gHashTag/tt-trinity-corona/docs/REPORT_2026-06-03_loop130.md

# Loop 130 Report -- 2026-06-03

## Summary

**Measured the end-to-end accuracy impact of the gf16_mul rounding-overflow defect on
the actual MAC primitive (executes the prior loop's Option B) -- turning "0.072% of
products halved" into the number a respin decision needs. Built two study variants of
the dot-product unit -- `gf16_dot4_v2` (gf16_v2_mul + gf16_v2_add, fully corrected)
and `gf16_dot4_b` (gf16_v2_mul + the original gf16_add, to isolate the mul fix) --
and ran the shipped `gf16_dot4` against both over 20000 representative near-1.0
4-term dot products vs an exact-rational reference (`test/impact_gf16_mul.py`).
Result: the shipped MAC path runs at NMSE 1.49e-4 (~1.22% RMS); fixing the mul alone
drops it to 1.29e-6 (~0.11% RMS) -- a ~115x NMSE / ~11x RMS improvement; the gf16
floor (both fixed) is 5.33e-7 (~0.07%). The mul defect DOMINATES the MAC error
despite hitting only 0.27% of dot products, because halving a term is a huge
per-term error. A surprising by-product: this also corrects the earlier claim that
the gf16_add imprecision is "avoided by near-1.0 workloads" -- it actually perturbs
56% of dots, just with tiny per-dot amplitude. Bottom line: a single one-bit-too-
narrow register degrades the shipped gf16 MAC by ~11x in RMS, which materially
strengthens the respin case; `gf16_v2_mul` is the verified drop-in fix.**

## Why

The prior loop found and staged-fixed the gf16_mul defect but only had a per-product
rate (0.072%). A respin go/no-go needs the workload-level number, not a per-op rate.
Measuring on `gf16_dot4` (the real MAC the tiles/mesh instantiate) with an exact
reference produces that number and, by running mul-fixed-only vs fully-fixed,
attributes the error between the two gf16 defects cleanly.

## Implementation (in tt-trinity-gamma)

- `src/gf16_dot4_v2.v` (gf16_v2_mul + gf16_v2_add) and `src/gf16_dot4_b.v`
  (gf16_v2_mul + original gf16_add) -- study modules; the frozen `gf16_dot4` /
  `gf16_mul` / `gf16_add` are untouched.
- `test/impact_gf16_mul.py` -- 20000 deterministic near-1.0 (exp in bias-3..+1)
  4-vectors through A/B/C via iverilog, each compared to an exact `Fraction` dot
  product; reports NMSE + RMS per variant and the affected-dot footprint, attributing
  mul (A!=B) vs add (B!=C).

## Verification

```
A shipped     (gf16_mul + gf16_add)    NMSE 1.49e-4  RMS ~1.22%
B mul-fixed   (gf16_v2_mul + gf16_add) NMSE 1.29e-6  RMS ~0.11%
C fully-fixed (gf16_v2_mul+v2_add)     NMSE 5.33e-7  RMS ~0.07%  (gf16 floor)
mul-overflow footprint (A!=B): 0.27% of dots ; add footprint (B!=C): 56% of dots
=> mul defect dominates the error (115x NMSE cut by fixing it alone)
frozen gf16 units untouched; gamma commits 7351381, 74a1538
```

## Research (this loop, web available)

The instructive twist is footprint vs. magnitude: the add bug is high-frequency
(56% of dots) but sub-ULP per dot, while the mul bug is rare (0.27%) but halves a
term -- so an NMSE (squared-error) metric is dominated by the rare-but-large mul
defect, the opposite of what the affected-count suggests. Reporting only "% of dots
affected" would have mis-ranked them; the energy-weighted metric is what a numerical
workload actually feels. This is the standard lesson that error *rate* and error
*norm* are different questions (Higham, *Accuracy and Stability of Numerical
Algorithms*): a sparse catastrophic error usually beats a dense tiny one in any
2-norm-based downstream (NMSE, loss, activation). It also reinforces that the
representative input distribution matters -- the same defect measured on adversarial
inputs would read very differently; near-1.0 MAC operands are the honest regime.

## Metrics

- gf16 shipped MAC dot-product accuracy: ~1.22% RMS (NMSE 1.49e-4)
- with gf16_mul fix alone: ~0.11% RMS (~11x better; ~115x NMSE)
- gf16 precision floor (both fixed): ~0.07% RMS
- mul-bug dot footprint 0.27%; add-bug dot footprint 56% (low amplitude)
- frozen sources untouched; verified fix = gf16_v2_mul
- Days to deadline: 19

---

## Three Collaboration Options for the Next Loop

### Option A: Respin decision brief (now fully quantified)
Both active silicon defects have proof, scope, a verified drop-in fix, AND now a
workload-level impact: gf16_mul = ~11x MAC RMS degradation (strong respin driver),
bitnet = 16/32 neurons aliased (demo, latent). Assemble the one-page per-die go/no-go
(Gamma/Euler carry both; Phi carries gf16_mul via gf16_dot4 but not bitnet) with the
numbers and the staged fixes. This is the natural close -- every input a decision
needs is now in hand.

### Option B: Task-level impact (classification flips)
Push past NMSE to a task metric: run the bitnet demo path (or a small MNIST-style
classifier) end to end with shipped vs gf16_v2 gf16 and count output/label changes,
so the impact is stated as "X% of inferences change" rather than a dot-product RMS.
Heavier (needs a workload harness) but the most decision-legible framing.

### Option C: Wind down -- impact is quantified, fixes are staged
All four dies audited; two active silicon defects found, characterized, fixed (v2),
and now impact-quantified (gf16_mul ~11x MAC RMS); Corona lint-clean. Nothing further
is measurable without scheduling a respin. Pause the cron and resume near silicon
(~Nov 2026); the brief (A) and task study (B) can wait until a respin is on the
calendar.
