gHashTag/tt-trinity-corona/docs/REPORT_2026-06-03_loop111.md

# Loop 111 Report -- 2026-06-03

## Summary

**Datasheet/pinout accuracy audit (executes Loop 110 Option B) -- found and fixed a real misrepresentation. Both `info.yaml` and `docs/info.md` labelled `uio[7:0]` as "D2D TX/RX to Gamma", but the RTL has NO D2D (deferred, ADR-0006). The silicon actually drives `uio[7:0]` = the anchor high byte `0x47` during the anchor probe (`uio_oe=0xFF`) and leaves `uio` as inactive inputs otherwise. The published pin metadata therefore described an unimplemented feature and omitted the real function. Corrected `info.yaml` pin labels and header comment, fixed the `info.md` D2D prose, added an as-built pin map table, and marked the external-hardware D2D section as deferred/future. Documentation + metadata only; no RTL/test changes.**

## The misrepresentation (verified against RTL)

`tt_um_trinity_corona.v`:
- `uio_oe = is_anchor_cmd ? 8'hFF : 8'h00;` -- `uio` are outputs ONLY during the
  anchor probe, inputs otherwise.
- `uio_out = ANCHOR_UIO (0x47)` during anchor, else `0x00`.
- `uio_in` is unused (`_unused = &{uio_in, ...}`); no D2D logic anywhere.

So `uio[7:0]` carry the anchor high byte `0x47` during the `0x7F` probe and are
inactive inputs otherwise. The `d2d_tx_*/d2d_rx_*` labels were aspirational (the
deferred two-die plan), not what the shipped silicon does.

## Implementation

- `info.yaml` -- uio labels `d2d_tx_n/d2d_rx_n` -> `anchor_hi_bn (d2d_* future)`;
  header comment rewritten to state the as-built `uio` function and that D2D is
  deferred (ADR-0006). YAML still parses (24 pinout keys).
- `docs/info.md` --
  - "How it works": D2D sentence rewritten as deferred, with the real anchor-byte
    `uio` behaviour;
  - "How to test": added an **as-built pin map** table (ui/uo/uio direction + function);
  - "External hardware": the D2D section prefixed as the deferred future plan.

## Verification

```
RTL check: uio_oe=0xFF only on anchor; uio_out=0x47 on anchor; uio_in unused; no D2D
info.yaml: parses, 24 pins; labels reflect as-built + future-D2D note
info.md: D2D marked deferred; pin map added; no stale "D2D adapter on uio" claim
banned-word lint: CLEAN
RTL / tests / generated artifacts: untouched
```

## Research (this loop, web available)

A datasheet's pinout must describe the **as-built** silicon, not aspirational
features: pins labelled for a function that the netlist does not implement are a
classic source of bring-up confusion and incorrect board designs. The fix follows
the same single-source/honesty discipline used throughout -- the pin docs now
match the RTL's actual `uio` driving (anchor byte) and explicitly defer D2D to
ADR-0006, rather than advertising an interface the chip cannot perform.

Sources: [Datasheet pinout conventions](https://en.wikipedia.org/wiki/Datasheet),
[TinyTapeout info.yaml / pinout](https://tinytapeout.com/specifications/).

## Metrics

- Pin-doc misrepresentations fixed: 8 uio labels + 2 prose sections (info.yaml + info.md)
- As-built artifacts added: 1 pin-map table; D2D correctly marked deferred (ADR-0006)
- info.yaml integrity: parses, 24 pins
- Code/RTL/test changes: 0 (documentation + metadata only)
- Days to deadline: 19

---

## Three Collaboration Options for the Next Loop

### Option A: Wind down to maintenance cadence (strongly recommended)
The chip is submission-/review-ready and the docs are now accurate down to the
pin map. Verification (18 CI gates, 5 evidence layers, mutation-tested), the
decision trail (9 ADRs), the timing harness, and the datasheet are all consistent
and self-maintaining. Remaining real work needs silicon (~Nov 2026): the Fmax
sweep, the four-die anchor measurement (Phase G), the ORConf 2026 talk.
**Recommendation: pause the cron (`CronDelete ac1d89dd`) and resume near silicon.**

### Option B: Add a pin-doc consistency CI guard
A small check that `info.yaml` pinout + the `info.md` pin map agree with the
top-module port directions (and that "D2D" is marked deferred while no D2D RTL
exists), so this class of pin-doc drift is caught automatically rather than by audit.

### Option C: fmt_id generation, when cocotb is runnable
Generate `fmt_ids.vh` + `fmt_ids.py` from one source and adopt it in the test
files -- only where the cocotb suite can be run to verify the refactor (the Loop
85 guard keeps it correct until then).
