gHashTag/tt-trinity-corona/docs/REPORT_2026-06-02_loop50.md

# Loop 50 Report -- 2026-06-02

## Summary

**Created SDC constraint file (critical gap).** Audit found zero SDC constraints -- root cause of 20 setup violations and 396 slew violations in GDS. Created `src/constraint.sdc` with proper timing constraints (25 MHz clock, I/O delays, max transition, max fanout). Added `BASE_SDC_FILE` to config.json. Research confirmed Metal5 is strictly forbidden for user tiles on TTGF26a -- added `FP_PDN_MULTILAYER: false` to suppress Metal5 power straps. CI remains 6/6 green (no RTL changes).

## Critical Finding: Missing SDC

No `.sdc` file existed anywhere in the project. LibreLane was using auto-generated constraints from CLOCK_PERIOD/CLOCK_PORT only -- no input/output delays, no max transition, no max fanout. This is the root cause of all GDS timing violations:

| Pre-Repair Violation | Count | OpenROAD RSZ Action |
|---|---|---|
| Slew violations | 396 | Inserted 387 buffers |
| Fanout violations | 47 | Resized 362 instances |
| Setup violations | 20 | Repaired all 20 (100%) |
| Hold violations | 0 | None needed |

While OpenROAD repaired all violations, proper SDC constraints will reduce the repair burden and improve timing margin.

### New SDC: `src/constraint.sdc`

```tcl
create_clock -name clk -period 40.0 [get_ports clk]
set_input_delay  -clock clk -max 10.0 [get_ports {ui_in[*] uio_in[*] rst_n ena}]
set_input_delay  -clock clk -min  1.0 [get_ports {ui_in[*] uio_in[*] rst_n ena}]
set_output_delay -clock clk -max 10.0 [get_ports {uo_out[*] uio_out[*] uio_oe[*]}]
set_output_delay -clock clk -min  0.0 [get_ports {uo_out[*] uio_out[*] uio_oe[*]}]
set_max_transition 10.0 [current_design]
set_max_fanout 16 [current_design]
```

I/O delays set to 25% of clock period (10 ns) -- conservative for TT's RP2040 MUX interface.

## Metal5 PDN Fix Attempt

Research confirmed: **Metal5 is strictly forbidden** for user designs on TTGF26a. TT handles Metal5 power distribution at the top level. Our tile's PDN was generating Metal5 straps, causing precheck failure.

**Fix**: Added `FP_PDN_MULTILAYER: false` to config.json to suppress multi-layer PDN generation. The TT template DEF already provides power pin geometry. For our low-utilization design (2,308 cells, ~14% of 4x4 budget), stdcell Metal1 rails should suffice.

### Updated `src/config.json`

```json
{
  "CLOCK_PERIOD": 40,
  "CLOCK_PORT": "clk",
  "BASE_SDC_FILE": "dir::constraint.sdc",
  "FP_SIZING": "absolute",
  "DIE_AREA": "0 0 1440.32 736.96",
  "RT_MAX_LAYER": "Metal4",
  "FP_PDN_MULTILAYER": false
}
```

## Research Findings

### Timing Closure for GF180MCU

- Typical clock period: 24 ns (~42 MHz) for GF180MCU reference designs. Our 40 ns (25 MHz) has good margin.
- Key resizer parameters if setup violations persist: `PL_RESIZER_MAX_SLEW_MARGIN=50`, `GLB_RESIZER_SETUP_SLACK_MARGIN=0.2`
- OpenROAD AutoTuner can auto-sweep PPA parameters using ML-based optimization
- Reducing `PL_TARGET_DENSITY` (try 0.45) gives router more room for buffer insertion

### TTGF26a Precheck Rules

- Metal5 strictly forbidden for user tiles (reserved for TT power grid)
- Power pins: vertical Metal4 stripes, starting within bottom 10 um, extending to top 10 um
- Shuttle opened 2026-04-17, closes **2026-06-22**, chips expected ~2026-10-01
- Precheck repo: wafer-space/gf180mcu-precheck

### New Format Standards (2026)

- OCP MX remains at v1.0 (no 1.1 found)
- MXFP4 accuracy gap vs NVFP4: software fixes proposed (Overflow-Aware Scaling, Macro Block Scaling) -- arxiv 2603.08713
- **IEEE P3109 formally verified in Lean 4** (FLoPS, Feb 2026) -- proves rounding, projection, saturation semantics. Discovered FastTwoSum exact overflow-error property under saturation. Code: rutgers-apl/FLoPS

### Formal Verification Advances

- Infineon (Dec 2025): RTL-to-RTL FPU verification using divide-and-conquer decomposition
- FLoPS found ExtractScalar fails for 1-bit precision formats -- relevant for our oracle's edge-case coverage
- OpenSTA 2.7.0: new `-probe` option for timing exception debugging

## Weakness Audit Results

| Finding | Severity | Status |
|---|---|---|
| No SDC constraints file | CRITICAL | **FIXED** -- created constraint.sdc |
| Metal5 PDN straps in GDS | CRITICAL | FIX DEPLOYED -- FP_PDN_MULTILAYER=false |
| No BASE_SDC_FILE in config | MEDIUM | **FIXED** -- added to config.json |
| fv_fp6_e3m2 low assert count | LOW | NOT A GAP -- has complete golden check |
| fv_e8m0 low assert count | LOW | NOT A GAP -- has complete golden check |

## Verification Status

```
Verilator lint:        PASS (0 warnings)
Icarus compile:        PASS
Yosys synthesis:       PASS (2,308 cells, unchanged)
GLS smoke test:        PASS (76/76 -- CI green)
ROM golden:            PASS (80/80 -- CI green)
Formal (sby):          PASS (19 configs, 44 tasks -- all prove)
Cocotb:                PASS (44 tests)
GitHub CI:             PASS (6/6 green, latest: #26775120071)
GitHub GDS:            PENDING (new push with SDC + PDN fix)
```

## Metrics

- SDC constraint file created: 1 (was 0)
- Config changes: BASE_SDC_FILE + FP_PDN_MULTILAYER
- RTL changes: 0
- Synthesis: 2,308 cells (unchanged)
- CI status: 6/6 GREEN
- Days to deadline: 20

---

## Three Collaboration Options for Next Loop

### Option A: Validate GDS with SDC + PDN Fix

This push includes two potentially game-changing GDS fixes: (1) proper SDC constraints reducing timing violations, and (2) FP_PDN_MULTILAYER=false suppressing Metal5 straps. The GDS run triggered by this push will reveal whether either/both work. If FP_PDN_MULTILAYER is not recognized by LibreLane, try alternative approaches: custom PDN_CFG TCL file with Metal3/Metal4 only, or contact TT team on Discord. If the SDC constraints cause issues, adjust I/O delays or remove max_transition. This is the critical path -- without precheck passing, submission fails.

### Option B: Add NVFP4 + MXFP4 to ROM + Post-Silicon Test Script

Two parallel tracks: (1) Add NVFP4 (E2M1+FP8 scale, block=16) and MXFP4 (E2M1+block scale, block=32) as ROM records 80-81. Both are production-deployed formats. (2) Create a tt-commander Python test script for post-silicon validation -- exercise all 80 ROM entries and 18 decoders through the serial protocol, comparing against golden expected values. This prepares for silicon arrival (~October 2026) while expanding the catalog.

### Option C: IEEE P3109 Edge-Case Coverage + Timing Optimization

Research found IEEE P3109 formally verified in Lean 4, revealing that ExtractScalar fails for 1-bit precision formats and FastTwoSum has novel behavior under saturation. Use these findings to: (1) Add edge-case test vectors derived from P3109 formal properties to the cocotb test suite. (2) If GDS timing violations persist, add resizer margin parameters (`PL_RESIZER_MAX_SLEW_MARGIN=50`, `GLB_RESIZER_SETUP_SLACK_MARGIN=0.2`) and reduce `PL_TARGET_DENSITY` to 0.45 for better buffer insertion room.
