gHashTag/tt-trinity-corona/docs/REPORT_2026-06-01_loop32.md

# Loop 32 Report — 2026-06-01

## Summary

Comprehensive audit of all LUT-based decoders: **5/5 correct** (nf4, fp4, bitnet, bcd, posit8). Found and fixed a protocol-level weakness: **byte_count > 4 not rejected**, causing silent data loss with malformed host commands. Tightened all formal liveness bounds from 21 to 12 cycles. Added P13 (data_cnt clamp property). Research confirmed NF4/MXFP8/Posit8 golden values and identified Posit(8,0) vs Standard(8,2) documentation gap.

## Fixes Applied

### 1. byte_count Clamp (Protocol Hardening)

**Problem**: The CMD2 state accepted `ui_in[3:0]` (0-15) as `data_cnt`, but the shift register is 32 bits (4 bytes). If host sends byte_count=5..15, the FSM accepts all bytes but only the last 4 are retained — silent data loss.

**Fix**: Clamp data_cnt to 4 in CMD2:
```verilog
data_cnt <= (ui_in[3:0] > 4'd4) ? 4'd4 : ui_in[3:0];
```

**Impact**: No current format uses > 3 bytes, so no functional change for valid inputs. But a malformed command no longer silently loses data — the FSM clamps and processes the last 4 bytes deterministically.

### 2. Tightened Formal Bounds

With byte_count clamped to 4, the worst-case transaction path changes:

| Path | Old | New |
|---|-----|-----|
| Decode (max) | 1+15+4+1 = 21 cycles | 1+4+4+1 = 10 cycles |
| ROM readback | 1+0+10+1 = 12 cycles | 1+0+10+1 = 12 cycles (unchanged) |

Updated properties:
- **P10**: Liveness bound 21 → 12
- **P13** (new): `data_cnt <= 4` in DATA state
- **AI2**: Timer + data_cnt ≤ 16 → ≤ 5
- **AI3** (decode): Timer ≤ status_cnt + 16 → ≤ status_cnt + 5
- **AI4**: Timer in DONE ≤ 20 → ≤ 11
- **Cover C3**: data_cnt == 15 → data_cnt == 4 (15 no longer reachable)

### 3. FSM Edge Case Audit Results

Full audit of reset, metastability, byte ordering, bounds, timing, underflow, and output states:

| Check | Verdict |
|---|---|
| Reset behavior | Safe — all 6 registers cleared |
| Metastability | Safe by TT convention (mux provides synchronization) |
| Shift register byte ordering | Safe — little-endian, internally consistent |
| Invalid format index | Safe — default case returns NOT_IMPL |
| ROM address bounds | Safe — default returns 0x00 |
| Output timing | Safe — no glitch hazards from registered inputs |
| data_cnt underflow | Safe — transition before decrement |
| Pin states | Safe — all pins driven in all states |

Two informational findings documented:
- Anchor probe responds combinationally even when ena=0 (likely intentional)
- P6 bound is looser than AI7 (cosmetic, not wrong)

## Decoder LUT Audit

| Decoder | Entries | Verdict |
|---|---|---|
| nf4_decode.v | 16 FP32 quantiles | All match QLoRA/bitsandbytes |
| fp4_decode.v | 16 E2M1 values | All match OCP MX spec |
| bitnet_decode.v | 4 ternary values | Correct |
| bcd_decode.v | Combinational (tens×10+ones) | Correct for all 100 valid inputs |
| posit8_decode.v | 256 combinational paths | Correct for all inputs |

**No bugs found.** The LNS8 LUT (fixed in Loop 31) was the only decoder with errors.

## Research Findings

### Posit(8,0) vs Posit(8,2)
The 2022 Posit Standard fixes es=2 for all precisions, including 8-bit. Our decoder implements Posit(8,0) (pre-standard, widely used in ML). Both are valid choices but the difference should be documented. The ROM record for Posit8 should specify "es=0" explicitly.

### NF4 Values Confirmed
The QLoRA quantile table has no known errata. A 2023 paper critiques theoretical optimality but confirms empirical values. Our golden reference matches exactly.

### LNS8 Not Standardized
No industry standard exists for 8-bit LNS. Our Q3.4 format with round-to-nearest LUT is mathematically sound. Recent papers (DATE 2025, NeurIPS 2024) explore different bit allocations (4+3 vs 3+4) — our choice should be labeled experimental.

### MXFP8 / E8M0 Confirmed
OCP MX v1.0 spec confirms our E4M3 decode rules (bias=7, NaN only at 0x7F/0xFF). Our MXINT8 -128→NaN convention is project-specific, not spec-mandated.

### Corona is First TT Project with Formal CI
No published Tiny Tapeout project uses formal verification in its CI pipeline. This is a distinguishing strength.

## Verification Status

```
Yosys synthesis:     PASS (0 errors)
Verilator lint:      PASS (0 warnings)
Iverilog compile:    PASS (0 errors)
Formal (sby):        Pending CI (not available locally)
Cocotb tests:        Pending CI (not available locally)
```

## Metrics

- Properties: 13 (P1-P13) + 7 auxiliary invariants + 8 cover points + 4 ROM properties
- Decoders audited: 6/18 (LNS8 + 5 this loop)
- RTL bugs found: 0 new (1 cumulative — LNS8 from Loop 31)
- Protocol hardening: 1 (byte_count clamp)
- Days to deadline: 21

---

## Three Collaboration Options for Next Loop

### Option A: Remaining 12 Decoder Deep Audit
Audit the 12 decoders not yet independently verified from first principles: bf16, tf32, fp8_e5m2, fp8_e4m3_fnuz, fp6_e3m2, fp6_e2m3, int4, int8, e8m0, mxint8, mxfp8_e4m3, fp4_ml. Focus on edge cases (subnormals, NaN/Inf, max/min values) using OCP MX spec and IEEE 754 tables.

### Option B: Push + GDS Hardening (Critical Path)
Resolve GitHub auth (`gh auth login`), push all 40+ commits, trigger TT GDS hardening action. Validate synthesis cell count against 4×4 tile budget (~16,000 cells). This unblocks the submission deadline (June 22).

### Option C: Gate-Level Simulation + Equivalence Checking
Set up Yosys `synth -top tt_um_trinity_corona -flatten` → generic cells, then run equivalence check (`equiv_make` + `equiv_induct`) between RTL and gate-level netlist. This catches synthesis mismatches that formal and cocotb cannot detect.
