gHashTag/tt-trinity-corona/docs/REPORT_2026-06-01_loop20.md

# Loop 20 Report — 2026-06-01

## Summary

Added INT4 signed decoder (fmt_id=46). Achieved **zero Verilator lint warnings**
across all 20 RTL modules — production-ready lint cleanliness. Fixed BCD width
overflow, posit8 unused bits, and top-level _unused wire. Fixed stale metadata
(gen_rom.py comment 77→80, info.yaml decoder count). 38/38 tests pass.

## Implemented

### INT4 Signed Decoder (`src/rtl/int4_decode.v`)

Two's complement 4-bit sign extension to INT32. Range [-8, +7]. Used by GPTQ,
AWQ, SqueezeLLM for LLM weight quantization. ~2 cells (pure wire replication).

| Input | Decimal | INT32 Output |
|---|---|---|
| 0x0 | 0 | 0x00000000 |
| 0x7 | +7 | 0x00000007 |
| 0x8 | -8 | 0xFFFFFFF8 |
| 0xF | -1 | 0xFFFFFFFF |

### Verilator Lint Audit (0 Warnings)

| Module | Issue | Fix |
|---|---|-----|
| tt_um_trinity_corona | `data_in_buf[7:0]` unused | Added to `_unused` wire |
| bcd_decode | `tens_x10[7]` carry unused | Narrowed wire from 8→7 bits |
| posit8_decode | `shifted[0]` unused | Added `_unused` wire |
| posit8_decode | `fp32_exp_signed[8]` unused | Changed to unsigned, added to `_unused` |

All 20 modules now pass `verilator --lint-only -Wall` with zero warnings.

### Metadata Fixes

- gen_rom.py line 4: "77 records" → "80 records"
- info.yaml description: "15 Tier-1 RTL decoders" → "18 Tier-1 RTL decoders"
- ROM record fmt_id=46: added FLAG_ON_DIE

## Research Summary (Loop 20)

### INT4 for LLMs — No Standard, One Encoding
GPTQ, AWQ, SqueezeLLM all use signed two's complement INT4 [-8,+7] with
group-wise scaling (groups of 128). MXINT4 does not exist in OCP MX v1.0.
Our INT4 decoder covers the dominant wire format.

### GF180MCU Gotchas
- PDK is alpha/experimental — known DRC pitfalls with diffusion/tap abutting
- Metal 5 reserved by TT power grid (we don't control routing)
- Max frequency ~40-80 MHz at 180nm; 50 MHz target is reasonable
- LibreLane 3.0 (Mar 2026) is the recommended flow for GF180MCU

### Format-Aware Compression
ZipNN extended to FP8/FP4 (Intel, Aug 2025): lossless compression by
independently entropy-coding exponent vs mantissa fields. Our format oracle
could tag which compression scheme applies to each format — future ROM
metadata extension.

### Open-Source EDA Updates
LibreLane 3.0 (FOSSi Foundation) replaced OpenLane for GF180MCU. OpenROAD
enabled 600+ tapeouts. wafer.space GF180MCU Run 2 announced May 2026.

## On-Die Decoder Coverage

| Category | Formats | Decoders | fmt_ids |
|---|---|---|---|
| ML low-precision | BF16, TF32, E5M2, E4M3, FNUZ, FP6×2, FP4 | 7 unique + 2 aliases | 8-14, 69, 77 |
| OCP MX | MXFP8, MXFP6, MXFP4, E8M0, MXINT8 | 5 unique | 39-41, 78-79 |
| Posit | Posit8(es=0) | 1 unique | 31 |
| LNS | LNS8 | 1 unique | 42 |
| Integer/Fixed | **INT4**, INT8, BCD | 3 unique | **46**, 47, 53 |
| Compression | NF4×2, FNUZ-alt, BitNet | 1 unique + 2 aliases + 1 | 70-71, 75 |
| **Total** | **23 fmt_ids** | **18 unique + 5 aliases** | |

## Metrics

- **On-die decoders**: 23 fmt_ids (18 unique modules + 5 aliases)
- **Tests**: 38 (4 anchor + 27 decoder + 7 stress)
- **Verified values**: 69,024 exhaustive + 68 stress
- **Verilator**: 0 warnings (-Wall, 20 modules)
- **Generic cells**: ~2,900 (estimated; +~75 from INT4+mux)
- **Commits**: 25 on main (23 ahead of origin)
- **RTL files**: 20 Verilog modules
- **Deadline**: 2026-06-22 (21 days remaining)

## Three Collaboration Options for Next Loop

### Option A: Push to GitHub (CRITICAL — 23 Unpushed Commits)
Run `! gh auth login` in the prompt. **23 unpushed commits** = the entire
design. This is no longer just a risk — it's a liability. One `rm -rf` or
disk corruption loses everything. After push, CI runs lint+tests+GDS
automatically. **This should happen before any more implementation work.**

### Option B: Add CI Verilator Lint Step
Add `verilator --lint-only -Wall` to `.github/workflows/ci.yml`. This
ensures no future commits introduce lint warnings. Also pin cocotb version
in CI to 2.0.1 (currently unpinned, may conflict with TT's 1.9.2).

### Option C: D2D Protocol Skeleton (Phase D)
Begin Phase D: create `src/rtl/d2d_corona_adapter.v` stub for die-to-die
communication with Gamma. Route fmt_ids with FLAG_GAMMA|FLAG_D2D through
`uio[3:0]` TX / `uio[7:4]` RX. This is the next major architecture
milestone from PLAN.md.
