gHashTag/tt-trinity-corona/docs/REPORT_2026-06-06_loop156.md

# Loop 156 Report -- 2026-06-06

## Summary

**Depth-robustness check on Defect 1: extended the trained-model study from a
single linear layer to a 2-layer MLP, running BOTH gf16 MAC layers through the actual
RTL. Depth modestly increases prediction churn (0.13% -> 0.22% argmax flips as error
accumulates through two layers) but keeps ZERO net accuracy loss (94.44% identical
across shipped / corrected / exact). The brief's "task-quiet" conclusion now holds
with depth, not just for a single layer.** Trained an MLPClassifier
(15 PCA -> 15 ReLU hidden -> 10) on sklearn digits; quantized weights and inter-layer
activations to gf16; ran every hidden and output logit through `dot16` (shipped) vs
`dot16_v2` (corrected), with gf16 ReLU between layers and the two forward passes kept
fully separate. Over 3 splits / 1350 test samples: the defect is active in both
layers (14802 hidden activations + 11313/13500 output logits differ shipped-vs-v2),
the argmax-flip rate is 3/1350 = 0.22%, and shipped/corrected/exact accuracy are
identical.

## Why

The single-layer result (loop 155, 0.13% flips) left one honest question: error from
a per-MAC defect can ACCUMULATE through layers, so a deeper network might amplify it.
Since the respin recommendation rests on "task-quiet," testing depth-robustness is
the natural stress on that conclusion -- and the only genuinely new, decision-relevant
measurement left after the single-layer number.

## Implementation

- `gamma/test/impact_trained_gf16_mlp.py`: MLPClassifier (15,) on 15 PCA features;
  W1 (15x16 incl. bias), W2 (10x16 incl. bias) quantized to gf16; layer 1 = 15 dot16
  per sample through the RTL, gf16 ReLU (negative code -> 0), re-fed as the 16-dim
  hidden (15 + bias); layer 2 = 10 dot16 per sample. Shipped path uses shipped
  hidden + reads the shipped output; corrected path uses corrected hidden + reads the
  v2 output -- no cross-contamination. Exact = rational dots over the quantized
  operands with exact ReLU + re-quantized hidden.
- Updated `RESPIN_BRIEF_gf_arithmetic.md` Defect-1 section with the depth result.

## Verification

```
DEEPER-MODEL Defect-1 task impact (digits, 2-layer MLP 15->15 ReLU->10), 3 splits:
  per split flip shipped-vs-v2 = 0, 3, 0
AGGREGATE over 1350 test samples:
  accuracy:  shipped 94.44%   v2 94.44%   exact 94.44%   (identical)
  defect active both layers: 14802 hidden + 11313/13500 output logits differ
  argmax-flip shipped vs v2 (2-layer): 3/1350 = 0.222%   (1-layer 0.13%, synthetic 0.24%)
gamma 821f5e6
```

## Research (this loop)

The depth result refines the signal-vs-decision picture from loop 155. Accumulation
is real and visible: a second gf16 layer roughly doubles the argmax-flip rate
(0.13% -> 0.22%), because the hidden activations already carry the first layer's
rounding/halving perturbation when the second layer's near-ties are decided. But two
mechanisms keep it bounded rather than compounding geometrically: (1) ReLU zeroes
roughly half the hidden units, discarding the perturbation on every inactive unit
before it can propagate; (2) the perturbation is a sparse, mean-near-zero ULP-scale
error, so across a 15-term hidden sum it tends to average down rather than reinforce.
The net is a small additive bump in churn with no accuracy cost -- which is the
behaviour you want a numerical defect to have, and the reason a halved-product bug
that looks alarming at 11x MAC RMS is benign at the task level even with depth. For
the respin file this means the "fold the free fix in if a slot opens, but not an
emergency" recommendation is now backed by both a shallow and a deep trained model.

## Metrics

- 2-layer trained Defect-1 argmax-flip: 0.22% (1350 samples) vs 0.13% (1-layer) vs 0.24% (synthetic)
- Accuracy delta shipped vs corrected (2-layer): 0.00 pp (94.44% == 94.44%)
- Defect activity confirmed in both layers (not a dormant test)
- Respin brief Defect-1 section now depth-robustness-checked
- gamma 821f5e6
- Days to deadline: 12

---

## Three Collaboration Options for the Next Loop

### Option A: Wind down -- Defect 1 is now characterized shallow AND deep
The numerical defect's task impact is measured on a synthetic classifier (0.24%), a
trained linear model (0.13%, 0 accuracy delta), and a trained 2-layer MLP (0.22%, 0
accuracy delta). The full audit is complete, consolidated, coverage- and
respin-readiness-verified, with a one-command runner. Every autonomous lever is
exhausted and the respin brief has no open question. Clean stopping point -- pause the
cron (`CronDelete d3317e31`) and hand the brief to the program.

### Option B: Larger/headline workload (MNIST-scale) for a flagship number
If the program wants a published figure on a bigger model, an external MNIST-scale
trained net through the dot16 (or a wider dot) harness would give it. The digits
result already settles the engineering question; this is presentation, not new risk.

### Option C: Resume near silicon (~Nov 2026) for the post-tapeout work
The audit deliverable is done; the next genuinely new work is the physical bring-up
(Fmax sweep, four-die anchor, demoboard) when the dies return -- out of scope for the
current source-only loop, and the reason wind-down is the standing recommendation.
