gHashTag/tt-trinity-corona/docs/REPORT_2026-06-06_loop155.md

# Loop 155 Report -- 2026-06-06

## Summary

**Executed Option C (the user's pick): produced a trained gf16 model + eval set and
measured Defect-1's real task impact, closing the respin brief's last open caveat.
The synthetic ~0.24% argmax-flip proxy is confirmed and sharpened on a TRAINED
classifier: the gf16_mul defect flips only 0.13% of predictions with a negligible
accuracy delta -- even though it is genuinely active.** Trained a LogisticRegression
on the sklearn `digits` dataset (1797 8x8 images, 10 classes; reduced to 15 PCA
features + a bias term = exactly one `dot16`), quantized the trained weights and the
held-out test inputs to gf16, and ran each per-class logit through the ACTUAL silicon
RTL -- `dot16` (shipped gf16_mul + gf16_add) vs `dot16_v2` (corrected gf16_v2_*) --
plus an exact-rational reference over the same quantized operands. Over 5 train/test
splits (2250 test samples): the defect is ACTIVE (73.3% of logits differ shipped-vs-v2
at the ULP level), yet only 3/2250 = 0.13% of argmax predictions flip, and shipped
accuracy (92.76%) vs corrected (92.80%) differ by ~1 sample. (Earlier this loop, before
the user's pick arrived, also shipped `tools/audit_all.py` -- a one-command re-run of
the whole 4-die audit, 12/12 PASS.)

## Why

Every prior task number for Defect 1 came from a synthetic random linear classifier,
whose artificially tight decision margins could over- or under-state the real impact.
The user supplied Option C to settle it with a trained model. Using a real dataset +
learned weights gives realistic margins; running the logits through the actual RTL
(not a Python model) keeps the silicon as the source of truth.

## Implementation

- `gamma/test/impact_trained_gf16.py`: digits -> StandardScaler -> PCA(15) -> +bias
  (16-dim); LogisticRegression; quantize weights + test inputs to gf16 (nearest);
  drive `dot16`/`dot16_v2` RTL per (input, class-weight) pair; argmax; 5 seeds.
- Reused the existing RTL `dot16` harness so no Python gf16-op model is trusted; only
  the exact-rational dot of the quantized operands is computed in Python.
- Updated `RESPIN_BRIEF_gf_arithmetic.md` (recommendation + Defect-1 section) with the
  trained number; the prior "synthetic proxy" caveat is now resolved.

## Verification

```
TRAINED-MODEL Defect-1 task impact (sklearn digits, 15 PCA + bias, LogisticRegression)
  per split (test=450 each):  acc shipped/v2/exact ~92-94%;  flip shipped-vs-v2 = 0,0,1,2,0
AGGREGATE over 2250 test samples (5 splits):
  accuracy vs true labels:  shipped 92.76%   v2 92.80%   exact 92.80%
  DEFECT IS ACTIVE: 16493/22500 logits (73.3%) differ shipped vs v2 (mul defect fires)
  argmax-flip shipped vs v2 (Defect-1 trained number): 3/2250 = 0.133%
  argmax-flip shipped vs exact-quantized             : 3/2250 = 0.133%
                                              (synthetic proxy was ~0.24%)
gamma 64f0763
```

## Research (this loop)

The result is a clean instance of the difference between a SIGNAL-level error metric
and a DECISION-level one. At the logit/ULP level the defect is everywhere -- 73% of
accumulations differ between shipped and corrected -- because the two gf16 rounding
paths disagree by a ULP on most 16-term sums. At the argmax/decision level it is
nearly invisible (0.13%), because a trained softmax classifier separates classes by
margins far larger than a ULP; the sparse halving error only matters in the thin band
where the top two logits are within the perturbation of each other, and training
actively widens that band away from the data. This is why the synthetic random
classifier (no training -> many near-ties) over-stated the impact at 0.24%, and a
trained model lands lower. The general lesson for quantization-defect triage: measure
at the decision boundary the product actually makes, not only at the arithmetic
output -- an 11x RMS MAC error and a 0.13% decision-flip rate are both true of the
same defect.

## Metrics

- Trained-model Defect-1 argmax-flip: 0.13% (2250 samples, 5 splits) vs synthetic 0.24%
- Accuracy delta shipped vs corrected: 92.76% vs 92.80% (~1 sample / 2250)
- Defect activity confirmed: 73.3% of logits differ at ULP level (not a dormant test)
- Respin brief caveat: CLOSED
- gamma 64f0763; also shipped tools/audit_all.py (12/12 audits PASS)
- Days to deadline: 12

---

## Three Collaboration Options for the Next Loop

### Option A: Wind down -- audit complete + Defect-1 task number now measured on a trained model
With Option C done, the last open question in the respin brief is resolved: the
gf16_mul defect is task-quiet (0.13% flips, ~0 accuracy delta) on a trained
classifier. The audit is complete, consolidated, coverage- and respin-readiness-
verified across four dies, with a one-command runner. There is no remaining
autonomous lever. Clean stopping point -- pause the cron (`CronDelete d3317e31`) and
hand the brief to the program.

### Option B: Extend the trained-model study to the OTHER defects/paths
The same trained-RTL harness could quantify bitnet_encoder_v2 (the neuron-aliasing
defect) on a real task, or measure the gf16 path on a deeper model (a 2-layer MLP via
chained dot16) if a higher-fidelity number is wanted. Diminishing returns -- Defect 1
is the only numerical one and it is now settled.

### Option C: Provide a larger trained workload (MNIST-scale) if a headline number is needed
The digits result is solid; if the program wants a flagship figure on a bigger model,
an external MNIST-scale trained net + the dot16 (or a wider dot) harness would give it.
