gHashTag/tt-trinity-corona/docs/REPORT_2026-06-06_loop154.md

# Loop 154 Report -- 2026-06-06

## Summary

**Verified the last unchecked property of the deliverable: the staged `*_v2` fixes
are RESPIN-READY, not merely functionally correct. Every v2 module is R-SI-1 clean
(no datapath `*`), free of the harmful width-defect class (WIDTHTRUNC/SELRANGE), and
has no inferred latches. The only nit -- a missing trailing newline in gamma's
`bitnet_encoder_v2.v` (verilator EOFNEWLINE) -- is fixed.** Functional correctness of
the fixes was already established (each has a verifying test + CI gate); what had not
been explicitly checked is whether the fixes themselves satisfy the design rules a
respin must meet. They do: the project's no-star checker passes (the only `*` are
constant loop-index / bit-select patterns, exempt and identical to the frozen
originals), `width_gate.py` passes on all three compute dies, and a direct verilator
-Wall pass shows no latch warnings -- the remaining notes are benign WIDTHEXPAND
(safe sign/zero extension inherited from the shipped originals). Recorded the
respin-readiness result in `AUDIT_COMPLETE.md`.

## Why

A staged fix that is functionally correct but violates a synthesis/design constraint
(a `*` under R-SI-1, an inferred latch, a width truncation) would fail or corrupt a
respin. After fix-coverage was confirmed complete (loop 153), this is the remaining
property that determines whether the fixes can actually be dropped into a shuttle.

## Implementation

- Scanned every `*_v2.v` across the three dies for standalone `*`; all hits are
  `i*32` / `k*64` / `2*i+1` index/bit-select constants (R-SI-1 exempt, same as the
  frozen originals).
- Ran the project's own gates that glob `src/*.v` (so they cover the v2 files):
  gamma no-star PASS; width_gate.py PASS on gamma/euler/phi.
- Direct verilator -Wall per v2 module: no LATCH warnings; only benign WIDTHEXPAND +
  one EOFNEWLINE.
- Fixed the EOFNEWLINE (appended a trailing newline to `bitnet_encoder_v2.v`);
  re-linted -> cleared.
- Added a "Respin-readiness of the staged fixes" note to `AUDIT_COMPLETE.md`.

## Verification

```
no-star (R-SI-1)   : PASS (gamma checker); v2 '*' are exempt index/bit-select constants
width_gate.py      : PASS on gamma, euler, phi  (harmful WIDTHTRUNC/SELRANGE class)
verilator -Wall v2 : no inferred latches; remaining notes = benign WIDTHEXPAND
bitnet_encoder_v2  : EOFNEWLINE fixed -> cleared
                                                          (gamma a9831a0)
```

## Research (this loop)

The WIDTHEXPAND vs WIDTHTRUNC distinction is the crux of why this check matters and
why it came back clean. Width EXPANSION (assigning a narrow value into a wider lvalue)
is a safe, lossless sign/zero extension -- the synthesizer pads the high bits. Width
TRUNCATION (a value wider than its destination) silently drops high bits and is the
exact archetype of this whole audit's defects (gf16_mul mantissa, bitnet neuron base,
gf_formats IDs -- "a field one bit too narrow"). A linter that reports both as
"WIDTH..." can mask the difference; the project's `width_gate.py` deliberately gates
only the truncation/out-of-range-select class, which is why it stays green on the v2
fixes (they only widen) while still catching the harmful pattern. The fixes adding
WIDTHEXPAND notes is expected -- e.g. bitnet_encoder_v2 widens the neuron address
path, which is the fix.

## Metrics

- v2 modules checked for respin-readiness: all (gf16_v2_mul/add, bitnet/blake3/
  multi_tile/alu9_v2, phi_d2d_lite_v2) -- R-SI-1 clean, no latch, no harmful width
- Issues found/fixed: 1 cosmetic (EOFNEWLINE) -> fixed
- Audit status: COMPLETE + consolidated + fix-coverage verified + respin-readiness verified
- gamma a9831a0
- Days to deadline: 12

---

## Three Collaboration Options for the Next Loop

### Option A: Wind down -- nothing left to verify autonomously
The audit is complete across four dies, consolidated in `AUDIT_COMPLETE.md`, fix
coverage is proven complete, and the staged fixes are confirmed respin-ready
(R-SI-1 / width / latch clean). Every autonomous lever has been exhausted. The
correct stopping point -- pause the cron (`CronDelete d3317e31`) and hand the brief +
audit index + CI gates to the program.

### Option B: One-command audit runner (`test/audit_all.py`)
Still the only remaining non-trivial convenience artifact: a single entry point that
runs every audit in every die repo and prints one pass/fail summary. No new findings,
just easier re-validation for a reviewer.

### Option C: Provide a trained gf16 model + eval set (numerical respin number)
Still the one external lever for sharpening Defect 1's task-level impact beyond the
synthetic proxy (~0.24% argmax flips).
