gHashTag/tt-trinity-corona/docs/REPORT_2026-06-06_loop153.md

# Loop 153 Report -- 2026-06-06

## Summary

**With the per-block audit complete across all four dies, this loop checked the
DELIVERABLE itself and consolidated it. The fix-coverage invariant holds: every die
that instantiates a buggy module also carries that module's staged v2 fix -- so a
respin cannot silently re-ship a known-broken block.** Built
`tools/fix_coverage_matrix.py` (cross-die) and confirmed COMPLETE coverage for all 6
defects: gf16_mul/gf16_add v2 on all three compute dies; bitnet/blake3/multi_tile/alu9
v2 on Gamma+Euler; phi_d2d_lite v2 on Phi. Created `docs/AUDIT_COMPLETE.md` -- a
single capstone index of the whole audit: the defect/fix matrix (3 active + 3
latent), the checked-and-clear list, every audit script with its CI job, the method
lessons, and one-command re-run instructions -- and cross-linked it from the respin
brief.

## Why

A post-silicon audit's value is only realized if the staged fixes are actually
complete and the whole thing is discoverable/re-runnable by the program and other
agents. Two real risks remained after the block-by-block work: (1) an affected die
missing a staged fix (the respin would re-ship it broken), and (2) the audit being a
scatter of ~11 scripts across three repos with no map. This loop closes both: a
programmatic coverage invariant and a single index.

## Implementation

- `tools/fix_coverage_matrix.py`: for each (buggy, v2) pair, asserts every die with
  `<buggy>.v` also has `<v2>.v`. Runs from corona over the sibling die repos.
- `docs/AUDIT_COMPLETE.md`: dies table; active/latent defect matrices with
  mechanism/impact/fix; checked-and-clear inventory; audit-script -> CI-job table;
  re-run block; method lessons.
- Cross-linked `AUDIT_COMPLETE.md` + the coverage tool from `RESPIN_BRIEF_gf_arithmetic.md`.

## Verification

```
== respin fix-coverage matrix ==
gf16_mul/gf16_add        : BUG+FIX on gamma, euler, phi
bitnet/blake3/multi_tile/alu9 : BUG+FIX on gamma, euler   (absent on phi)
phi_d2d_lite             : BUG+FIX on phi
FIX COVERAGE COMPLETE: every affected die carries its staged v2 fix.   (rc=0)

corona 85da82f
```

## Research (this loop)

No new RTL research -- the engineering audit has converged. The consolidation
reflects a verification-management point: a fix that exists in one repo is not the
same as a fix staged on every affected instance, and on a multi-die shuttle built
from a shared module library that distinction is exactly where a respin regresses.
The coverage matrix is the cheapest guard against "fixed it on Gamma, forgot Phi" --
the same class of omission the audit itself kept finding inside the RTL (a field, a
neuron, a die left out). Making it a one-command invariant means the next person
doesn't have to remember the seven affected-module/die combinations.

## Metrics

- Defects with complete cross-die fix coverage: 6/6 (3 active + 3 latent)
- New artifacts: 1 invariant tool + 1 capstone index; respin brief cross-linked
- Audit status: COMPLETE across all four dies, CI-gated, fix-coverage verified
- corona 85da82f
- Days to deadline: 12

---

## Three Collaboration Options for the Next Loop

### Option A: Wind down -- audit complete, consolidated, and coverage-verified
All four dies audited and CI-gated; 6 defects staged with verified fixes; fix
coverage proven complete; one capstone index ties it together. There is no remaining
autonomous engineering lever without external input. This is the clean, well-earned
stopping point -- pause the cron (`CronDelete d3317e31`) and hand the brief +
`AUDIT_COMPLETE.md` + CI gates to the program.

### Option B: One-command audit runner across all dies
A small `test/audit_all.py` (or a corona-side orchestrator) that invokes every audit
script in every die repo and prints a single pass/fail summary, so a reviewer can
re-validate the entire claim in one command. Purely convenience; no new findings.

### Option C: Provide a trained gf16 model + eval set (numerical respin number)
Still the one external lever for sharpening Defect 1's task-level impact beyond the
synthetic proxy (~0.24% argmax flips).
