gHashTag/tt-trinity-corona/docs/REPORT_2026-06-06_loop151.md

# Loop 151 Report -- 2026-06-06

## Summary

**Extended the instantiated-subsystem audit to the THIRD taped-out die, Phi (the
nano die), which had only ever had its shared gf16 path checked. Three Phi-specific
blocks are CORRECT; one (`phi_d2d_lite`, the die-to-die serial link) has a real
TX/RX framing-mismatch bug -- latent on the single-die shuttle.** Also closed last
loop's Option B: NONE of the die-local modules (bitnet/blake3/multi_tile/alu9) exist
in the t27 codegen master, so there is no upstream regen lever for them. `phi_anchor_post`
(the Lucas-chain power-on self-test) passes clean and goes phi_ok=0 on a corrupted
expected value -- a live checker. `sacred_constants_rom`, a 60-entry Q3.5 fixed-point
ROM of mathematical constants, is clean: all 59 residual constants are within +-1
LSB of value*32, the 14 clamp addresses saturate to 0x7F (all their true values >=
3.969), the zero region is clean, and the 0x47 Crown47 watermark is intact -- no
transcription error in 60 entries. `phi_mesh_bridge` (friend/foe auth gate) forwards
only on friend&handshake and otherwise drops with a saturating 0xFF counter. The one
defect: `phi_d2d_lite` RX requires the START bit LOW for two cycles (RX_IDLE detect
+ RX_DETECT_START confirm), but its own TX emits a ONE-cycle START -- so RX consumes
the first data bit as the start-confirm, misaligns the word by one bit, parity never
matches, and the receive path NEVER delivers a packet. Confirmed two ways: TX->RX
loopback delivers nothing for any of six test packets (including all-zeros), and an
externally-driven 2-cycle START delivers correctly. Two Phi dies wired together
could not communicate. It is latent on the current single-die TTSKY26b shuttle (no
second die). `phi_d2d_lite_v2` fixes the RX framing (RX_IDLE -> RX_DATA) and the
loopback round-trips every packet. Verified by `test/phi_audit.py`, wired into Phi CI.

## Why

The audit had covered Gamma and Euler exhaustively but Phi (nano) only via its
shared gf16 path. Auditing Phi's own blocks is what lets the program say the whole
THREE-die instantiated set is characterized, not just the two big dies. Each Phi
block has a checkable contract (a Lucas recurrence, the Q3.5 value of each named
constant, an auth-gate truth table, and a serial framing protocol).

## Implementation

- Confirmed Option B empty: `git ls-files` in t27 shows no spec/RTL for the four
  die-local modules (only gf16 had a t27 source, already fixed).
- `phi_anchor_post`: ran to post_done clean (1 1) and with a corrupted lucas_expect
  (0 1).
- `sacred_constants_rom`: swept all 128 addresses; compared each named residual to
  round(value*32) (+-1 LSB), checked clamp set -> 0x7F, zero region, watermarks.
- `phi_mesh_bridge`: forward / drop / 303-drop saturation.
- `phi_d2d_lite`: TX->RX loopback (delivers nothing) + RX-only with 1- vs 2-cycle
  START (1 -> none, 2 -> correct) to localize the bug; built `phi_d2d_lite_v2` and
  re-ran the loopback (round-trips).
- `src/phi_d2d_lite_v2.v`, `test/phi_audit.py`, `instantiated-audit` CI job on Phi;
  updated `RESPIN_BRIEF_gf_arithmetic.md`.

## Verification

```
phi_anchor_post      : clean=1 1 fault=0 1 (live checker)  -> OK
sacred_constants_rom : 59 consts +-1LSB (clean); clamp 14->0x7F ok; zero ok  -> OK
phi_mesh_bridge      : fwd=aa11aa11 1; foe drop=0 1; saturate=255/255  -> OK
phi_d2d_lite         : shipped TX->RX loopback delivers nothing (RX 2-cycle-start bug);
                       v2 round-trips all  -> BUG CONFIRMED + FIXED
RESULT: POST/sacred/bridge CORRECT; phi_d2d_lite RX framing bug characterized + v2 fix verified
                                                                            (phi 376f27d)
```

## Research (this loop)

The phi_d2d_lite bug is a classic asynchronous-serial start-bit detection error.
A UART-style receiver must sample the start bit ONCE to mark the bit boundary and
then sample each subsequent bit exactly once; robust receivers oversample (e.g. 16x)
and re-confirm the start at the MIDPOINT of the same bit, never at the next bit
boundary. This RX instead re-confirms one full bit-period later (RX_DETECT_START),
which lands on the first data bit -- so a 1-cycle start (1x sampling, which is what
the matching TX produces) is structurally undecodable. The lesson mirrors the rest
of the audit: a transmitter and a receiver are two halves of one contract, and each
must be tested against the other (or against the wire format), not in isolation --
the shipped TX and RX were each "reasonable" but mutually incompatible, which only a
loopback (or a wire-format reference) exposes.

## Metrics

- Phi blocks audited: 4 (phi_anchor_post, sacred_constants_rom, phi_mesh_bridge,
  phi_d2d_lite); 3 correct, 1 latent bug
- Active on-silicon defects: still 3 (gf16_mul, bitnet, blake3); phi_d2d_lite is
  latent (no second die in this shuttle), like multi_tile_receipt / alu9 BIND
- ALL THREE taped-out compute dies' instantiated logic now audited + CI-gated
- t27 backport candidates that exist upstream: 0 of 4 (Option B closed)
- phi 376f27d
- Days to deadline: 12

---

## Three Collaboration Options for the Next Loop

### Option A: Wind down -- all three dies fully audited and CI-gated
Every instantiated block on Gamma, Euler, and Phi is now checked against its contract
and gated in CI; the respin brief is a complete bounded go/no-go (3 active defects +
several latent, all staged). There is no further autonomous engineering lever without
external input. Clean stopping point -- pause the cron (`CronDelete d3317e31`) and
hand the brief + CI gates to the program.

### Option B: Audit Corona (the oracle die) + the remaining shared blocks
Corona (the conformance-oracle die) is lint-clean and submission-complete but its
ROM/decoder logic was never functionally cross-checked the way the compute dies were.
A few shared blocks (`d2d_holo_mesh`, `holo_lut_pe`, `trinity_cortex_8col`,
`nca_entropy_monitor`) on Gamma/Euler also remain. Lower expected yield, but it would
make the audit literally complete across all four dies.

### Option C: Provide a trained gf16 model + eval set (numerical respin number)
Still the one external lever for sharpening Defect 1's task-level impact beyond the
synthetic proxy (~0.24% argmax flips).
