gHashTag/tt-trinity-corona/docs/REPORT_2026-06-06_loop149.md

# Loop 149 Report -- 2026-06-06

## Summary

**Audited the residual instantiated LEAF blocks (host bus, PLL divider, status
register, ternary ALU) -- the last remaining unverified instantiated logic. Three
are CORRECT; one (`alu9_decoder`) has a latent op-semantics bug that is benign on
the shipped silicon.** `phi_pll_div` emits exactly 5 ticks per 8 clocks (0.625 ~
1/phi, the documented Bresenham fractional rate). `wishbone_full` is a correct
WB-lite hub: scratch registers 4..15 read/write, registers 0..3 are read-only
status mirrors, and writes to the RO registers are ignored. `wb_status_reg` packs
the documented status bits and toggles its `alive` liveness bit on each post_done
rising edge. The one defect: `alu9_decoder` op7 TRI_BIND computes `sr = sa ^ sb` --
a bitwise XOR of the two's-complement SIGNED lifts -- instead of the VSA bind,
which over the {-1,0,+1} alphabet this ALU uses is ELEMENTWISE MULTIPLY. That is
wrong for 6 of 9 input pairs, most clearly breaking the multiplicative absorbing
property (bind(x,0) returns nonzero) and giving bind(1,1)=bind(-1,-1)=0 instead of
+1. It is BENIGN on Gamma/Euler: u_alu is wired to random `hwrng_word` bits and its
result is written into `ring27_memory` (a 27-cell entropy ring whose only consumer
is a liveness flag), so no workload depends on the ALU output. `alu9_decoder_v2`
implements BIND as ternary multiply (81/81 vs the reference); frozen source
untouched. Verified by `test/leaf_audit.py`, green on both dies.

## Why

After the arithmetic, crypto/identity, and fabric layers were audited, the leaf
blocks (host bus / PLL / status / ALU) were the only instantiated logic never
functionally checked. Auditing them lets the program state the silicon is fully
characterized, not just "the big blocks are." Each has a checkable contract (a
fractional-divider rate, the WB read/write protocol, a documented bit layout, and
a {-1,0,+1} ternary algebra).

## Implementation

- `phi_pll_div`: counted phi_tick over 8 clocks (= 5).
- `wishbone_full`: wrote/read a scratch reg, read the RO status mirrors, and
  confirmed a write to a RO reg is dropped.
- `wb_status_reg`: checked the packed byte against the documented layout and the
  alive toggle across two post_done rising edges.
- `alu9_decoder`: tabulated all 9 ops x 9 operand pairs vs a {-1,0,+1} reference
  (81 cases); shipped = 6 mismatches (all op7), `alu9_decoder_v2` = 0. Traced the
  top hookup (opcode/operands = random hwrng_word bits; result -> ring27_memory) to
  grade it benign.
- `src/alu9_decoder_v2.v` (gamma + euler, BIND = ternary multiply);
  `test/leaf_audit.py` (both dies); updated `RESPIN_BRIEF_gf_arithmetic.md`.

## Verification

```
phi_pll_div   : 5 ticks / 8 clocks (expect 5 = 0.625 ~ 1/phi)  -> OK
wishbone_full : reg5(RW)=de reg0(status)=a5 reg2(rcpt,RO-write-ignored)=22  -> OK
wb_status_reg : packed=00110111 (expect 00110111); alive toggles 1->0  -> OK
alu9_decoder  : shipped BIND gap = 6/81 mismatches (all op7); v2 = 0/81  -> CONFIRMED + FIXED
RESULT: phi/wb/status CORRECT; alu9 BIND gap characterized + v2 fix verified
                                                       (identical on Gamma and Euler)
```

## Research (this loop)

In MAP-style Vector Symbolic Architectures over a bipolar/ternary alphabet, the
three core operators are bundle (elementwise add, superposition), bind (elementwise
multiply, association), and permute. Bind must be invertible and must satisfy the
absorbing/identity laws of multiplication -- bind(x, +1) = x and bind(x, 0) = 0 --
which is exactly what makes unbinding (bind again with the same key) recover the
operand. The shipped op7 `sa ^ sb` (XOR of two's-complement signed values)
satisfies none of these for the zero element and self-bind, so it is not a valid
bind; the header's "(XOR)" was the bipolar {-1,+1} shorthand (where bind = multiply
= XOR of the sign/encoding bits) applied to the wrong representation. v2 restores
multiply. As with the rest of this audit, the bug is RTL diverging from the
contract it states, and -- like bitnet and multi_tile_receipt -- a second design
choice (driving the unit with random bits into a liveness ring) makes it benign on
the actual die, which is why grading needs the wiring, not just the truth table.

## Metrics

- Leaf blocks audited: 4 (phi_pll_div, wishbone_full, wb_status_reg, alu9_decoder)
- Active on-silicon defects: still 3 (gf16_mul, bitnet, blake3) -- none added; the
  leaf blocks are correct except alu9_decoder's BIND, which is latent/benign
- alu9_decoder_v2 staged on Gamma + Euler; leaf_audit.py green on both
- Whole instantiated design now audited: arithmetic, crypto/identity, fabric, leaf
- gamma a65bf12, euler 40eb2b3
- Days to deadline: 12

---

## Three Collaboration Options for the Next Loop

### Option A: Wind down -- the instantiated design is fully audited
Every instantiated block across both compute dies has now been checked against its
contract: arithmetic (3 active defects, staged), the receipt/identity/security path
(only blake3 broken), the mesh fabric (correct; 1 latent-benign), and the leaf
blocks (correct; 1 latent-benign). The respin brief is a complete, bounded go/no-go.
This is the clean stopping point -- pause the cron (`CronDelete d3317e31`) and hand
the brief to the program.

### Option B: Backport the staged v2 fixes into the t27 master
The three active defects' fixes (gf16_v2_*, bitnet_encoder_v2, blake3_anchor_v2)
plus the benign-but-real corrections (multi_tile_receipt_v2, alu9_decoder_v2) live
in the die repos. Only gf16 was root-caused into the t27 codegen master so far.
Porting the rest upstream (where it has a clean source + a Closes #N hook) means a
future regen/tapeout starts correct. Mechanical, verifiable, no new analysis.

### Option C: Provide a trained gf16 model + eval set (numerical respin number)
Still the one external lever for sharpening Defect 1's task-level impact beyond the
synthetic proxy (~0.24% argmax flips).
