gHashTag/tt-trinity-corona/docs/REPORT_2026-06-06_loop148.md

# Loop 148 Report -- 2026-06-06

## Summary

**Audited the LAST unverified instantiated layer -- the control/datapath mesh
fabric. The router, mesh, and host FSM are all CORRECT; one LATENT contract bug
found in `multi_tile_receipt` that is BENIGN on the shipped silicon.**
`trinity_router_2x2` does clean one-hot forward addressing (packet dst[27:26] ->
exactly the addressed tile, full broadcast) and fair round-robin on the return
path (tiles served 0->1->2->3->0...). `trinity_mesh_2x2` runs the canonical
sequence end-to-end (LOAD_A/LOAD_B [1,2,3,4], COMPUTE, READ_RES) and returns
0x47C0 (= 30.0 in GF16) -- the host->router->tile->dot4->tile->router->host path
is whole. `trinity_master_fsm` drives exactly that sequence. The one defect:
`multi_tile_receipt` accumulates each tile in its own `agg <= agg ^ tN` -- four
NON-BLOCKING assignments to one register, so when >1 tile is valid in a cycle the
last (t3) wins and the other simultaneous contributions are DROPPED (the XOR-sum
is wrong). It is BENIGN on Gamma/Euler because both tops tie all four tile ports
to ONE replicated source: there are no distinct simultaneous tiles to lose, and
the last-wins bug actually yields the desired single-source XOR accumulate (a
*correct* 4-tile XOR of four identical inputs would give 0). The
`attested_mask`/`all_attested` path is correct regardless (one register per bit).
`multi_tile_receipt_v2` folds all simultaneous contributions for future
distinct-tile reuse (explicitly NOT a drop-in under the current hookup). Also
fixed a stale, non-CI testbench (`tb_integration_mesh.v`) whose wrong local packet
macros made it silently mis-fail. Verified by `test/fabric_audit.py`, green on
both dies.

## Why

After the receipt/identity/nonce primitives were cleared (loop 147), the only
instantiated logic never functionally checked was the fabric that moves packets
and aggregates receipts. A defect audit needs to reach every instantiated block to
be able to say "the silicon is characterized," and the fabric is the last one.

## Implementation

- `trinity_router_2x2`: drove host packets with dst 0..3 (checked t_valid one-hot +
  full broadcast + host_in_ready follows the addressed tile), then asserted all 4
  tile return-valids and confirmed the round-robin pointer rotates fairly.
- `trinity_mesh_2x2`: drove the canonical LOAD/COMPUTE/READ with the REAL
  trinity_packet.vh and read dbg_tile0_result == 0x47C0.
- `multi_tile_receipt`: drove 4 distinct tiles valid in one cycle (-> only t3) vs
  staggered (-> correct XOR-all); then the same on `multi_tile_receipt_v2` (correct
  both ways). Traced the top-level hookup (all 4 ports = mesh_rcpt_*) to grade it
  benign.
- `src/multi_tile_receipt_v2.v` (gamma + euler); `test/fabric_audit.py` (both);
  rewrote `test/tb_integration_mesh.v` to include the canonical header (was using
  local macros with an extra 3'b0 and READ_RES=4'd6 vs the real 4'h5).
- Updated `docs/RESPIN_BRIEF_gf_arithmetic.md` "Checked and cleared".

## Verification

```
trinity_router_2x2 : forward one-hot True; return round-robin fair True (order [0,1,2,3])  -> OK
trinity_mesh_2x2   : dot4([1,2,3,4].[1,2,3,4]) = 0x47c0 (expect 0x47c0 = 30.0)  -> OK
multi_tile_receipt : shipped drops simultaneous tiles (1-cyc=0x88 vs xor-all 0xff;
                     staggered=0xff); v2 correct both ways (0xff/0xff)  -> GAP CONFIRMED + FIXED
RESULT: router+mesh CORRECT; multi_tile_receipt latent-gap characterized + v2 fix verified
                                                              (identical on Gamma and Euler)
tb_integration_mesh.v (rewritten): PASS Canonical dot4(1,2,3,4) = 0x47c0
```

## Research (this loop)

The `multi_tile_receipt` bug is the textbook Verilog non-blocking-assignment
hazard: in one always block, several `x <= ...` to the same `x` do NOT
read-modify-write in sequence -- they all sample the OLD `x` and the
last-scheduled assignment is the one that survives, so the design silently
realizes "x <= old_x ^ t3" instead of "x <= old_x ^ t0 ^ t1 ^ t2 ^ t3." It is the
same archetype as the rest of this audit -- RTL that diverges from the contract it
states ("XOR fan-in of 4 tiles") -- but here a second design decision (tying all
four ports to one source) cancels the divergence on the shipped die, which is why
it needs the both-layers analysis to grade. The lesson reinforces loop 147's: a
contract violation is not automatically a silicon defect; you have to check how
the block is actually wired before grading severity, and an honest audit reports
"latent/benign" as carefully as it reports "active."

## Metrics

- Fabric blocks audited: 4 (router, mesh, FSM, multi_tile_receipt) on Gamma + Euler
- Active on-silicon defects: still 3 (gf16_mul, bitnet, blake3) -- none added; the
  fabric is correct, multi_tile_receipt's bug is latent/benign on the shipped dies
- multi_tile_receipt_v2 staged (future distinct-tile reuse); stale testbench fixed
- gamma a1dd6f2, euler 95d394b
- Days to deadline: 12

---

## Three Collaboration Options for the Next Loop

### Option A: Audit the residual leaf blocks (diminishing returns)
The whole instantiated chain -- arithmetic, crypto/identity primitives, and now the
control/datapath fabric -- has been audited. What remains are smaller leaf blocks
(`wishbone_full` / `wb_status_reg` register map, `phi_pll_div` divider ratio, the
quantizers, `proof_trace_writer`). Each has a checkable contract but the expected
value of finding another ACTIVE defect is now low; this is thoroughness, not
likely yield.

### Option B: Wind down -- audit converged, silicon characterized
Three active defects (found + staged) and the entire instantiated design audited:
arithmetic, the receipt/identity/security path (only blake3 broken), and the
fabric (correct; one latent-benign bug). The respin brief is a complete go/no-go.
This is the natural stopping point -- pause the cron (`CronDelete d3317e31`) and
hand the brief to the program.

### Option C: Provide a trained gf16 model + eval set (numerical respin number)
Still the one external lever for sharpening Defect 1's task-level impact beyond the
synthetic proxy (~0.24% argmax flips).
