gHashTag/tt-trinity-corona/docs/REPORT_2026-06-06_loop146.md

# Loop 146 Report -- 2026-06-06

## Summary

**Pivoted off the (closed) GoldenFloat track to a fresh on-silicon subsystem never
functionally checked -- `blake3_anchor`, the per-die DePIN cryptographic RECEIPT
signer -- and found a THIRD active-silicon defect, the most severe one: its BLAKE3
quarter-round G() omits ALL FOUR XOR diffusion steps. BLAKE3's G does `d = ROTR(d ^ a)`
and `b = ROTR(b ^ c)`; the RTL rotates d/b with NO prior XOR. The XOR is BLAKE3's core
nonlinear diffusion -- without it the 256-bit digest is a near-LINEAR function of the
input, so it is NOT preimage/collision-resistant, contradicting the header's "~2^96"
security claim. The RECEIPT signatures on the fabricated Gamma and Euler dies (where
blake3_anchor is the instantiated `u_hash` signer) are therefore cryptographically
weak / forgeable. Confirmed via `blake3_anchor_verify.py`: the shipped RTL == a no-XOR
model (bug present, no other transcription defect) and != the real BLAKE3-G model; the
corrected `blake3_anchor_v2` (XORs restored) == the real BLAKE3-G model. Staged v2 on
both dies; frozen on-die source untouched. Added as Defect 3 to the respin brief -- a
SECURITY defect, a stronger respin driver than the task-quiet numerical ones.**

## Why

The GoldenFloat library is fully correct/verified/gated; the remaining real weaknesses
are in other instantiated subsystems never functionally checked. blake3_anchor is a
cryptographic primitive with an unambiguous reference (BLAKE3's G), so a deviation is a
clear, verifiable defect -- and a hash on the receipt-signing path is security-relevant.

## Implementation

- Read `blake3_anchor.v`: G() applies ROTR16/12/8/7 to d/b with no `^= a` / `^= c`.
- `test/blake3_anchor_verify.py`: drives the shipped RTL and the corrected v2 over
  several messages; checks shipped == no-XOR model, v2 == real-BLAKE3-G model.
- `src/blake3_anchor_v2.v` (gamma + euler): restored the four XORs. Frozen
  blake3_anchor.v left untouched (source must match the die).
- Updated `docs/RESPIN_BRIEF_gf_arithmetic.md` (Defect 3 + matrix + recommendation).

## Verification

```
shipped blake3_anchor == no-XOR model (bug present, no other defect): True (gamma+euler)
corrected blake3_anchor_v2 == real BLAKE3-G model:                    True (gamma+euler)
shipped != real BLAKE3-G (deviation confirmed):                       True
instantiation: blake3_anchor is the active RECEIPT signer (u_hash) on gamma + euler
staged: blake3_anchor_v2 on gamma (01443ee) + euler (09fd314); frozen source untouched
```

## Research (this loop, web available)

BLAKE3's mixing function G (a refinement of ChaCha/BLAKE2) gets its security from
ARX -- Add, Rotate, Xor -- where the XOR is what makes the round non-linear and gives
avalanche; dropping it leaves Add-Rotate, which over GF(2) is close to affine and
trivially invertible, so preimage resistance collapses regardless of round count. This
is why the defect is qualitative, not a few-ULP/few-percent effect like the numerical
bugs: a hash either diffuses or it does not. It is the same archetype as the rest of
this audit's findings -- RTL that diverged from the algorithm it claims to implement,
caught by checking against the reference -- but in the cryptographic domain the
divergence is total. The lesson stands: every "compatible with X" claim deserves a
test against X.

## Metrics

- Active on-silicon defects now found: 3 (gf16_mul rounding-overflow; bitnet neuron
  aliasing; blake3_anchor missing-XOR -- the security one)
- blake3_anchor: shipped = broken (no XOR), v2 = correct BLAKE3-G; both verified
- Staged fix on Gamma + Euler; frozen source untouched; respin brief updated
- Days to deadline: 16

---

## Three Collaboration Options for the Next Loop

### Option A: Audit the remaining instantiated subsystems (highest value)
The blake3 find shows the non-arithmetic instantiated logic is worth checking. Other
on-die subsystems never functionally verified: `crc32_receipt` (CRC-32 of the receipt
triplet -- verifiable against a CRC reference), `trinity_master_fsm` (control FSM),
`trinity_mesh_2x2`. Audit these against their references the same way -- crc32 in
particular has a clean reference and is on the receipt path next to blake3.

### Option B: Wind down -- three defects found, characterized, fixed (staged)
All three active silicon defects are now found, verified, and have staged v2 fixes;
the respin brief covers them. If no further subsystem audit is wanted, pause the cron
(`CronDelete d3317e31`) and hand the brief (now with a security defect) to the program.

### Option C: Provide a trained gf16 model + eval set (numerical respin number)
Still the one external lever for sharpening Defect 1's task-level impact.
