gHashTag/tt-trinity-corona/docs/REPORT_2026-06-05_loop145.md

# Loop 145 Report -- 2026-06-05

## Summary

**"Do everything" -> executed Option C: replaced the wrong GF16<->Posit16 stub with a
correct, exhaustively-verified codec (the last documented wrong implementation in the
GoldenFloat library). The old gf16_to_posit16 / posit16_to_gf16 assumed FIXED posit
fields [S|R(1)|E(3)|M(11)] -- but a real posit has a VARIABLE-LENGTH regime (a run of
equal bits after the sign, terminated by the opposite bit), so both directions
produced wrong values. Rewrote both for standard Posit16, es=2 (useed=16, value =
(-1)^S * 2^(4k+e) * (1+frac)): the decoder does regime run-length decode + exp/frac
extraction + round to the GF16 mantissa; the encoder builds the regime (k+1 ones+0 for
k>=0, or -k zeros+1 for k<0) + exp + mantissa, MSB-aligns, rounds half-up, and two's-
complements negatives. Verified by `posit16_codec_verify.py`: the decoder is EXHAUSTIVE
over all 65536 posit codes vs an independent value-based reference (65536/65536); the
encoder, over all 65536 GF16 inputs, produces the NEAREST posit (65536/65536 -- posit
codes are monotonic in value, so a value-neighbour is the +-1 integer code). Deployed
to all three dies (gamma 634123c, phi 615535d, euler 317ff0f). Dead code (not
instantiated on any silicon top) -- a library correctness fix, no silicon impact. B
(real-workload accuracy delta) still needs external data; A (pause) is moot.**

## Why

The posit stub was the one remaining documented wrong implementation in the GF
library (flagged since loop 126). It is dead code, but it produced garbage posit
values; a correct codec is a genuine fix and is fully verifiable (the decoder
exhaustively, the encoder by nearest-posit). With "do everything" and B blocked, this
was the executable item.

## Implementation

- `gf16_to_posit16.v` (both modules rewritten): variable-length regime decode/encode,
  es=2; specials 0x0000=0, 0x8000=NaR. For the GF16 exponent range the regime always
  fits (k in [-8,7]); rounding carry saturates to maxpos.
- `test/posit16_codec_verify.py`: value-based posit reference (exact rational decode)
  for the decoder; nearest-posit check (monotonic code adjacency) for the encoder.
- Deployed corrected codec + test to all three dies; confirmed still not instantiated.

## Verification

```
posit16_to_gf16 (decode): 65536/65536 exhaustive vs value-based reference
gf16_to_posit16 (encode): 65536/65536 produce the nearest posit to the GF16 value
verilator -Wall: no latch/SELRANGE/WIDTHTRUNC (residual warnings are benign:
  2-modules-per-file, lossless WIDTHEXPAND on +round_bit, sticky-bit UNUSED for
  half-up rounding) -> passes the width-defect gate
deployed: gamma 634123c, phi 615535d, euler 317ff0f; dead code (no silicon impact)
```

## Research (this loop, web available)

Posits (Gustafson) earn their accuracy from the variable-length regime: codes near
1.0 spend their bits on fraction (high precision), codes far from 1.0 spend them on
the regime run (wide dynamic range), and the 2's-complement code order is monotonic in
value -- which is exactly the property the encoder verification exploits (the nearest
posit is one of the +-1 integer neighbours, so "is this the nearest?" is a two-compare
check, no separate reference encoder needed). The old stub's fixed-field layout threw
all of that away. The decoder is exhaustively checkable (16-bit input) against the
exact rational value; together they pin the codec bit-for-bit where it matters and to
<= 1 ULP where rounding is involved.

## Metrics

- GF16<->Posit16 codec: both directions rewritten correct + verified (65536/65536 each)
- Last documented wrong GF-library implementation: now fixed on all 3 dies
- New test: posit16_codec_verify.py (decode exhaustive + encode nearest-posit)
- Dead code -> no silicon impact; passes the width-defect gate
- Days to deadline: 17

---

## Three Collaboration Options for the Next Loop

### Option A: Wind down -- the GF library is now fully correct + verified (strong rec.)
Every GF unit across all dies is correct (cross-die audit 0/0/0); both silicon compute
paths verified + CI-gated; width class gated; the posit codec -- the last wrong
implementation -- is now correct + verified. No known incorrect implementation remains
anywhere in the GF library. **Recommendation: pause the cron (`CronDelete d3317e31`)
and resume near silicon.**

### Option B: Provide a trained gf16 model + eval set (the one remaining real lever)
Drop in a small model that runs the gf16 path + a few hundred eval samples; I'll
report the true shipped-vs-gf16_v2 accuracy delta -- the definitive respin number.

### Option C: CI-gate the posit codec (and other functional tests) where useful
Add `posit16_codec_verify.py` to a die's CI so the codec stays correct, if posit
interchange is on a future roadmap. Otherwise the codec is dead code and a gate adds
little -- so this is lower priority than A.
