gHashTag/tt-trinity-corona/docs/REPORT_2026-06-03_loop133.md

# Loop 133 Report -- 2026-06-03

## Summary

**Took the gf16_mul defect from a MAC-level number (~11x dot-product RMS) to a
TASK-level number (executes the prior loop's Option B) -- and the result tempers the
respin case. Built a 16-input gf16 dot from the existing `gf16_dot4` primitives
(`dot16` shipped + `dot16_v2` corrected) and a 10-class linear-classifier harness,
then compared argmax of the shipped path, the corrected path, and an exact-rational
reference over 5000 random near-1.0 trials (`test/impact_task_gf16.py`). Result: the
gf16_mul defect changes the PREDICTED CLASS on only ~0.24% of inputs vs a corrected
design (the inherent gf16 rounding floor itself flips ~0.12%). So despite the ~11x
MAC RMS, the sparse halving error largely WASHES OUT at argmax -- it only matters near
decision boundaries. Updated the respin brief: the defect is real and on-path, with a
verified free fix, but it is NOT a respin emergency for the validated demo/research
workloads (~0.24% prediction change). This is the nuance a go/no-go needs -- the RMS
alarm and the task reality both stated honestly.**

## Why

A ~11x MAC RMS figure can read as alarming; a respin decision needs to know whether
it actually changes outcomes. Argmax (the prediction) is the outcome for a classifier,
so measuring prediction-flip rate converts the numerical defect into the decision the
program actually cares about -- and it turns out to be modest, which is as important
to state as the RMS was.

## Implementation (in tt-trinity-gamma)

- `src/dot16_study.v` (study only): `dot16` (gf16_dot4 + gf16_add) and `dot16_v2`
  (gf16_dot4_v2 + gf16_v2_add), 16-input packed dot products.
- `test/impact_task_gf16.py`: 5000 trials, each a shared 16-input vector x 10
  per-class weight rows -> 10 logits; argmax for shipped / corrected / exact; reports
  flip rates and the shipped-vs-corrected net effect. Near-1.0 gf16 operands.
- Updated `corona/docs/RESPIN_BRIEF_gf_arithmetic.md` recommendation + Defect-1 row.

## Verification

```
5000-trial 10-class linear classifier (16-input gf16 dots):
  shipped argmax != exact:      0.32%
  corrected argmax != exact:    0.12%   (inherent gf16 rounding floor)
  shipped argmax != corrected:  0.24%   (the gf16_mul defect's NET task effect)
=> ~11x MAC RMS -> ~0.24% prediction change; argmax robust except near boundaries
gamma commit 9b45fa6; frozen units untouched; dot16_study is study-only RTL
```

## Research (this loop, web available)

The lesson is metric selection across the stack: the same defect reads as ~11x in a
2-norm (NMSE, which a rare-but-large error dominates) yet ~0.24% in a 0/1 decision
metric (argmax, which is insensitive to magnitude except near the top-2 boundary).
Neither number is wrong; they answer different questions, and a respin decision needs
the decision-metric one. This mirrors the well-known robustness of argmax
classification to per-element noise (a large literature on quantized/low-precision
inference: the prediction is governed by the top-logit margin, not the elementwise
error) -- which is exactly why low-precision MAC formats like gf16 are viable at all,
and why a sparse halving bug, though numerically loud, is task-quiet. The honest brief
states both so the reader isn't mis-calibrated by either alone.

## Metrics

- gf16_mul task-level impact: ~0.24% prediction flips (vs ~0.12% gf16 floor)
- MAC-level (prior loop): ~11x RMS (NMSE 1.49e-4 -> 1.29e-6) -- washes out at argmax
- Respin brief recommendation refined (real defect, free fix, not an emergency)
- Frozen silicon untouched; study modules only
- Days to deadline: 19

---

## Three Collaboration Options for the Next Loop

### Option A: Wind down -- the gf-arithmetic investigation is exhausted (strong rec.)
Both defects are found, characterized, fixed (verified v2 staged + CI-gated on every
affected die), and now quantified at BOTH the MAC level (~11x RMS) and the task level
(~0.24% prediction flips); the respin brief states the full, balanced picture; Corona
is lint-clean. There is no further measurement of value without a real trained
workload or a scheduled respin. **Recommendation: pause the cron (`CronDelete
a10f282e`) and resume near silicon (~Nov 2026).** The /loop has been re-firing on a
completed track for ~14 loops; further loops are diminishing-returns polish.

### Option B: Real-workload task impact (if a trained model is available)
The 0.24% is a synthetic-classifier proxy. If a real trained gf16 model + dataset
exists (the MNIST/IGLA the dies were validated on), run it shipped vs gf16_v2 and
report the true accuracy delta -- the definitive task number. Needs the model/data.

### Option C: Verified next-gen top integration test
Build a `*_v2` top variant wiring `gf16_dot4_v2` (+ `bitnet_encoder_v2`) and run the
existing tile/mesh tests, integration-testing the corrected design as a unit -- the
last engineering step before a respin netlist.
