gHashTag/tt-trinity-corona/docs/REPORT_2026-06-03_loop132.md

# Loop 132 Report -- 2026-06-03

## Summary

**Closed the last loose end from the respin brief: the staged gf16_v2 fixes on Phi
and Euler had no CI gate verifying them (only Gamma's `goldenfloat-arith` job did).
Ported `test/gf16_v2_verify.py` to Phi and Euler and added a `gf16-fix-verify` CI job
to each `test.yaml` that runs it on every push. Both verify FAITHFUL locally (gf16_v2
correct; the shipped gf16_mul shows the same defect signature -- mul overflow 0/81 ->
Inf, 753 imprecise pairs -- on those dies too). Now every die that carries the
gf16_mul defect (Gamma, Phi, Euler) has BOTH a staged drop-in fix AND a CI gate that
keeps it verified and keeps the shipped-vs-corrected gap documented until a respin
adopts it. The arithmetic audit arc (loops 119-132) is fully closed: defects found,
characterized, impact-measured, fixed (verified v2 on every affected die), gated, and
consolidated into a respin brief.**

## Why

A staged fix nobody checks rots; the respin brief claims "verified fix staged on
every affected die", so the fixes should actually be re-verified in CI on those
dies, not just in Gamma. This makes the brief's claim self-enforcing and means a
future respin can trust the staged modules without re-deriving the verification.

## Implementation

- Ported `gf16_v2_verify.py` (self-contained: needs only gf16_mul/add + gf16_v2_*,
  all present) to `tt-trinity-phi/test/` and `tt-trinity-euler/test/`; ran each ->
  "gf16_v2 FAITHFUL".
- Added a `gf16-fix-verify` job (install iverilog+python3, run the script) to Phi's
  and Euler's `test.yaml`, mirroring Gamma's gate.
- Verified the YAML parses and the scripts are banned-word clean.

## Verification

```
phi  gf16_v2_verify: gf16_v2 FAITHFUL (old mul overflow 0/81->Inf; new 81/81)
euler gf16_v2_verify: gf16_v2 FAITHFUL
gf16-fix-verify CI job added to phi (887c7ec) + euler (22b8035)
every gf16_mul-affected die: staged fix + CI gate (gamma already had it)
frozen silicon untouched
```

## Research (this loop, web available)

The point is verification durability: an audit's value decays unless its checks are
executed continuously, and a fix that is staged but ungated is indistinguishable from
a fix that has silently regressed. Putting the same gate on every die that shares the
defect (and the fix) mirrors how the defect propagated -- one code-gen fanned the bug
to three dies, so the verification has to be fanned to all three too, or the brief's
"verified everywhere" is aspirational. This is the CI corollary of the
single-source-of-truth discipline that recurs through this project's history.

## Metrics

- gf16_v2 fix now CI-gated on all 3 affected dies (was Gamma-only)
- gf16_v2_verify ported + passing on Phi, Euler ("FAITHFUL")
- Arc 119-132 closed: found -> characterized -> impact-measured -> fixed -> gated -> brief
- Frozen silicon untouched throughout; 0 active defects without a staged+gated fix
- Days to deadline: 19

---

## Three Collaboration Options for the Next Loop

### Option A: Wind down -- the arc is complete and self-sustaining (strong rec.)
Two active silicon defects found, characterized, impact-measured (gf16_mul ~11x MAC
RMS), fixed with verified v2 modules staged AND CI-gated on every affected die, and
consolidated into a respin go/no-go brief; Corona is lint-clean; the gfN ladder is
fixed+gated. Nothing further is measurable or fixable without a scheduled respin or a
full workload run. **Recommendation: pause the cron (`CronDelete a10f282e`) and resume
near silicon (~Nov 2026)** for the Fmax sweep, four-die anchor, and ORConf talk. The
respin brief is ready to hand to the program lead.

### Option B: Task-level impact study (classification flips)
If a sharper pre-decision number is wanted: run a small end-to-end classifier with
shipped vs gf16_v2 gf16 and report "X% of inferences change label" -- one step past
the ~11% MAC RMS figure. Needs a workload harness (heavier).

### Option C: Verified next-gen top (integration test of the fixes)
Build a `*_v2` top variant instantiating `gf16_dot4_v2` (+ `bitnet_encoder_v2`) and
run the existing tile/mesh tests against it, so the corrected design is
integration-tested as a unit -- the last engineering step before a respin netlist.
