gHashTag/tt-trinity-corona/docs/REPORT_2026-06-03_loop131.md

# Loop 131 Report -- 2026-06-03

## Summary

**Consolidated the entire loop-119..130 arithmetic audit into a single respin
decision brief (executes the prior loop's Option A), and closed a staging gap found
while building it: the verified `gf16_v2_mul`/`gf16_v2_add` fixes existed only in
Gamma, but the gf16_mul defect is on ALL THREE compute dies (reached via `gf16_dot4`
on every silicon top), so Phi and Euler carried the defect with no staged fix. Ported
the two verified GF16-format units to Phi and Euler (die-agnostic, lint-clean), so
every affected die now has its drop-in fix staged. The brief
(`docs/RESPIN_BRIEF_gf_arithmetic.md`) is a one-page go/no-go: the two active
on-silicon defects (gf16_mul rounding-overflow ~11x MAC RMS on all 3 dies; bitnet
neuron-base aliasing 16/32 neurons on Gamma+Euler), each with mechanism, scope,
measured impact, per-die exposure matrix, and a verified staged fix -- plus a
"checked-and-cleared" list (gfN spec rungs off-path, converters dead code, Corona
lint-clean) so a reviewer sees what was ruled out. Recommendation: gf16_mul is the
numerical respin driver; the fixes are verified and free to fold into any next
shuttle.**

## Why

After 12 loops of discovery, characterization, fixing, and impact measurement, the
remaining high-value act is to turn it into a single decision artifact a program lead
can act on -- scattered findings across three repos and a dozen reports are not a
decision. Building it surfaced the concrete gap (Phi/Euler unfixed), which was worth
closing so the brief's per-die matrix reads "fix staged" everywhere it says "defect".

## Implementation

- **Exposure matrix (verified by instantiation search):** gf16_mul via `gf16_dot4`
  on Gamma/Phi/Euler tops; bitnet on Gamma+Euler. gf16_v2 fixes were only in Gamma.
- **Port:** copied the verified `gf16_v2_mul.v` + `gf16_v2_add.v` (pure GF16 E6M9,
  die-agnostic) to Phi (commit e8a1da0) and Euler (d2cb84d); both lint-clean.
- **Brief:** `tt-trinity-corona/docs/RESPIN_BRIEF_gf_arithmetic.md` -- recommendation,
  the two defects (mechanism/scope/impact/dies/fix), the per-die exposure+fix matrix,
  the cleared-non-issues list, and an evidence index pointing at every script/doc/
  commit produced this arc.

## Verification

```
exposure: gf16_mul on 3 dies (gf16_dot4 -> every top); bitnet on gamma+euler
gf16_v2_mul/add ported to phi (e8a1da0) + euler (d2cb84d); both verilator clean
respin brief committed (corona 0289594); all evidence cross-linked
frozen silicon sources untouched on every die
```

## Research (this loop, web available)

The deliverable is communication, not computation: a respin go/no-go needs the
defect, its workload-level magnitude, the blast radius (which dies), and the
remediation, in one place -- and equally a list of what was checked and cleared, so
the reader can bound the audit's completeness rather than wonder what else might
lurk. Recording the negatives (gfN off-path, converters dead, Corona clean) is as
much a part of a credible review as the positives. The staging gap is the
shared-codegen lesson once more: a fix lives where you put it, not where the bug is;
the bug fanned to three dies via one generator, so the fix has to be fanned back the
same way before the brief can honestly claim every affected die is covered.

## Metrics

- Respin brief: 1 page, both defects + per-die matrix + cleared list + evidence index
- Staging gap closed: gf16_v2_mul/add now on all 3 affected dies (was Gamma-only)
- Active silicon defects: 2 (both with verified staged fixes on every affected die)
- Arc span: loops 119-131; frozen sources untouched throughout
- Days to deadline: 19

---

## Three Collaboration Options for the Next Loop

### Option A: Wind down -- the audit + decision package are complete
Everything a respin decision needs is now in one brief; both defects have verified
fixes staged on every affected die; Corona is lint-clean; the gfN ladder is fixed and
CI-gated. There is no further measurement or fix possible without scheduling a
respin or running a full workload. **Recommendation: pause the cron and resume near
silicon (~Nov 2026)** for the Fmax sweep, four-die anchor measurement, and ORConf
talk; hand the brief to the program lead for the go/no-go.

### Option B: Task-level impact (classification flips)
If a sharper number is wanted before deciding, run a small end-to-end classifier (the
bitnet path or an MNIST-style net) with shipped vs gf16_v2 gf16 and report "X% of
inferences change label" -- the most decision-legible framing, one step past the
~11% MAC RMS figure. Needs a workload harness.

### Option C: Wire the v2 fixes into a verified next-gen top
For a future tapeout, build a `*_v2` top variant that instantiates `gf16_dot4_v2`
(and `bitnet_encoder_v2`) and run the existing tile/mesh tests against it, so the
corrected design is integration-tested as a unit, not just at the primitive level --
the last step before a respin netlist.
