gHashTag/tt-trinity-corona/docs/REPORT_2026-06-03_loop123.md

# Loop 123 Report -- 2026-06-03

## Summary

**Closed the last gap in the GoldenFloat ladder: GF256 (executes the prior loop's
Option A). Investigation overturned the stated reason for excluding it -- the note
"GF256 bias is an open conjecture, doesn't reconcile with 2^(E-1)-1" was simply
wrong. GF256 is [S(1) | E(97) | M(158)] and its stored BIAS = 79228162514264337593
543950335 = 2^96-1 = 2^(E-1)-1 exactly. The real bug was EXP_MAX, set to 2^97 when
a 97-bit exponent field can only reach 2^97-1 -- so `exp == EXP_MAX` was NEVER true,
Inf/NaN detection was completely dead, and the all-ones exponent decoded as a finite
value. gf256_mul also had the same `mant_product` width truncation as the other
rungs. Regenerating gf256_add/gf256_mul via the existing generators (which derive
EXP_MAX = 2^E-1 and the correct Inf/NaN constants) fixed all of it. GF256 is now in
the probe (9/9), both value sweeps (mul 0.500 / add 0.667 ULP over thousands of
pairs), and the specials check (8/8). The entire ladder gf4..gf256 is verified and
CI-gated.**

## Why

GF256 was the one rung outside the cross-check. The prior loop offered it as
Option A and flagged it as "research, low certainty." The investigation was quick
and decisive: the exclusion rationale was a factual error (bias is correct), and
the actual defects (EXP_MAX off-by-one, mul width) are the same class already
fixed elsewhere -- so the existing generators fix GF256 with no new logic. Safe and
source-only: gf256 is `[Spec]` (a 256-bit float is not a silicon compute path; the
silicon rung is gf16), and it is not referenced by the canonical/top-level test.

## Implementation (in tt-trinity-gamma)

- Diagnosed: `BIAS == 2^96-1` (correct); `EXP_MAX == 2^97` (wrong, must be 2^97-1);
  `mant_product` 2 bits too narrow. Confirmed no silicon/canonical-test dependency.
- Added `gf256 (256, 97, 158)` to `gen_gf_mul_fix.py` and `gen_gf_add_fix.py`;
  regenerated `src/gf256_add.v`, `src/gf256_mul.v` -- the generators derive
  `EXP_MAX = 2^E-1` and `PINF/NINF/NaN` from (W,E,M), fixing the off-by-one, the
  special constants, the mul width, and giving faithful rounding in one pass.
- Added gf256 to `gf_arith_xcheck.py` (and corrected the stale "open conjecture"
  comment), `gf_mul_sweep.py`, `gf_add_sweep.py`, `gf_specials.py`.
- Updated `docs/GF_ARITH_FINDINGS.md` (GF256 fix section; corrected the narrative).

## Verification

```
probe (gf_arith_xcheck): 9/9 probed rungs OK -- gf256 1+1 and 2*1 give bias+1
  (=79228162514264337593543950336)
gf_specials: gf256 8/8 (Inf/NaN/overflow round-trip); all rungs PASS
gf_mul_sweep: gf256 7200 pairs, 0.500 ULP -> PASS (exact-rational ref)
gf_add_sweep: gf256 7360 pairs, 0.667 ULP -> PASS
verilator --lint-only -Wall: gf256_add, gf256_mul clean
full ladder gf4..gf256: probe + exhaustive(gf4,gf8) + sweeps + specials all green
Corona repo: untouched
```

Commit pushed to `git@github.com:gHashTag/tt-trinity-gamma.git` main: `9d24a8e`.

## Research (this loop, web available)

The lesson is to distrust a documented "can't be done" rationale and re-derive it:
the "open conjecture" tag had frozen GF256 out of verification for the whole arc,
yet a one-line bias computation showed the convention held and the actual fault was
a mundane off-by-one in the special-exponent sentinel. This is the classic
all-ones-exponent reservation (IEEE-754): the largest field value must be the
Inf/NaN code, so a sentinel set one past the field maximum is unreachable and
silently disables special handling -- detectable only by a round-trip / specials
test, never by a finite-value probe alone. Sources: IEEE-754 (reserved exponent
encodings); the same exact-rational-reference discipline as prior loops (gf256
exponents ~2^96 mandate exponent-comparison bounds, never materialized powers).

## Metrics

- GoldenFloat ladder coverage: gf4..gf128 -> gf4..gf256 (last rung closed)
- GF256 bugs fixed: EXP_MAX off-by-one (dead Inf/NaN detection) + mul width + add
- Verification suite now spans all 10 rungs (probe 9/9 + gf4 exhaustive)
- Misdocumented exclusion corrected (bias was never a conjecture)
- Source-only; gf256 is [Spec]; Corona untouched
- Days to deadline: 19

---

## Three Collaboration Options for the Next Loop

### Option A: Wind down -- the GoldenFloat arithmetic track is complete
gf4..gf256 add/mul are all fixed and verified (probe + exhaustive + value sweeps +
specials), CI-gated by `goldenfloat-arith`. The only residual is gf16's silicon
caveat (Option B). The five-loop arc took the rung arithmetic from 1/9 correct to
the full ladder. **Recommendation: this is a natural stopping point** -- pause the
cron and resume near silicon (~Nov 2026) for the Fmax sweep, four-die anchor, and
ORConf talk, or pick B/C below if continued work is wanted.

### Option B: Corrected gf16 as a separate next-gen module
Add `gf16_add_grs.v` / `gf16_mul_v2.v` (generated by the same tooling: faithful
rounding + correct overflow), verified by the sweep/specials, as the candidate for
a future tapeout -- without overwriting the fabricated-die source. Closes the last
known accuracy/overflow gap while preserving source<->silicon provenance.

### Option C: Promote the rung units' status and document the verification
The rungs were `[Spec] + RTL`; they now carry exhaustive/statistical evidence
(probe, sweeps, specials, two exhaustive). Update the family manifesto / status
tags from `[Spec]` to a verified tier with a one-paragraph evidence summary per
rung (mirroring how Corona documents its decoders' 5 evidence layers), so the
verification is discoverable from the spec, not just the test directory.
