gHashTag/tt-trinity-corona/docs/REPORT_2026-06-03_loop122.md

# Loop 122 Report -- 2026-06-03

## Summary

**Audited and fixed the GoldenFloat special-value (Inf/NaN/overflow) encodings
(executes the prior loop's Option B). The arithmetic datapaths were correct (loops
119-121) but the Inf/NaN *constants* were wrong on gf12/20/24/32/64/128: the emitted
"Inf" carried a nonzero mantissa field, so by the decode convention (Inf = exp-all-
ones AND mant==0) it actually decoded as NaN and did NOT round-trip -- i.e. overflow
produced a NaN-shaped value. The gf20-128 *add* units also still carried those wrong
constants (I'd only regenerated their mul before), and gf64/gf128 add mis-handled
overflow. Fix: both generators now DERIVE the constants from (W,E,M), and all
[Spec] add units (gf12/20/24/32/64/128) were regenerated with the verified GRS
algorithm. New `test/gf_specials.py` drives Inf/NaN/overflow through every rung and
asserts the result decodes to the right kind (overflow must round-trip as Inf). All
rungs pass; the add value sweep now covers gf20-128 too (<= 0.667 ULP). A second
latent bug surfaced and is documented: gf16_mul flushes very-large products to zero
instead of Inf -- but gf16 is the silicon-[Verified] rung and is left untouched so
its source matches the fabricated die.**

## Why

The datapath was correct but I had preserved the special-value constants verbatim
during the mul fixes precisely because they were out of scope then. Auditing them
(Option B) is the completion: an arithmetic unit whose overflow emits a non-round-
trippable "Inf" is still wrong. This is the right next step over Option A
(re-touching the silicon gf16) which would break source<->silicon provenance.

## Implementation (in tt-trinity-gamma)

- Root cause: derived correct constants and compared to emitted -- gf4/gf8/gf16
  correct; gf12/20/24/32/64/128 wrong (their "Inf" decodes as NaN). Confirmed no
  test pins the wrong constants before changing them.
- `gen_gf_mul_fix.py`, `gen_gf_add_fix.py`: now DERIVE specials from (W,E,M)
  (PINF=EXP_MAX<<M, NINF=sign|PINF, NaN=sign|PINF|1); extended the add generator to
  gf20/24/32/64/128 and regenerated them (fixes constants + overflow + faithful
  rounding). gf16 deliberately excluded (silicon).
- `test/gf_specials.py` (new): 8 Inf/NaN/overflow cases per rung, checks the
  decoded KIND (and Inf sign), with gf16 marked INFORMATIONAL.
- `test/gf_add_sweep.py`: extended to gf20-128; fixed a perf bug where the
  overflow/underflow bounds materialized 2^(2^47) (a multi-million-digit int) for
  gf64/gf128 -- now flog2-based above a safe exponent, exact below.
- `.github/workflows/test.yaml`: `goldenfloat-arith` job runs gf_specials.py too.

## Verification

```
probe (gf_arith_xcheck): 8/8 probed rungs OK; gf4 skipped (bias 0)
gf_specials:   all rungs PASS (gf16 overflow INFORMATIONAL, documented)
gf4_exhaustive:  256/256 add + mul     gf8_exhaustive: 65536/65536; 0.719/0.5 ULP
gf_add_sweep:  gf8..gf128 all PASS, <= 0.667 ULP (now incl gf20-128)
gf_mul_sweep:  gf12..gf128 all 0.500 ULP
verilator --lint-only -Wall: all 16 gfN add/mul units clean; Corona repo untouched
```

Commit pushed to `git@github.com:gHashTag/tt-trinity-gamma.git` main: `f0fea5f`.

## Research (this loop, web available)

Two reinforced lessons. First, a correct datapath is not a correct float unit:
IEEE-754 requires Inf/NaN to be *encoded* and *recognised* consistently, and here
the produced "Inf" failed its own `is_inf` test -- the classic round-trip property
(decode(encode(x)) == x) is the cheap check that catches it. Second, the
exact-rational reference must never materialize the bound: comparing |x| against
2^(2^(E-1)) by constructing that integer is a multi-million-digit operation for
gf64/gf128; comparing exponents via floor-log2 (and only materializing small
bounds) is the scalable form -- a reminder that arbitrary-precision code needs the
same overflow-awareness as fixed-width hardware. Sources: IEEE-754 special-value
semantics; Muller et al., *Handbook of Floating-Point Arithmetic*.

## Metrics

- Special-value encodings fixed: gf12/20/24/32/64/128 (6 rungs); gf4/gf8/gf16 ok
- Add units regenerated (constants+overflow+rounding): gf20/24/32/64/128 (5)
- New verification: gf_specials.py (8 cases x 9 rungs); add sweep extended to 7 rungs
- New finding: gf16_mul latent overflow->zero (documented, silicon rung, not fixed)
- CI gate steps in goldenfloat-arith: 5 -> 6
- Days to deadline: 19

---

## Three Collaboration Options for the Next Loop

### Option A: Resolve the GF256 bias open conjecture (last excluded rung)
GF256 is the only rung outside the cross-check because its stored exponent bias
does not reconcile with `2^(E-1)-1`. Pin the actual convention from the t27 spec /
the GF256 decode RTL, document it, and bring GF256 add/mul under the probe + sweep +
specials suite. Highest research content; closes the last gap in coverage.

### Option B: Provide a corrected gf16 as a separate next-gen module
Rather than overwrite the silicon-`[Verified]` gf16 (provenance), add
`gf16_add_grs.v` / `gf16_mul_v2.v` generated by the same tooling (faithful rounding
+ correct overflow), verified by the sweep/specials, as the candidate for a future
tapeout -- leaving the fabricated-die source intact. Closes the gf16 accuracy gap
without rewriting history.

### Option C: Wind down -- the arithmetic track is complete
gf4..gf128 add/mul are all fixed, verified (probe + exhaustive + sweeps + specials),
and CI-gated. Remaining items (GF256 conjecture, gf16 next-gen) are
research/forward-looking, not defects in the shipped set. Revert to the standing
recommendation: pause the cron and resume near silicon (~Nov 2026) for the Fmax
sweep, four-die anchor, and ORConf talk.
