gHashTag/tt-trinity-corona/docs/REPORT_2026-06-03_loop121.md

# Loop 121 Report -- 2026-06-03

## Summary

**Completed the GoldenFloat arithmetic ladder (executes the prior loop's Option A)
and wired the whole cross-check suite into CI. Fixed the last two broken rungs:
gf12 (both add+mul) and gf4 (both). gf12_mul had the same `mant_product` width bug
as gf20-128; gf12_add's `final_exp` was too narrow so the underflow test flushed
every valid exponent >= 8 to zero (1.0+1.0 -> exp 8 -> 0). gf12_add was rewritten
via a new `gen_gf_add_fix.py` that generalizes the exhaustively-verified gf8_add
(guard/round/sticky, signed exponent) -- the generator is self-validated by
regenerating gf8_add and re-passing its 65536/65536 exhaustive test. gf4 is a
degenerate format (bias 0: finite set {+-0,+-1.25,+-1.5,+-1.75,+-Inf,NaN}); its mul
had been a non-float toy and its is_inf test aliased to zero -- both rewritten as
round-to-nearest into the grid and verified EXHAUSTIVELY (256/256). The exponent
probe now skips bias-0 rungs (its "1.0=exp=bias" collides with the zero code). A new
`goldenfloat-arith` CI job runs the probe + both exhaustive checks + both value
sweeps on every push. Net: the rung arithmetic went from 1/9 correct (start of this
arc) to the full ladder verified. A side finding: gf16_add, the silicon-`[Verified]`
rung, is itself ~512-ULP imprecise on cancellation -- documented, left untouched.**

## Why

The prior loops fixed gf8 then gf20-128 mul; gf4 and gf12 were the last broken
rungs. Closing them turns `gf_arith_xcheck.py` green and lets it become a standing
CI gate -- the goal of the whole arc. Safe to do autonomously: the rungs were
broken (a fix cannot regress them), each fix is exhaustively or statistically
verified, and it is source-only (the submitted Gamma GDS is frozen).

## Implementation (in tt-trinity-gamma)

- `test/gen_gf_add_fix.py` (new): generalizes the verified gf8_add to any (E,M) --
  G=3 guard bits, sticky-capturing alignment, priority renormalize, round
  ties-to-even, SIGNED exponent wide enough to separate underflow from a valid
  large exponent. Self-validated: `--check-gf8` regenerates gf8_add and
  gf8_exhaustive still passes 65536/65536. Used to regenerate `gf12_add`.
- `gen_gf_mul_fix.py`: added gf12; regenerated `gf12_mul`.
- `src/gf4_add.v`, `src/gf4_mul.v` (rewritten): round-to-nearest into the gf4 grid
  (significand 4+mant in quarter units; spacing 0.25; overflow above 1.875).
- `test/gf4_exhaustive.py` (new): all 256 pairs, both ops, vs an exact reference.
- `test/gf_add_sweep.py` (new): gf8/gf12 add vs an exact-rational reference.
- `test/gf_arith_xcheck.py`: skips bias-0 rungs (gf4) with a pointer to the
  exhaustive test; reports 8/8 probed correct.
- `.github/workflows/test.yaml`: new `goldenfloat-arith` job.
- `docs/GF_ARITH_FINDINGS.md`: table now all-fixed; gf16 caveat + follow-ups.

## Verification

```
probe (gf_arith_xcheck): 8/8 probed rungs OK (gf8,gf12,gf16,gf20,gf24,gf32,gf64,gf128)
gf4_exhaustive:   256/256 add + 256/256 mul PASS
gf8_exhaustive:   65536/65536 add + mul; 0.719 / 0.500 ULP
gf_add_sweep:     gf8 0.500 ULP, gf12 0.625 ULP -> PASS
gf_mul_sweep:     gf12/20/24/32/64/128 all 0.500 ULP -> PASS
verilator --lint-only -Wall: gf4_add, gf4_mul, gf12_add, gf12_mul all clean
add-generator self-check: regenerated gf8_add re-passes 65536/65536
banned-word lint: CLEAN; Corona repo: untouched
```

Commit pushed to `git@github.com:gHashTag/tt-trinity-gamma.git` main: `cb98feb`.

## Research (this loop, web available)

Two lessons. First, the degenerate-format trap: GF4's bias of 0 makes the implicit
"1.0 = exp=bias" coincide with the zero code, so 1.0 is unrepresentable and the
generic exponent probe tests nonsense -- the fix was to recognise the degeneracy
and switch to an exhaustive truth-table check (feasible at 4 bits), not to force
the probe. Second, a verified unit is only verified against what it was tested on:
gf16_add passed its FPGA/MNIST validation yet the exact-rational sweep shows it is
not faithfully rounded (truncating alignment, Goldberg / Muller et al. on why GRS
bits are mandatory). The sweep -- an independent oracle -- caught what the original
test campaign did not, which is the whole point of an independent reference. The
generator-self-validation pattern (regenerate a known-good unit, re-run its
exhaustive test) is a cheap, strong guard that the code-gen is faithful before
trusting it on a new rung.

## Metrics

- GoldenFloat rungs correct: 7/9 -> full ladder (gf4..gf128 all verified)
- Rungs fixed this loop: 2 (gf4 add+mul, gf12 add+mul)
- New verification: gen_gf_add_fix.py, gf4_exhaustive.py, gf_add_sweep.py; CI job +1
- Arc total (loops 119-121): 1/9 -> 9/9 rungs, source-only, GDS frozen
- New finding: gf16_add legacy imprecision (documented, not fixed)
- Days to deadline: 19

---

## Three Collaboration Options for the Next Loop

### Option A: Bring gf16_add onto the guard/round/sticky path (close the last imprecision)
gf16_add is the only remaining inaccurate add (the silicon-`[Verified]` rung,
~512 ULP on cancellation). `gen_gf_add_fix.py` already generalizes to (E=6,M=9);
regenerate gf16_add, verify with a gf16 add sweep (add gf16 back to
`gf_add_sweep.py`), and confirm the canonical anchor test still passes. This makes
the entire add family faithfully rounded. Needs a nod that re-touching the
silicon-validated rung is in scope. **Recommended -- it is the one real accuracy
gap left.**

### Option B: Audit + fix the gfN special-value encodings
Several rungs carry NaN/Inf constants that look inconsistent (an "Inf" with a
nonzero mantissa field, which the unit's own `is_inf` test -- `mant==0` -- would
classify as NaN, so a produced Inf would not round-trip). Cross-check every rung's
special encodings against the canonical t27 spec and the decode path, and align
them. Conformance cleanup orthogonal to the (now-correct) datapath.

### Option C: Resolve the GF256 bias open conjecture
GF256 is the one rung excluded from the cross-check because its stored exponent
bias does not reconcile with `2^(E-1)-1`. Pin the actual convention from the t27
spec / decode RTL, document it, and bring GF256 arithmetic under the same probe +
sweep. Highest research content, lowest certainty of a clean result.
