gHashTag/tt-trinity-corona/docs/REPORT_2026-06-03_loop119.md

# Loop 119 Report -- 2026-06-03

## Summary

**Fixed and exhaustively verified the GoldenFloat GF8 arithmetic units in the
sibling Gamma repo (executes the prior loop's Option A pilot). GF8 was the worst
case in the rung-arithmetic audit -- both `gf8_add` and `gf8_mul` broken, results
~4x too small (1.0+1.0 -> 0.5, 2.0*1.0 -> 4.0). `gf8_mul` now uses the full 10-bit
mantissa product (was a `[8:0]` reg that truncated 5b*5b up to 961) with
gf16-style normalize/round; `gf8_add` was rewritten as a proper float add with 3
guard bits + sticky and round-to-nearest-ties-even, because a 4-bit mantissa under
the naive truncating align (gf16's convention) loses up to ~16 ULP on subtractive
cancellation. New `test/gf8_exhaustive.py` drives ALL 65536 (a,b) pairs through
both units (iverilog) and checks each result, in ULPs, against an independent
value-based reference: 65536/65536 pass, max error 0.719 ULP (add) / 0.500 ULP
(mul). `gf_arith_xcheck.py` now reports 2/9 rungs correct (gf16, gf8); 7 remain.
Source-only -- the submitted Gamma GDS is frozen.**

## Why

The prior loops found, characterized, and committed a verification harness for a
systematic bug: 8/9 GoldenFloat `gfN_add`/`gfN_mul` units were broken (only the
`[Verified]` gf16 was correct). The pilot fix (GF8, the only rung where a full
65536-pair exhaustive sweep is feasible) was the proposed next step. It is safe to
do autonomously because: the fix is fully exhaustively verifiable, GF8 was already
broken (a fix cannot regress it), and it is a source change -- the Gamma tapeout
(submitted 2026-05-17) is frozen, so silicon is unaffected.

## Implementation (in tt-trinity-gamma)

- `src/gf8_mul.v`: full-width mantissa product; `prod[9] -> exp+1` else stay;
  mantissa = bits below the leading 1; guard/round/sticky; round-to-nearest
  ties-to-zero (gf16_mul convention). Removed the truncating `[8:0]` reg and the
  wrong exp bump / mantissa slice.
- `src/gf8_add.v`: significands `{1, mant, 3'b000}`; alignment captures a sticky
  bit; leading 1 found by priority and renormalized to a fixed position; 4-bit
  mantissa rounded to nearest, ties-to-even; e0m0 "0.125 hole" and round-to-Inf
  at the top binade handled. Dropped an unused `BIAS` localparam (verilator clean).
- `test/gf8_exhaustive.py`: exhaustive 65536-pair cross-check vs a value-based
  reference (decode -> exact float -> op -> compare in ULPs). Non-circular -- it
  checks the produced value, not the RTL's bit slicing. Exit 0 iff all pass.
- `docs/GF_ARITH_FINDINGS.md`: updated -- GF8 marked FIXED, fix documented, the
  remaining-rung plan now points at GF8 as the template for the small rungs.

## Verification

```
gf8 exhaustive: 65536/65536 pairs PASS (tol 1 ULP)
  add max error 0.719 ULP; mul max error 0.500 ULP   (faithful round-to-nearest)
gf_arith_xcheck.py: gf8 flips BROKEN -> OK; 2/9 correct (gf16, gf8), 7 remain
verilator --lint-only -Wall: gf8_add clean, gf8_mul clean
banned-word lint: CLEAN; py_compile: OK
Corona repo (this repo): untouched -- the work is entirely in the Gamma sibling
```

Commits pushed to `git@github.com:gHashTag/tt-trinity-gamma.git` main:
`18ff173` (harness + findings, prior loop) and `0dc089d` (GF8 fix, this loop).

## Research (this loop, web available)

The episode is a textbook narrow-format rounding lesson: a guard/round/sticky path
is not optional when the stored mantissa is only 4 bits. The wider gf16 unit
"gets away with" a truncating alignment because 9 mantissa bits make the dropped
low bits negligible; at 4 bits the same shortcut produces multi-ULP error on
subtractive cancellation (Goldberg, "What Every Computer Scientist Should Know
About Floating-Point Arithmetic"; Muller et al., *Handbook of Floating-Point
Arithmetic*, on why GRS bits are required for faithful rounding). The verification
mirrors the chip's own philosophy -- an exhaustive sweep against an independent
reference, the same evidence layer Corona uses for its decoders -- and is the
cleanest possible check for an 8-bit format (the entire input space fits).

## Metrics

- GoldenFloat rungs now correct: 1 (gf16) -> 2 (gf16, gf8)
- gf8 exhaustive coverage: 65536/65536 pairs, <= 1 ULP (add 0.719, mul 0.500)
- RTL files fixed: 2 (gf8_add, gf8_mul); new verification: 1 (gf8_exhaustive.py)
- Silicon impact: none (source-only; submitted GDS frozen)
- Days to deadline: 19

---

## Three Collaboration Options for the Next Loop

### Option A: Fix the next rung -- gf12 (both add+mul broken)
Apply the GF8 template (proper GRS rounding) to gf12 ([S1 E4 M7], 12-bit). A full
exhaustive sweep is 2^24 = 16.7M pairs -- still tractable in iverilog within a
loop, or sampled + the exponent probe. gf12 is the other "both broken" rung, so it
is the highest-value next target. Deliverable: fixed gf12_add/gf12_mul + a
`gf12_exhaustive.py` (or sampled) cross-check, pushed to Gamma.

### Option B: Fix the mul-only off-by-one across gf20/24/32/64/128 in one pass
These five share a single consistent mul off-by-one (mul gives half the right
value). One root-cause fix (the same normalize correction as gf8_mul) likely
repairs all five. Verify each with the exponent probe + a sampled value sweep
(exhaustive is infeasible above ~16 bits). Deliverable: five fixed mul units +
`gf_arith_xcheck.py` going 2/9 -> 7/9, pushed to Gamma.

### Option C: Return to Corona maintenance / wind-down (low effort)
The Corona oracle itself remains submission-ready and fully self-guarding; this
loop's work was all in the Gamma sibling. If the arithmetic-fix track is not the
priority, revert to the standing recommendation: pause the cron and resume near
silicon (~Nov 2026) for the Fmax sweep, four-die anchor measurement, and ORConf
talk. (The arithmetic fixes can also simply continue under A/B in parallel.)
