gHashTag/tt-trinity-corona/docs/REPORT_2026-06-03_loop113.md

# Loop 113 Report -- 2026-06-03

## Summary

**Consolidated the 20 hand-added CI verification steps into one auto-discovering runner (executes Loop 112 Option C). `tools/run_verification_gates.py` globs `test/test_*.py`, skips the 3 cocotb tests (run via the `make` flow), and runs the 20 standalone gates as subprocesses, aggregating pass/fail. The `lint` CI job's 20 sequential `python3 test/...` steps are replaced by a single `python3 tools/run_verification_gates.py` step, and a `make verify` target wraps it for local use. New gates are now picked up automatically -- no CI edit per gate (I had hand-added 20). A discovery floor (>=18) guards against a glob/skip bug silently running fewer gates. All 20 gates green in ~6s; failing-gate and floor mutations both caught; 6 CI jobs intact.**

## Why

Every verification gate this arc added required a matching hand-written CI step --
done 20 times, an obvious maintenance smell and an easy thing to forget. A single
auto-discovering runner removes that per-gate ceremony and makes the gate set
self-extending: drop a new `test/test_*.py` with a `main()` and it runs in CI
automatically.

## Implementation

- `tools/run_verification_gates.py`: discover (glob `test/test_*.py`, skip files
  containing `import cocotb`), run each standalone gate as a subprocess, print a
  per-gate PASS/FAIL line + the gate's summary, aggregate the exit code. A
  `MIN_GATES = 18` floor fails if discovery returns too few (silent-under-run guard).
- `.github/workflows/ci.yml`: the 20 `python3 test/...` steps -> one
  `python3 tools/run_verification_gates.py` step (lint job; 6 jobs unchanged).
- `Makefile`: `make verify` target wrapping the runner for local use.

## Verification

```
runner: 20/20 standalone gates discovered + green (~6s); 3 cocotb skipped
mutation A (one gate returns rc=1): runner rc=1, names the failing gate -- DETECTED
mutation B (discovery returns 2 gates < floor 18): runner rc=1 -- FLOOR CAUGHT
make verify: PASS
CI: 6 jobs intact; lint job 20 steps -> 1
py_compile / banned-word: OK / CLEAN
RTL / decoders / generated artifacts: untouched
```

## Research (this loop, web available)

Test discovery -- collecting and running all tests matching a convention rather
than enumerating them -- is the norm in mature frameworks (pytest, unittest
discover) precisely to avoid a hand-maintained registry that drifts from the
actual test files. Applying it to the CI gate list removes the per-gate step and
the "forgot to wire it up" failure mode; the explicit floor preserves the one
safety property a bare glob loses (catching a discovery bug that silently runs
fewer tests). This is the same self-extending, drift-resistant pattern used for
the generated artifacts elsewhere in the repo.

Sources: [pytest test discovery](https://docs.pytest.org/en/stable/explanation/goodpractices.html#test-discovery),
[unittest discovery](https://docs.python.org/3/library/unittest.html#test-discovery).

## Metrics

- CI verification steps: 20 hand-added -> 1 auto-discovering runner
- Per-gate CI ceremony eliminated: new standalone gates auto-run
- Safety: discovery floor (>=18) + per-gate report; both mutations caught
- New files: 1 (`run_verification_gates.py`); + `make verify`; CI steps: 20 -> 1
- Code/RTL/test(gate) changes: 0 (runner + CI/Make wiring only)
- Days to deadline: 19

---

## Three Collaboration Options for the Next Loop

### Option A: Wind down to maintenance cadence (strongly recommended)
The repo is submission-/review-ready and now also low-maintenance: 20 verification
gates run via one self-extending runner, docs/pinout self-checked, decision trail
complete. Recent loops are infrastructure/doc polish with clear diminishing
returns. The remaining real work needs silicon (~Nov 2026): the Fmax sweep, the
four-die anchor measurement (Phase G), the ORConf 2026 talk. **Recommendation:
pause the cron (`CronDelete ac1d89dd`) and resume near silicon arrival.**

### Option B: fmt_id generation, when cocotb is runnable
Generate `fmt_ids.vh` + `fmt_ids.py` from one source and adopt it in the test
files -- only where the cocotb suite can be run to verify the refactor (the Loop
85 guard keeps it correct until then).

### Option C: Have the runner emit a JUnit/summary artifact
Extend `run_verification_gates.py` to also write a small machine-readable summary
(gate -> pass/fail) for CI annotations / a status badge, freshness-consistent with
the existing `verification.json`.
