gHashTag/tt-trinity-corona/docs/REPORT_2026-06-03_loop112.md

# Loop 112 Report -- 2026-06-03

## Summary

**Added a pin-doc consistency CI guard (executes Loop 111 Option B) so the pinout drift fixed last loop cannot recur. `test/test_pinout_consistency.py` asserts that `info.yaml` and `docs/info.md` agree with the RTL: 8/8/8 pin counts, the top module's port directions (ui_in in, uo_out/uio_out/uio_oe out, uio_in in, each [7:0]), that `uio` is driven only during the anchor probe (`uio_oe = is_anchor_cmd ? 0xFF : 0x00`), that the RTL contains NO D2D logic, and -- because D2D is deferred -- that every doc mentioning D2D carries a deferral marker (ADR-0006) and `info.md` documents the as-built uio anchor behaviour. 14 checks pass; two mutations are caught (a doc dropping the deferral marker, and an injected D2D signal in the RTL). Pure stdlib, no PyYAML; wired into CI (now 19 verification gates).**

## Why

Loop 111 found the pinout docs advertising an unimplemented D2D interface on
`uio[7:0]` while the silicon drives the anchor byte there. That was caught by
manual audit. This guard turns the invariants it relied on into an automated
check, so any future edit that re-introduces a phantom-D2D claim, mislabels pin
directions, or changes the uio anchor-only drive without updating the docs fails
CI.

## Implementation

`test/test_pinout_consistency.py` (regex over the RTL + docs; no PyYAML):
- pin counts from `info.yaml` (8 ui + 8 uo + 8 uio);
- five RTL port-direction declarations;
- `uio_oe = is_anchor_cmd ? 0xFF : 0x00` and `uio_out_r = ANCHOR_UIO`;
- no `d2d` identifier in non-comment RTL lines (deferred);
- document-level deferral marker (`deferred` / `adr-0006`) wherever D2D is
  mentioned (info.yaml, info.md) -- robust to the marker being on an adjacent line;
- `info.md` mentions the uio anchor high byte.

## Verification

```
14 checks PASS (pin counts, port directions, uio anchor-only, no-D2D-RTL,
  D2D-deferral markers, info.md anchor note)
mutation A (info.md loses "deferred"/ADR-0006): rc=1 DETECTED
mutation B (RTL gains a d2d_* signal): rc=1 DETECTED
py_compile / banned-word: OK / CLEAN
CI: +1 step (19 verification gates)
RTL / decoders / generated artifacts: untouched
```

## Research (this loop, web available)

The guard encodes a documentation-vs-implementation conformance check: pin
metadata must describe the as-built netlist, and a planned-but-unbuilt interface
must be explicitly marked as such. This is the same "single source of truth +
regenerate/verify" discipline applied to a place where the source (RTL ports +
the absence of D2D) and the doc (info.yaml/info.md) had silently diverged.
Automating it follows the broader practice of treating documentation as testable:
assertions over the docs, run in CI, the same way the design itself is asserted.

Sources: [Docs-as-tests / documentation testing](https://www.writethedocs.org/guide/),
[TinyTapeout info.yaml / pinout spec](https://tinytapeout.com/specifications/).

## Metrics

- Pin-doc invariants now CI-enforced: 14 (counts, directions, uio anchor-only, no-D2D, deferral, anchor note)
- Mutations verified caught: 2 (phantom-D2D doc claim; injected D2D RTL signal)
- New files: 1 (`test_pinout_consistency.py`); CI steps: +1 (19 gates)
- Code/RTL/test(decoder) changes: 0 (new guard only)
- Days to deadline: 19

---

## Three Collaboration Options for the Next Loop

### Option A: Wind down to maintenance cadence (strongly recommended)
The chip and its docs are submission-/review-ready and now self-checking down to
the pinout. Verification (19 CI gates, 5 evidence layers, mutation-tested),
decision trail (9 ADRs), timing harness, and datasheet are all consistent and
self-maintaining. Remaining real work needs silicon (~Nov 2026): the Fmax sweep,
the four-die anchor measurement (Phase G), the ORConf 2026 talk. **Recommendation:
pause the cron (`CronDelete ac1d89dd`) and resume near silicon arrival.**

### Option B: fmt_id generation, when cocotb is runnable
Generate `fmt_ids.vh` + `fmt_ids.py` from one source and adopt it in the test
files -- only where the cocotb suite can be run to verify the refactor (the Loop
85 guard keeps it correct until then).

### Option C: Consolidate the CI test-step list into a single runner
The `lint` job now has 19 sequential `python3 test/...` steps; a single
`make verify` (or a runner that globs `test/test_*.py` non-cocotb gates) would
shorten the workflow and ensure new gates are auto-included.
