gHashTag/tt-trinity-corona/docs/REPORT_2026-06-03_loop108.md

# Loop 108 Report -- 2026-06-03

## Summary

**Added the first genuinely new capability since the verification arc: a post-silicon Fmax timing-characterization scaffold (executes Loop 107 Option C, carrying Loop 77 Option B). `post_silicon/characterize_timing.py` measures the decode critical path on the RP2350 demoboard by sweeping the project clock upward and finding the frequency at which each decoder first produces a wrong result -- the lowest such frequency is the chip Fmax, and the decoder failing there is the critical-path decoder. The pure search logic is fully unit-tested now (`test/test_characterize_timing.py`, in CI); the demoboard clock control is a documented `set_freq_hz()` bring-up hook. This will yield the first GF180MCU timing data for these combinational converters when silicon arrives (~Nov 2026).**

## Why (a forward capability, not more polish)

Recent loops were documentation polish -- diminishing returns. The one direction
with real future value is post-silicon timing (Phase G / Loop 77 Option B):
Corona's RTL is verified functionally, but its silicon Fmax is unknown. Building
the measurement harness now (with its logic verified) means bring-up is
plug-and-play: supply the board's clock-set callback and run.

## Implementation

`post_silicon/characterize_timing.py` (pure stdlib, MicroPython-compatible):
- `characterize(run_vectors_at, freqs_hz)` -- the pure search: sweeps ascending
  frequencies, records per-decoder max passing freq, the chip Fmax (highest freq
  all pass), and the first-failure (freq, decoders) = critical path. No hardware.
- `make_runner(drv, set_freq_hz, vectors_by_fmt)` -- hardware wiring: a
  `set_freq_hz(hz)` callback (demoboard-firmware specific, supplied at bring-up) +
  the quick vectors -> `run_vectors_at(freq)`.
- `report(summary)` -- USB-serial-friendly text naming the critical path.

`test/test_characterize_timing.py` -- unit-tests the search with a mock chip
(per-decoder frequency thresholds): verifies recovered chip Fmax, critical-path
decoder, per-decoder Fmax, and the degenerate all-fail case. Wired into CI.

`post_silicon/POST_SILICON_PLAN.md` -- new "Phase G" section documenting bring-up.

## Verification

```
search logic (mock chip): chip Fmax 40 MHz, critical path = posit8, per-decoder
  Fmax correct, all-fail -> None  (ALL PASS)
mutation (corrupt characterize output): rc=1 DETECTED
py_compile / banned-word: OK / CLEAN
RTL / decoders / generated artifacts: untouched
```

## Research (this loop, web available)

Post-silicon Fmax characterization via shmoo / frequency sweep is the standard
way to find a chip's maximum operating frequency and its speed-limiting path: run
known-good vectors while ramping the clock and locate the first failure. For a
single-clock-domain combinational oracle, the first decoder to fail as frequency
rises *is* the critical path, so the sweep doubles as critical-path
identification -- no on-chip timing instrumentation needed. The design here keeps
the measurement logic separate from (and testable without) the board, then wires
to hardware via a single clock-set callback at bring-up.

Sources: [Shmoo plot (frequency/voltage characterization)](https://en.wikipedia.org/wiki/Shmoo_plot),
[post-silicon validation -- speed binning / Fmax](https://en.wikipedia.org/wiki/Post-silicon_validation).

## Metrics

- New capability: post-silicon Fmax / critical-path characterization (Phase G)
- Pure search logic: unit-tested (chip Fmax, critical path, per-decoder, degenerate)
- Hardware dependency isolated to: one `set_freq_hz()` bring-up hook
- New files: 2 (`characterize_timing.py`, `test_characterize_timing.py`); CI steps: +1
- Mutation guards verified this loop: 1 (rc=1)
- Days to deadline: 19

---

## Three Collaboration Options for the Next Loop

### Option A: Wind down to maintenance cadence (strongly recommended)
The chip is submission-/review-ready and now has its post-silicon timing harness
scaffolded. The remaining real work needs physical silicon (~Nov 2026): run the
Fmax sweep, the four-die anchor measurement (Phase G), and write the ORConf 2026
talk. Continuing 15-minute loops yields only polish. **Recommendation: pause the
cron (`CronDelete ac1d89dd`) and resume near silicon arrival.**

### Option B: Per-decoder latency table (deterministic, runnable now)
Beyond Fmax, record each decoder's end-to-end protocol latency in clock cycles
(CMD -> valid result) -- deterministic and measurable with the existing driver, so
it can be tabulated now as a datasheet artifact (no clock sweep needed).

### Option C: fmt_id generation, when cocotb is runnable
Generate `fmt_ids.vh` + `fmt_ids.py` from one source and adopt it in the test
files -- only where the cocotb suite can be run to verify the refactor (the Loop
85 guard keeps it correct until then).
