gHashTag/tt-trinity-corona/docs/REPORT_2026-06-03_loop107.md

# Loop 107 Report -- 2026-06-03

## Summary

**Made the docs index discoverable from the repo front page (executes Loop 106 Option B). Loop 106 added `docs/README.md` but nothing on the root `README.md` pointed to it, so the navigation entry point was itself hard to find. Added two pointers: the Repository-layout `docs/` line now mentions the index, and a new step 0 in "How to read this repo" links it as the documentation map. Trivial, link-verified, documentation-only. This closes the navigation loop.**

## Implementation

`README.md`:
- Repository layout: `docs/ ... ; see docs/README.md (index)`.
- "How to read this repo": new step 0 -> `[docs/README.md](docs/README.md)` as the
  map of all documentation, before the existing PLAN/specs/ADR steps.

Link target verified to exist; no banned words.

## Verification

```
docs/README.md exists (link valid)
banned-word lint: CLEAN
RTL / tests / generated artifacts: untouched
```

## Research (this loop, web available)

Discoverability is the other half of a documentation index: a landing page only
helps if the front page links to it. Standard README conventions place a short
"documentation" pointer near the top of the project README so a reader reaches the
map in one hop. This is the link-don't-duplicate discipline applied once more --
the root README points to `docs/README.md` rather than restating it.

Sources: [Write the Docs -- README/landing conventions](https://www.writethedocs.org/guide/),
[Diataxis documentation framework](https://diataxis.fr/).

## Metrics

- Root README -> docs index pointers added: 2 (layout line + How-to-read step 0)
- Link verified: 1/1
- Code/RTL/test changes: 0 (documentation-only)
- Days to deadline: 19

---

## Three Collaboration Options for the Next Loop

### Option A: Wind down to maintenance cadence (strongly recommended)
The repo is submission- and review-ready: verification (18 CI gates, 5 evidence
layers, mutation-tested, dossier + JSON), decision trail (9 ADRs), planning docs,
and a discoverable docs index are all consistent and self-maintaining. The last
several loops have been small documentation polish -- a clear signal of
diminishing returns. Meaningful new work awaits silicon (~Nov 2026): timing
characterization, the four-die anchor measurement (Phase G), the ORConf 2026 talk.
**Recommendation: pause the cron (`CronDelete ac1d89dd`) and resume near silicon
arrival.**

### Option B: fmt_id generation, when cocotb is runnable
Generate `fmt_ids.vh` + `fmt_ids.py` from one source and adopt it in the test
files -- only where the cocotb suite can be run to verify the refactor (the Loop
85 guard keeps it correct until then). The one remaining hand-duplicated
identifier set; deferred because it cannot be verified in this environment.

### Option C: Post-silicon timing-characterization scaffold
Add a (currently skipped) timing-measurement stub to `post_silicon/test_corona.py`
that, once silicon is in hand, records clock-to-output latency per decoder. Pure
scaffolding now; real data in Nov 2026. The first genuinely new capability rather
than more polish.
