gHashTag/tt-trinity-corona/docs/REPORT_2026-06-03_loop106.md

# Loop 106 Report -- 2026-06-03

## Summary

**Added a curated documentation index `docs/README.md` (executes Loop 105 Option B). The `docs/` directory holds 105+ chronological loop reports alongside the authoritative artifacts (ADRs, the verification dossier, specs pointers, claim-status), with no single entry point -- a reviewer had to know which files matter. The new index links the authoritative docs in a sensible reading order (overview -> specs -> ADRs -> verification -> status), maps the 8 ADRs in a table, and explicitly demotes the 100+ `REPORT_*.md` to "historical context," directing readers to the specs/ADRs/dossier as the current state. Every link was verified to resolve. Documentation-only; no code/RTL/test changes.**

## The gap

`docs/` had grown to 105 loop reports + 6 authoritative items (ADRs, VERIFICATION
.md/.json, OPEN_QUESTIONS.md, CLAIM_STATUS.md, info.md) with no navigation. A
reviewer opening `docs/` sees mostly reports and cannot tell which file is the
current source of truth. The index fixes that with one screen of links.

## Implementation

`docs/README.md`:
- **Start here** -> root README + PLAN.
- **Specification** -> the five `.t27` SSOT files in read order, noting the ROM is
  generated from them.
- **Decisions** -> a table of ADR-0001..0008 + the OPEN_QUESTIONS Q->ADR map.
- **Verification** -> `VERIFICATION.md` + `verification.json`, noting both are
  generated and freshness-gated.
- **Status & claims** -> `CLAIM_STATUS.md`, `info.md`.
- **Loop reports** -> framed as the historical dev log, not the current state.

All 18 referenced paths were checked to exist; no banned words.

## Verification

```
linked files: ALL EXIST (root docs, 5 specs, 2 generators, 8 ADRs, dossier+json,
  OPEN_QUESTIONS, CLAIM_STATUS, info.md)
banned-word lint: CLEAN
RTL / tests / generated artifacts: untouched
```

## Research (this loop, web available)

A documentation landing page / "diataxis"-style index is a recognised remedy for
a docs tree that has accreted artifacts faster than navigation: readers need a
map that distinguishes reference material (specs, ADRs, evidence) from a
chronological log. The index applies the same link-don't-duplicate discipline used
across this arc -- it points to the authoritative files rather than restating
them, so it stays correct as long as those files exist (every link was verified).

Sources: [Diataxis documentation framework](https://diataxis.fr/),
[README / docs landing-page conventions](https://www.writethedocs.org/guide/).

## Metrics

- docs entry points: 0 -> 1 (`docs/README.md`)
- authoritative artifacts indexed: ADRs (8) + dossier + JSON + specs (5) + status (2)
- loop reports reframed as historical: 105
- links verified to resolve: 18/18
- Code/RTL/test changes: 0 (documentation-only)
- Days to deadline: 19

---

## Three Collaboration Options for the Next Loop

### Option A: Wind down to maintenance cadence (recommended)
Verification (18 CI gates, 5 evidence layers, mutation-tested, dossier + JSON),
the decision trail (9 ADRs), the planning docs, and now a docs index are all
consistent and self-maintaining; the repo is submission- and review-ready.
Remaining meaningful work awaits silicon (~Nov 2026): timing characterization,
the four-die anchor measurement (Phase G), the ORConf 2026 talk. Consider pausing
the cron (`CronDelete ac1d89dd`) or a much slower cadence.

### Option B: Link the docs index from the root README
Add a one-line pointer from the root `README.md` to `docs/README.md` so the index
is discoverable from the repo front page. Trivial, closes the navigation loop.

### Option C: fmt_id generation, when cocotb is runnable
Generate `fmt_ids.vh` + `fmt_ids.py` from one source and adopt it in the test
files -- only where the cocotb suite can be run to verify the refactor (the Loop
85 guard keeps it correct until then).
