gHashTag/tt-trinity-corona/docs/REPORT_2026-06-02_loop100.md

# Loop 100 Report -- 2026-06-02

## Summary

**Milestone consolidation (executes Loop 99 Option A). After ~21 loops building a multi-layer verification suite, this loop assembles a single reviewable evidence dossier -- `docs/VERIFICATION.md` -- mapping each of the 17 decoders to its five evidence layers (exhaustive sweep, independent reference, formal harness, post-silicon vector, mutation kill). Crucially it is GENERATED by `tools/gen_verification_matrix.py` (introspecting the actual test modules) and guarded by a freshness gate (`test/test_verification_matrix_fresh.py`), so the dossier cannot rot -- if a decoder or layer changes, CI fails until it is regenerated. The matrix shows 17/17 decoders with all five layers and 592,308 total input codes exhaustively decoded.**

## The artifact

`docs/VERIFICATION.md` (generated, 3.4 KB) contains:
- the five evidence layers, each with the loops that built it;
- a per-decoder matrix: bits, codes, reference source (the external authority each
  independent ref encodes -- QLoRA, OCP, Posit Standard, IEEE, two's complement,
  BitNet b1.58, ...), and yes/type columns for indep-ref / formal / post-Si / mutation;
- summary counts (all derived, so they can't drift);
- the list of 17 CI gates that enforce the dossier.

It is the reviewable answer to "how do we know the silicon decodes correctly?" --
useful for the shuttle submission and any write-up, and it stays true because it
is regenerated, not hand-edited.

## Implementation

- `tools/gen_verification_matrix.py` -- imports the oracle/mutation/formal/
  post-silicon test modules, unions their `COVERED` sets, classifies each formal
  golden (LUT / computed / definitional), maps post-silicon table labels and
  aliases to decoder names, and emits deterministic markdown (sorted, no
  timestamps). `main()` returns the string; only `__main__` writes the file.
- `test/test_verification_matrix_fresh.py` -- regenerate-and-diff gate: committed
  `docs/VERIFICATION.md` must equal `gen.main()` byte-for-byte; prints the first
  differing line on failure.

## Verification

```
generated docs/VERIFICATION.md: 17/17 decoders, all 5 layers, 592,308 codes
freshness gate: committed == generated (PASS)
mutation (append a line to the generated output): rc=1 DETECTED
py_compile / banned-word: OK / CLEAN (caught+fixed a "proves" in the generator)
RTL / decoders: untouched
```

## Research (this loop, web available)

A verification/traceability matrix is the standard artifact for demonstrating
that every requirement (here, every decoder's correctness) maps to concrete
verification evidence, with no "orphans" (evidence without a requirement) or
"childless parents" (a decoder with no evidence). Safety standards (ISO 26262,
DO-178C) mandate exactly this requirement->evidence traceability. The novelty
here is that the matrix is generated from the test suite and freshness-gated, so
it is always an accurate reflection of the actual checks rather than a document
that drifts -- addressing the well-known failure mode where traceability matrices
become stale paperwork.

Sources: [Requirements/verification traceability matrix](https://www.trace.space/blog/what-is-requirements-traceability),
[Traceability in functional safety (ISO 26262 overview)](https://en.wikipedia.org/wiki/ISO_26262).

## Metrics

- Verification arc consolidated into: 1 generated dossier (`docs/VERIFICATION.md`)
- Decoders x evidence layers documented: 17 x 5 (all present)
- Total input codes exhaustively decoded (reported): 592,308
- New files: 2 (`gen_verification_matrix.py`, `test_verification_matrix_fresh.py`); CI steps: +1
- Mutation guards verified this loop: 1 (stale dossier -> rc=1)
- CI verification gates now: 17
- Days to deadline: 20

---

## Three Collaboration Options for the Next Loop

### Option A: Generate the bring-up vectors from the references (carried)
Emit `*_VECTORS` + `ALIAS_VECTORS` from the independent reference functions so the
oracle is generated, not transcribed -- structurally retiring the oracle-rot
class Loop 92 caught. The Loop 92-94 guards then become freshness checks, matching
the dossier/ROM generation pattern.

### Option B: Emit fmt_ids from one schema (carried from Loop 85 A)
Generate `fmt_ids.vh` + `fmt_ids.py` from the t27 catalog so RTL, tests, and ROM
share one machine-generated fmt_id source (defer the RTL include until post-GDS).

### Option C: Wind down to maintenance cadence
The verification suite (17 CI gates, 5 evidence layers, mutation-tested,
dossier-documented) is comprehensive and self-maintaining. Meaningful new work
now largely awaits silicon (~Nov 2026): timing characterization, the four-die
anchor measurement (Phase G), and the ORConf 2026 talk. Consider a slower loop
cadence until then.
