gHashTag/tt-trinity-corona/docs/REPORT_2026-06-02_loop81.md

# Loop 81 Report -- 2026-06-02

## Summary

**Closes the layout-duplication arc (executes Loop 80's Option A). `gen_rom.py`'s `pack_record()` no longer hardcodes the bit-shifts `<< 72`, `<< 68`, ...; it now DERIVES every field's position/width from the `.t27` SSOT via `tools/ssot_layout.py`. The 80-bit ROM layout now has exactly ONE functional source. Because the packer and the extractor now both read the same parser, the old consistency probe became partly by-construction -- so this loop adds an INDEPENDENT golden-offset oracle (`GOLDEN_LAYOUT`, hand-transcribed from rom_layout.t27 Section 2) whose sole job is to pin the parser. Critically verified: regenerating `format_rom.v` after the refactor is BYTE-IDENTICAL (sha 606877a0...), and a parser-drift mutation is now caught by the golden oracle (rc=1). Layout copies: 3 (Loop 78) -> 2 (Loop 80) -> 1 functional + 1 independent oracle (Loop 81).**

## The change

### `tools/gen_rom.py` -- packer derives from SSOT
- Added `import ssot_layout` (same directory; `sys.path` seeded from `__file__`).
- `pack_record()` now iterates `_FIELD_MAP` (logical arg -> SSOT FIELD_ name) and
  places each value at `ssot_layout.LAYOUT[name]`'s `(lo, width)`. The 256->0
  8-bit overflow warning and `phi_distance()` computation are unchanged.
- **Proof of behaviour preservation:** `python3 tools/gen_rom.py` regenerates
  `src/rtl/format_rom.v` byte-identically (`git status` clean, sha unchanged).
  The RTL ROM is therefore provably unaffected -- this is a pure source refactor.

### `test/test_ssot_layout_crosscheck.py` -- independent oracle
- Added `GOLDEN_LAYOUT`: an 11-entry `(hi, lo, width)` table transcribed by hand
  from `rom_layout.t27`. New check `parse_fields == GOLDEN_LAYOUT` runs first and
  prints per-field drift on mismatch.
- Rationale: with the packer now reading the parser, a parser bug (or an
  unintended edit to the FROZEN spec) would move packer + extractor together and
  could pass the consistency probe. The golden oracle is the independent witness
  that a verification check requires; updating it is the deliberate friction the
  "[Spec] FROZEN at Phase B" clause intends.
- The consistency probe is retained as defence-in-depth (catches a packer that
  ignores the layout / drops a field / lets fields bleed).

## Verification

```
format_rom.v regen:      BYTE-IDENTICAL (sha 606877a0..., git clean)
ssot layout cross-check: ALL PASS (golden-oracle + 11 fields + enums + cardinality)
rom spec cross-check:    23/23 PASS
mutation (parser drift): corrupt CLUSTER_ID lo -> golden oracle FAIL, rc=1 (DETECTED)
py_compile:              gen_rom, ssot_layout, both cross-checks OK
banned-word lint:        CLEAN
RTL / decoders:          untouched (ROM bytes identical)
```

## Research (this loop, web available)

| Source | Finding | Bearing on Corona |
| --- | --- | --- |
| SystemRDL / Accellera | single authored source generates RTL *and* checker so they "can never drift out of sync"; the generated views are derived, not duplicated | This loop applies the principle: the packer is now a derived view of the `.t27`, not a parallel hand-copy |
| Verification methodology (golden-model independence) | a check is only meaningful if its reference is independent of the implementation under test | Motivated `GOLDEN_LAYOUT`: once packer+extractor share a parser, the oracle must sit outside that parser |
| PeakRDL (open-source) | realistic path to emit RTL/packers from a register spec | The asymptote: emit the `format_rom.v` ROM array straight from `ssot_layout`, retiring the CATALOG-in-Python step |

## Metrics

- Functional layout sources: 2 -> 1 (+1 independent test oracle)
- gen_rom literal bit-shifts removed: 11
- ROM output delta: 0 bytes (byte-identical regen)
- Mutation guards verified this loop: 1 (parser drift -> rc=1)
- New files: 0 (refactor + oracle only)
- Days to deadline: 20

---

## Three Collaboration Options for the Next Loop

### Option A: Formal ROM miter (carried; needs sby/yosys in CI)
Finite 80x80-bit ROM. SymbiYosys/EQY proof that `format_rom.v` == packed CATALOG
for all 80 addresses -- closed-form equivalence over the whole address space.
`yosys` is already installed in the GDS/formal CI jobs.

### Option B: Generate the ROM array itself from the SSOT
Today `gen_rom.py` still holds the 80 CATALOG records as a Python literal. Move
the per-format field values into a machine-readable table in `specs/corona/`
(or emit them from the t27 catalog), so `format_rom.v` is generated end-to-end
from spec data -- the final piece of "mechanical SSOT->RTL".

### Option C: Property-based round-trip (needs `hypothesis` in CI)
`hypothesis`-generated random field tuples: pack via `gen_rom`, extract via
`ssot_layout`, assert round-trip identity and no neighbour-field bleed. Hardens
the single parser beyond the fixed probe + golden oracle.
