gHashTag/tt-trinity-corona/docs/REPORT_2026-06-02_loop79.md

# Loop 79 Report -- 2026-06-02

## Summary

**Headline-claim hardening loop. Corona's governing claim is "SSOT -> codegen -> RTL -> silicon is mechanical end-to-end," yet NOTHING verified that the codegen (`tools/gen_rom.py`) actually matches the FROZEN `[Spec]` in the `.t27` SSOT. The 80-bit ROM layout, encoding/flag/status enums, and record cardinality were hand-duplicated in THREE places (`rom_layout.t27`, `gen_rom.py` `pack_record`, `test_rom_spec_crosscheck.py` `extract_fields`) with no cross-check — exactly the drift the `rom_layout.t27` "FROZEN at Phase B" warning anticipates. Added `test/test_ssot_layout_crosscheck.py`: parses the SSOT and asserts gen_rom agrees on all 11 field offsets/widths, the ENCODING enum (10), FLAG bits (4), STATUS enum (8), and cardinality (TOTAL_FORMATS = RECORD_COUNT = len(CATALOG) = 80, CLUSTER_COUNTS sum = 80). 33 checks, ALL PASS locally. Mutation-tested: deliberately misplacing a field makes it FAIL (rc=1) — the guard genuinely catches drift, not a tautology. Wired into CI as a dedicated step.**

## The gap (why this matters)

`specs/corona/rom_layout.t27` is the SSOT and declares itself FROZEN: any layout change "requires a PR update to t27, re-generation of the ROM, and a fresh CI run." But the freeze was only documented, never enforced. The field bit-positions lived independently in:

1. `rom_layout.t27` — `FIELD_*.{hi,lo,width}` (the SSOT)
2. `gen_rom.py` `pack_record()` — literal shifts (`<< 72`, `<< 68`, ...) and masks
3. `test_rom_spec_crosscheck.py` `extract_fields()` — a *third* set of literal shifts

An edit to any one would silently desync the others. The existing `test_rom_spec_crosscheck.py` checks ROM *data* against published numeric specs but never checks the *structure* against the SSOT.

## Implementation

`test/test_ssot_layout_crosscheck.py` (pure Python, no cocotb/sby; runs in <1s):

- **Field layout (functional):** parse `FIELD_*` from `rom_layout.t27`; feed `pack_record()` a probe with distinct per-field values; extract each field at the SSOT-declared `[lo, lo+width)` and assert it equals the probe input. Catches any shift/width drift. `phi_distance_q16` (computed internally) is checked via `gen_rom.phi_distance()`.
- **Width sum == RECORD_BITS == 80.**
- **ENCODING_\* (10)** vs `ENC_*`, **FLAG_\* (4)** vs `FLAG_*` (matched by bit-value, two flags renamed), **STATUS_\* (8)** vs `ST_*` (set == 0..7, anchors VERIFIED=0 / SPEC=7).
- **Cardinality:** TOTAL_FORMATS (oracle) == RECORD_COUNT (layout) == len(CATALOG) == 80; CLUSTER_COUNTS sum == 80.

CI: new step `SSOT<->codegen layout cross-check` after the existing ROM-spec step.

## Research (this loop, web available)

| Source | Finding | Bearing on Corona |
| --- | --- | --- |
| SystemRDL / PeakRDL (`PeakRDL-regblock`, `-uvm`) | one `.rdl` source emits RTL + UVM RAL + IP-XACT; offsets verified by construction | Long-term: make the `.t27` SSOT emit BOTH the ROM and the reference, removing the hand-coded packer (the 2nd/3rd copies) |
| FormalRTL (arXiv:2603.08738), SpecLoop (arXiv:2603.02895) | formal equivalence: generated RTL vs golden spec, counterexample-driven | A finite 80x80-bit ROM is directly tractable for an EQY/SMT miter -> closed-form proof, not sampled checks |
| AssertionForge (arXiv:2503.19174) | spec+RTL knowledge graph -> SVA assertions | Alternative if the packer resists full formalization |

The research confirms the chosen technique (parse-spec, check-generator) is the standard first step, and points at two upgrades (RDL single-source; formal ROM miter) now captured as next-loop options.

## Verification Status

```
SSOT<->codegen cross-check:  33/33 checks PASS (local)
Mutation test:               misplaced field -> rc=1 (guard detects drift) PASS
gen_rom import-safety:        generation gated under __main__, import is side-effect-free
CI:                           new step added; runs python3 test/test_ssot_layout_crosscheck.py
RTL / decoders:               untouched
```

## Metrics

- Standalone structural cross-checks: 0 -> 33
- Layout copies now guarded against drift: 3 (SSOT / packer / extractor)
- CI steps: +1 (SSOT layout cross-check)
- New files: 1 (`test/test_ssot_layout_crosscheck.py`)
- Days to deadline: 20

---

## Three Collaboration Options for the Next Loop

### Option A: Formal ROM miter (spec <-> generated RTL)
The ROM is finite (80 records x 80 bits = 6400 bits). Build a SymbiYosys/EQY miter that proves `format_rom.v` output == `gen_rom.py` packing for all 80 addresses, and that each unpacked field matches the SSOT layout — a closed-form proof replacing today's sampled checks. (Per FormalRTL / SpecLoop research.)

### Option B: Collapse the third layout copy
`test_rom_spec_crosscheck.py` `extract_fields()` still hardcodes shifts. Refactor it to import field offsets from a single helper that reads `rom_layout.t27`, so there is exactly ONE machine-readable layout source. Reduces drift surface from 3 copies to 1 + generated consumers.

### Option C: RDL/SSOT single-source spike
Prototype emitting the ROM packer itself from the `.t27` SSOT (or a SystemRDL transcription), so `pack_record` is generated rather than hand-written — eliminating the hand-coded packer entirely and making the "mechanical end-to-end" claim literally true at the layout level. (Per PeakRDL research.)
