gHashTag/tt-trinity-corona/docs/REPORT_2026-06-02_loop78.md

# Loop 78 Report -- 2026-06-02

## Summary

**Conformance-hardening loop. Web research (OCP OFP8 Rev 1.0, OCP MX v1.0, FP8 arXiv:2209.05433, E4M3FNUZ) confirmed the special-value rules every float decoder must reproduce, then audited the RTL against them. The decoders are CONFORMANT (E8M0 `0xFF`→NaN not 2^128; E4M3FNUZ `0x80`→NaN with no −0; MXFP8 E4M3 has no Inf, two NaN patterns; E5M2 IEEE-style Inf+NaN). The genuine gap was that these rules were tested only IMPLICITLY inside the 256-value exhaustive sweeps. Added an EXPLICIT, citation-backed conformance test: 22 special-value vectors across 6 formats, each cross-checked against the golden reference math (standalone, runs without cocotb) AND driven through the DUT in a new cocotb test. Fixed 3 stale decoder-count claims (README said "18 decoders"; real count is 17). cocotb tests 50 → 51.**

## Research (this loop, web available)

| Source | Rule confirmed | Decoder verdict |
| --- | --- | --- |
| OCP MX v1.0 / arXiv:2310.10537 | E8M0 `0xFF` is the sole NaN sentinel; naive `2^(e-127)` wrongly yields `2^128` | `e8m0_decode.v:17` correct (NaN); `0xFE`→`2^127` finite, `0x00`→`2^-127` subnormal |
| FP8 arXiv:2209.05433 / OCP OFP8 | E4M3 has NO Inf, NaN = `S.1111.111` (two patterns); E5M2 IEEE-style | `mxfp8_e4m3` `0x7F`/`0xFF`→±NaN, `0x7E`→448 max-finite, `0x78`→256 (not Inf) — all correct |
| AMD/Graphcore E4M3FNUZ | bias 8; `0x80` sole NaN; NO negative zero | `fp8_e4m3_fnuz_decode.v:20` correct |
| `jax-ml/ml_dtypes` (golden oracle) | runnable cross-check candidate for a future loop | noted as Option C |

No falsifications. Research validated the existing RTL — the contribution is making conformance *auditable*, not fixing a bug.

## Implementation

### Explicit special-value conformance test (new)

- `test/special_values.py` — 22 cited vectors `(fmt, fmt_id, bytes, expected_fp32, class, note)` covering NaN(7), Inf(4), Zero(5), Subnormal(2), MaxFinite(1), Boundary(1), Normal(2). Standalone-runnable: `python3 test/special_values.py` re-derives every expected FP32 from the golden reference math and fails on any disagreement. **Local run: PASS (22/22 agree with reference).**
- `test/test_decoders.py` — new `test_special_values_conformance` imports the table, re-runs the reference guard, then drives every vector through the DUT and asserts the exact FP32. Tied into existing `MODULE=test_decoders` (no Makefile change needed).

### Documentation count fixes

- `README.md:14` "18 decoders, 50 tests" → "17 decoders, 51 tests"
- `README.md:124` Phase C "18 modules" → "17 modules"
- `README.md:126` "50 cocotb" → "51 cocotb"
- `PLAN.md:7` and `:641` "50 cocotb tests" → "51 cocotb tests"

(Real count: 17 unique decoder `.v` modules; the "19 Verilog modules = top + ROM + 17 decoders" line was already correct.)

## Verification Status

```
Special-value vectors:  22/22 agree with golden reference math (local PASS)
cocotb tests:           50 -> 51 (+test_special_values_conformance)
py_compile:             special_values.py, test_decoders.py OK
Banned-word lint:       CLEAN (no hype words in new/edited files)
RTL:                    untouched (decoders already conformant)
Decoder count claims:   3 stale "18-decoder" references fixed -> 17
```

Note: full cocotb run is CI-only (no `cocotb`/`cocotb-config` in the local env, only `iverilog`). The new DUT test will execute on the next CI run; the reference-math guard ran locally and passed.

## Metrics

- cocotb tests: 50 → 51
- New explicit special-value assertions: 22 (across 6 formats)
- Spec citations added to the suite: 4 (OFP8, MX, FP8, FNUZ)
- Stale count claims fixed: 3
- New files: 1 (`test/special_values.py`)
- Days to deadline: 20

---

## Three Collaboration Options for the Next Loop

### Option A: `ml_dtypes` golden-oracle cross-check
Add a CI step that exhaustively compares each FP8 variant decoder (E4M3FN, E4M3FNUZ, E5M2) against `jax-ml/ml_dtypes` NumPy dtypes — an independent, widely-used reference implementation. Turns "our reference model agrees with our RTL" into "our RTL agrees with the industry-standard library." ~256 values × 3 formats, cheap and decisive.

### Option B: Post-silicon timing characterization (carried from Loop 77)
Extend `post_silicon/test_corona.py` to measure clock-to-output latency per decoder path on the RP2350 demoboard once silicon arrives (~Nov 2026). Would be the first published GF180MCU timing data for combinational format converters. Spec/stub now, run on silicon later.

### Option C: Formal special-value properties
Promote the 22 special-value vectors into SymbiYosys `assert` properties (e.g. "`e8m0_in==0xFF` ⇒ `fp32_out==0x7FC00000`") in the relevant `formal/fv_*.sv` harnesses. Exhaustive sweeps already cover these in sim; formal would prove them unconditionally and document conformance as machine-checked theorems.
