gHashTag/tt-trinity-corona/docs/REPORT_2026-06-02_loop76.md

# Loop 76 Report -- 2026-06-02

## Summary

**Post-submission bugfix + completion loop. Fixed `_float_to_u32` NameError bug in MXINT8 reference model (dead code path, but a defect). Added BF16 full exhaustive sweep (65,536 values) and TF32 boundary+random sweep (~1,280 values) to `run_exhaustive()`. Now 16 decoder sweeps covering 68,708 total values. All reference models validated. Loop 75 CI: ALL 6 PASS. Loop 74 GDS: gds PASS, gl_test + precheck pending. Research: FSiC 2026 deadline passed (April 1), ORConf 2026 (Sep 11-13, Ghent) is the next viable venue.**

## Implementation

### Bug Fix: `_float_to_u32` NameError

The `_ref_mxint8` function had an `except ImportError` fallback referencing `_float_to_u32()` which was never defined. Although dead code (MicroPython has `struct`), this was a latent defect. Fixed by removing the try/except wrapper entirely.

### BF16 Full Exhaustive Sweep

Added `_sweep_bf16()`: iterates all 65,536 two-byte inputs, verifies each against `_ref_bf16(val) = val << 16`. On RP2350, estimated ~65 seconds.

### TF32 Boundary + Random Sweep

Added `_sweep_tf32()`: tests boundary values (zero crossings, sign flip, Inf/NaN edges) plus 1,024 random samples from the 19-bit space. Total ~1,280 unique values. Full 524,288-value sweep would take ~9 minutes — the boundary+random approach catches any systematic decode error.

### Reference Model Summary

| Model | New? | Validated |
|---|---|---|
| `_ref_bf16` | New | 65,536/65,536 match |
| `_ref_tf32` | New | 10,000/10,000 random match |
| `_ref_mxint8` | Fixed | 256/256 match (bug removed) |
| All others | Unchanged | 1,892/1,892 match |

## Scientific Research

- **FSiC 2026** (Jul 6-8, Ljubljana): Abstract deadline passed April 1. Lightning talk may still be possible via email to fsic2026@f-si.org.
- **ORConf 2026** (Sep 11-13, Ghent): Next open-source silicon conference. CFP not yet open but early submissions to orconf@fossi-foundation.org are welcomed. Corona would be a strong fit.
- **ARITH 2026** (Jun 28, Fulda): Paper submissions closed January 30. Program finalized.
- **No new format papers** in the last 3 days.

## Verification Status

```
CI (Loop 75):           ALL 6 PASS (checkout@v6, zero warnings)
GDS (Loop 74):          gds PASS, gl_test + precheck pending (24th expected)
Post-silicon quick:     23 tests, 22/22 mux entries, 98 vectors
Post-silicon exhaustive: 16 sweeps, 68,708 values, 16 reference models
Bug fixed:              _float_to_u32 NameError in _ref_mxint8 (dead code)
Submission:             COMPLETE (TTGF26a, tag v1.0.0-ttgf26a)
```

## Metrics

- Exhaustive sweep values: 1,892 → 68,708 (+66,816)
- Exhaustive sweeps: 14 → 16 (+BF16 full, TF32 sample)
- Bugs fixed: 1 (_float_to_u32 NameError)
- Consecutive precheck passes: 23 (24th pending)
- Days to deadline: 20

---

## Three Collaboration Options

### Option A: ORConf 2026 Talk Proposal

Draft a talk proposal for ORConf 2026 (Sep 11-13, Ghent): "Corona: 80 Numeric Formats on a Single Die — Open-Source Silicon Format Conformance." Email orconf@fossi-foundation.org. By September, actual silicon results from the RP2350 demoboard will be available.

### Option B: Demoboard Auto-Boot Script

Create `boot.py` for the RP2350 demoboard that auto-runs `run_all()` on power-up. Displays results on USB serial with LED pass/fail indicator. Makes silicon validation truly plug-and-play when chips arrive in November.

### Option C: Post-Silicon Timing Characterization

Add timing measurement to the test suite — measure actual clock-to-output latency for each decoder on silicon. Compare against RTL simulation (1 cycle expected). This would characterize the real GF180MCU timing margins.
