gHashTag/tt-trinity-corona/docs/REPORT_2026-06-02_loop67.md

# Loop 67 Report -- 2026-06-02

## Summary

**Pure verification + research loop: 5 new audit areas — 0 HIGH, 0 MEDIUM, 0 LOW, 5 PASS. Clean sweep. No code changes. Loop 65 GDS = 16th consecutive precheck PASS. Loop 66 GDS = 17th consecutive precheck PASS. Byte ordering verified uniform across all output paths. Cocotb golden values independently derived. No CI warning suppression. Single clock domain confirmed. Anchor collision mathematically impossible. 65+ audit areas across 14 loops, all clear.**

## Weakness Audit: 5 New Areas

### PASS (5, all clean)

| Area | Finding |
|---|---|
| Decoder output byte ordering | STATUS mux uses consistent LSB-first ordering across ROM mode (10 bytes), decode mode (4 bytes), and not-implemented mode (4 bytes). All 18 decoders produce 32-bit results consumed by the same `status_cnt[1:0]` byte selector. |
| Cocotb golden value independence | Decoder tests compute expected values via Python IEEE 754 math (`ref_fp4`, `ref_posit8`, etc.) — independent of RTL. ROM readback uses `gen_rom.CATALOG` (spec data, not RTL output). Circularity broken by `test_rom_spec_crosscheck.py` (23 formats vs published specs). |
| CI warning suppression | No `grep -v`, `|| true`, or `2>/dev/null` on any synthesis, lint, or test step. Only benign `yosys-config --datdir` fallback uses `2>/dev/null`. Verilator runs with `-Wall`. All warnings visible in logs. |
| Single clock domain | Only `posedge clk` in entire RTL. All decoders are purely combinational (`always @(*)`). Format ROM is synchronous on `clk`. No generated clocks, clock gating, or divided clocks. No CDC analysis needed. |
| Anchor value collision | Anchor `16'h47C0` outputs on `{uio_out, uo_out}` only when `fmt_id=0x7F`. During decode, `uio_out=0x00` always (uio_oe=0). No decoder can produce `uo_out=0xC0` combined with `uio_out=0x47` — the 16-bit combination is architecturally exclusive to anchor mode. |

## Scientific Research

### New Numeric Formats Discovered

- **HiFloat8 (HiF8)** (Huawei, Feb 2026, arXiv:2602.12635): Tapered-precision 8-bit format that dynamically trades mantissa/exponent bits by magnitude. 0.3-0.5% accuracy advantage over static FP8. Hardware-deployed on Ascend NPUs. Novel decoder challenge — distinct from fixed-field formats in Corona's catalog.
- **HiFloat4 (HiF4)** (Huawei, Apr 2026, arXiv:2604.08826): Three-level hierarchical scaling (E6M2 block / E1 sub-block / E1 micro-block) with S1P2 element values. Pre-training results on Ascend. Architecturally distinct from MXFP4.
- **NVFP4** (NVIDIA): 16-element blocks (not 32) with E4M3 scaling factor (not E8M0 power-of-two). Distinct from MXFP4.
- **Action**: These are post-submission catalog additions (formats #81+). Current 80-format ROM is fixed for TTGF26a.

### TT/GF180MCU Ecosystem Updates

- **TTGF26a deadline confirmed**: June 22, no changes. tt-gds-action updated May 31.
- **wafer.space GF180MCU Run 2** (announced May 7, 2026): New half-width/half-height slots. New precheck includes zero-area polygon check.
- **LibreLane 3.0.3**: Current recommended tag. Extensible design formats, improved step substitution.
- **FSiC 2026** (July 6-8, Ljubljana): Leo Moser presenting "Challenges of the first wafer.space shuttle run" — post-mortem from TTGF0p2/Run 1.

### Open-Source Formal Verification

- **StarVLSI** (May 2026): Cookbook article for SymbiYosys + Z3/Boolector RTL equivalence checking flow. Directly applicable to Corona's decoder verification.
- **MCP4EDA** (2025-2026): LLM-integrated EDA flow via Model Context Protocol. 15-30% timing closure improvement. OpenROAD MCP server proposed (FSiC 2026 lightning talk).

### Standards & ISA

- **IEEE P3109**: Still pre-sponsor-ballot. No urgency to update Corona P3109 cross-references.
- **RISC-V**: Zfh/Zvfh ratified, Zvfbfmin (BF16 conversions) ratified. No new sub-8-bit extensions beyond MXDOTP.
- **ARM**: FP8 E5M2/E4M3 in SVE2/SME2/Neon since 2023. No 2026 format extensions.

### Chiplet Integration

- **IHP open-source chiplet assembly design kit**: First open-source chiplet assembly kit, presenting at FSiC 2026. Future-looking — not applicable to TTGF26a.

## GDS Status

```
Precheck passes: 17 CONSECUTIVE
GDS #26789957231:  PASS (Loop 66 commit cd1bc5f)
  gds: PASS, gl_test: PASS, precheck: PASS
GDS #26789579845:  PASS (Loop 65 commit 433681c)
  gds: PASS, gl_test: PASS, precheck: PASS
Previous: 15 consecutive passes
```

## Verification Status

```
Verilator lint:        PASS (0 warnings)
Yosys synthesis:       PASS (2,308 cells, ~1% of 4x4 site budget)
Formal (sby):          19 configs, 58 tasks (bmc+prove+cover), P1-P14
Cocotb:                50 tests (5 anchor + 29 decoders + 16 stress)
  - 22/22 decoder mux cases covered (21 exhaustive, 1 statistical+formal)
GL tests:              PASS (50/50)
GLS smoke:             PASS (76 golden vectors)
ROM spec cross-check:  PASS (23/23 formats, CI gate)
GitHub CI:             PASS (all 6 jobs green)
GDS + Precheck:        PASS (17 consecutive)
Submission status:     READY
```

## Audit Coverage Summary (Loops 54-67)

**65+ audit areas across 14 loops. 0 CRITICAL, 0 HIGH, 0 MEDIUM remaining. All issues resolved.**

Key milestones:
- Loop 54: MARGIN_MULT critical fix
- Loop 57: TF32+BCD exhaustive tests
- Loop 59: Circular golden dependency broken
- Loop 60: ena=0 multi-state, ROM cross-check CI
- Loop 61: Utilization corrected (14%->1%)
- Loop 62: P14 formal assertion, 50th test
- Loop 63: SPDX headers (38 files)
- Loop 64: Full decoder coverage confirmed
- Loop 65: Config/pinout/GDS verification
- Loop 66: ROM integrity, P3109/MX research
- Loop 67: Byte ordering, golden independence, anchor collision — all PASS

## Metrics

- New audit areas investigated: 5
- Issues found: 0 (complete clean sweep)
- Code changes: 0 (pure verification + research loop)
- Days to deadline: 20
- Consecutive precheck passes: 17

---

## Three Collaboration Options for Next Loop

### Option A: Final Submission -- Tag + Freeze + Submit (Strongly Recommended)

65+ audit areas across 14 loops. 0 remaining issues. 17 consecutive precheck passes. 50 cocotb tests, 58 formal tasks, 76 GLS vectors, 23 spec cross-checks. All CI green. Novelty confirmed — first open-source silicon format oracle. No audit area has produced a HIGH or CRITICAL finding in 10 consecutive loops. Create `v1.0.0-ttgf26a` git tag, fill discord in info.yaml if desired, submit.

### Option B: P3109 Cross-Reference + Formal Equivalence + Freeze

Add P3109 binary8 format annotations to .t27 specs. Add `yosys equiv_check` to CI. Both close minor methodology gaps. Then tag and freeze. ~2 hours total.

### Option C: Post-Silicon Test Framework

Write MicroPython test scripts for RP2350 demoboard bring-up: anchor probe, ROM readback sweep, key decoder checks. Prepare for chip arrival (~Oct 2026). Forward-looking, does not affect submission.
