gHashTag/tt-trinity-corona/docs/REPORT_2026-06-02_loop65.md

# Loop 65 Report -- 2026-06-02

## Summary

**Pure verification loop: 5 new audit areas investigated — 0 HIGH, 0 MEDIUM, 2 LOW, 3 PASS. Loop 64 GDS confirmed as 15th consecutive precheck PASS. Node.js 20→24 forced migration (June 16) affects CI actions but is warning-only, non-breaking. No code changes needed. 55+ audit areas across 12 loops, all clear. Project remains submission-ready.**

## Weakness Audit: 5 New Areas

### LOW (2)

| # | Finding | Status |
|---|---|---|
| L1 | Root Makefile `gls` and `rom-golden` targets hardcode `/tmp/corona_synth.v` paths. Parallel `make -j` would corrupt intermediate files. CI does not use these targets (uses dedicated workflow). | **ACCEPTED** — dev convenience only, not submission-blocking |
| L2 | GitHub Actions Node.js 20 deprecation: `actions/checkout@v4`, `actions/upload-artifact@v4` will be forced to Node.js 24 on June 16 (6 days before deadline). Warning only — actions continue to function, just run on newer runtime. | **ACCEPTED** — non-breaking, TT actions maintained upstream |

### PASS (3)

| Area | Finding |
|---|---|
| Config JSON structure | `config.json` (user settings) + `user_config.json` (auto-generated by `tt_tool.py`) is the standard TT workflow. Overlapping keys (DIE_AREA, RT_MAX_LAYER) are consistent. No desynchronization risk — user_config.json is regenerated on each build. |
| Pinout format (bracket notation) | info.yaml uses `ui[0]`, `uo[0]`, `uio[0]` bracket notation. 15 consecutive precheck passes confirm format is valid. All 24 pins present. |
| GDS Loop 64 precheck | **15th consecutive precheck PASS.** gds: PASS, gl_test: PASS (50/50), precheck: PASS. Viewer: cosmetic fail (GitHub Pages not enabled — known, non-blocking). |

## GDS Status

```
Precheck passes: 15 CONSECUTIVE
GDS #26788914640:  PASS (Loop 64 commit 26944a9)
  gds: PASS, gl_test: PASS, precheck: PASS
GDS #26788595871:  PASS (Loop 63 commit 314d8e2)
  gds: PASS, gl_test: PASS, precheck: PASS
Previous: 13 consecutive passes (Loops 54-62)
```

## Scientific Research

### Conference Programs (Now Published)

- **ISCA 2026** (June 27 - July 1, Raleigh NC): Full program published. Key papers:
  - **"MXFFP: Microscaling Flexible Floating Point Format for Large-Scale AI Model Acceleration"** (Session 10B) — new flexible FP format for AI. May define encodings that differ from existing MXFP/OCP specs in the Corona catalog.
  - **"P3-LLM: NPU-PIM Accelerator for Edge LLM Inference Using Hybrid Numerical Formats"** (Session 4A) — addresses format heterogeneity in hardware.
  - **"UniCore: Bit-Width Scalable GEMM Unit"**, **"XtraMAC: Mixed-Precision LLM on FPGA"** (Session 10B).
- **ARITH 2026** (June 28 - July 1, Fulda): Program published. Key papers:
  - **"Novel Aspects of IEEE SA P3109 Arithmetic Formats for ML"** (Fitzgibbon, Wintersteiger, Sarnoff) — P3109 working group members describe the parametric framework for sub-16-bit ML formats. Many Corona formats fall under P3109. FLoPS formalization in Lean published (arXiv:2602.15965).
  - **"TensorGauge: Pre-silicon End-to-end Framework"** (Session 7) — pre-silicon validation methodology for tensor compute, applicable to Corona's approach.

### Shuttle & PDK Updates

- **TTGF26a deadline confirmed**: June 22, 2026. No extensions found. Active maintenance (commits May 31).
- **Metal 5 reserved** by TT power grid — Corona uses Metal4 max (RT_MAX_LAYER), correct.
- **No SRAM macros** on TT GF180MCU shuttles — ROM synthesized from standard cells (DFFs/combinational). Corona's approach is correct by design.
- **GF180MCU tapeout experience** (Essenceia, 2025): Flip-flop-only storage, I/O bandwidth constraint (8+8+8 pins), OpenROAD/LibreLane flow works well with <24h turnaround.

### Novelty Confirmation

No prior art found for ROM-based numeric format conformance oracles on silicon. Corona appears to be a genuinely novel contribution — the concept of encoding a format catalog as a silicon ROM with decode modules has no direct precedent in the literature.

## Verification Status

```
Verilator lint:        PASS (0 warnings)
Yosys synthesis:       PASS (2,308 cells, ~1% of 4x4 site budget)
Formal (sby):          19 configs, 58 tasks (bmc+prove+cover), P1-P14
Cocotb:                50 tests (5 anchor + 29 decoders + 16 stress)
  - 22/22 decoder mux cases covered (21 exhaustive, 1 statistical+formal)
GL tests:              PASS (50/50)
GLS smoke:             PASS (76 golden vectors)
ROM spec cross-check:  PASS (23/23 formats, CI gate)
GitHub CI:             PASS (all 6 jobs green)
GDS + Precheck:        PASS (15 consecutive)
Submission status:     READY
```

## Audit Coverage Summary (Loops 54-65)

**55+ audit areas across 12 loops. 0 CRITICAL, 0 HIGH, 0 MEDIUM remaining. All issues resolved.**

Key milestones across loops:
- Loop 54: MARGIN_MULT critical fix
- Loop 57: TF32+BCD exhaustive tests
- Loop 59: Circular golden dependency broken (spec cross-check)
- Loop 60: ena=0 multi-state test, ROM cross-check in CI
- Loop 61: Utilization corrected (14%->1%)
- Loop 62: P14 formal assertion, 50th test milestone
- Loop 63: SPDX headers (38 files), info.md accuracy
- Loop 64: Full decoder test coverage confirmed, stale docs fixed
- Loop 65: Config/pinout/GDS verification pass, 15th precheck confirmed

## Metrics

- New audit areas investigated: 5
- Issues found: 0 HIGH, 0 MEDIUM, 2 LOW (both accepted), 3 PASS
- Code changes: 0 (pure verification loop)
- Days to deadline: 20
- Consecutive precheck passes: 15

---

## Three Collaboration Options for Next Loop

### Option A: Final Submission -- Tag Release + Submit (Recommended)

55+ audit areas across 12 loops. 0 remaining issues. 15 consecutive precheck passes. 50 cocotb tests (22/22 decoder mux cases), 58 formal tasks, 76 GLS vectors, 23 spec cross-checks. All CI green. Create `v1.0.0-ttgf26a` git tag, fill discord in info.yaml if desired, and submit to TTGF26a. The project is submission-ready -- further auditing has diminishing returns.

### Option B: Formal Equivalence + requirements.txt + Freeze

Add `yosys equiv_check` CI step (closes last methodology gap), add `requirements.txt` pinning cocotb==2.0.1 (closes dev reproducibility gap), then tag and freeze. ~30 minutes total. Addresses the two remaining LOW-priority items.

### Option C: Post-Silicon Test Plan + Conference Prep

Write `docs/POST_SILICON_PLAN.md` for RP2350 demoboard HIL testing. Port anchor probe + key decoder tests to MicroPython/microcotb. Prepare ARITH 2026 format coverage table (80-format ROM vs published specs). Forward-looking work that doesn't affect submission but prepares for silicon arrival (Oct-Nov 2026).
