gHashTag/tt-trinity-corona/docs/REPORT_2026-06-02_loop63.md

# Loop 63 Report -- 2026-06-02

## Summary

**SPDX license headers added to all 38 formal files. docs/info.md accuracy fixes: byte_count clamping documented, MXFP8 E4M3 added to decoder enumeration (18 names now match "18 decoders" claim). Audit: 7 new areas — 0 HIGH, 1 MEDIUM (SPDX headers, resolved), 6 LOW/PASS. GDS: 13th consecutive precheck PASS. All 17 decoders confirmed to have independent formal verification with golden references. 50 cocotb tests, 58 formal tasks, CI all green.**

## Weakness Audit: 7 New Areas

### MEDIUM (1, RESOLVED)

| # | Finding | Status |
|---|---|---|
| M1 | 38 files in `formal/` (19 `.sv` + 19 `.sby`) missing SPDX license headers. All RTL and test files had proper headers. | **RESOLVED** — `// SPDX-License-Identifier: Apache-2.0` added to all `.sv`, `# SPDX-License-Identifier: Apache-2.0` added to all `.sby` |

### LOW (1)

| # | Finding | Status |
|---|---|---|
| L1 | docs/info.md listed 17 decoder names but claimed "18 Tier-1 RTL decode modules". MXFP8 E4M3 was missing from enumeration (same physical module as FP8 E4M3 but serves a separate format alias). | **RESOLVED** — added MXFP8 E4M3 to list, 18 names now match claim |

### PASS (5, all clean)

| Area | Finding |
|---|---|
| Individual decoder formal verification | All 17 decoders have dedicated `.sby` + `.sv` formal wrappers with independent golden references. Covers subnormals, NaN, Inf, zero, boundary values, sign preservation. 19 formal configs total (17 decoders + FSM + ROM). |
| Cocotb Makefile MODULE list | All 3 test modules correctly listed. `test_rom_spec_crosscheck.py` correctly omitted (standalone script, not cocotb). |
| Pin naming consistency | RTL ports match TT standard interface. info.yaml pin descriptions accurate. |
| Synthesis timing closure | 20ns logic budget at 180nm GF180MCU. Worst-case combinational depth ~8-12ns (22:1 mux). ~2x margin confirmed by 13 consecutive precheck passes. |
| Cocotb test isolation | All 50 tests call `reset_dut()` at start. Stress tests intentionally omit inter-transaction resets to verify FSM DONE→IDLE transition. Clock handling safe (cocotb handles duplicate starts). |

## Implementation

### 1. SPDX License Headers (38 formal files)

Added Apache-2.0 SPDX headers to all formal verification files:
- 19 `.sv` files: `// SPDX-License-Identifier: Apache-2.0` as first line
- 19 `.sby` files: `# SPDX-License-Identifier: Apache-2.0` as first line (SBY format allows `#` comments)

### 2. docs/info.md Accuracy Fixes

Two fixes:
- **Byte count**: Changed "0-15 data bytes to follow" to "0 = ROM readback, 1-4 = data bytes; values >4 clamped to 4" (matches RTL line 106)
- **Decoder enumeration**: Added "MXFP8 E4M3" to list — 18 names now match the "18 Tier-1 RTL decode modules" heading

## GDS Status

```
Precheck passes: 13 CONSECUTIVE
GDS #26787715532:  PASS (Loop 62 commit 90fb126)
  gds: PASS, gl_test: PASS, precheck: PASS (viewer cosmetic fail)
Previous: 12 consecutive passes
All with: BOTTOM_MARGIN_MULT=1, TOP_MARGIN_MULT=1
```

## Verification Status

```
Verilator lint:        PASS (0 warnings)
Yosys synthesis:       PASS (2,308 cells, ~1% of 4x4 site budget)
Formal (sby):          19 configs, 58 tasks (bmc+prove+cover), P14 added Loop 62
Cocotb:                50 tests (5 anchor + 29 decoders + 16 stress)
GL tests:              PASS (50/50)
GLS smoke:             PASS (76 golden vectors)
ROM spec cross-check:  PASS (23/23 formats, CI gate)
GitHub CI:             PASS (all 6 jobs green)
GDS + Precheck:        PASS (13 consecutive)
Submission status:     READY
```

## Audit Coverage (Loops 54-63)

| Loop | Areas | Key Findings |
|---|---|---|
| 54 | Precheck root cause | MARGIN_MULT fix (CRITICAL, fixed) |
| 55 | Shift register, mux, docs | byte_count test, LibreLane rebrand |
| 56 | Multi-byte alignment, ROM golden, timing, pins, reset, unused outputs | All 8 clean |
| 57 | FSM transitions, ROM completeness, CDC, synthesis, test gaps, CI, tiles | TF32+BCD tests added |
| 58 | Cocotb compat, formal depth, GLS parity, gen_rom, D2D, Makefile, fmt_id=0, SDC | total_bits overflow documented |
| 59 | ena=0, ROM latency, MODULE order, golden independence, PDK variant, source_files, tb_rom | Circular golden dependency broken |
| 60 | Comb loops, Timer(1,ns), formal covers, anchor under STATUS, tt/ submodule, config overlap | tt/ unpinned (mitigated) |
| 61 | Power domains, test determinism, ROM out-of-range, decoder widths, cell budget, CI caching, formal ROM sync | Utilization corrected (14%→1%) |
| 62 | Input metastability, status counter overflow, anchor collision, D2D OE, GLS/cocotb coverage, formal gaps, info.yaml completeness | P14 assertion, 50th test |
| 63 | Decoder formal verification, Makefile MODULE, docs/info.md, SPDX headers, pin naming, timing closure, test isolation | SPDX headers added to 38 files |

**Total: 50+ audit areas across 10 loops. 0 CRITICAL, 0 HIGH, 0 MEDIUM remaining. All resolved.**

## Metrics

- New audit areas investigated: 7
- Issues found: 0 HIGH, 1 MEDIUM (SPDX headers — resolved), 1 LOW (info.md — resolved), 5 PASS
- Files fixed: 38 formal files (SPDX headers) + docs/info.md (2 accuracy fixes)
- Days to deadline: 20
- Consecutive precheck passes: 13

---

## Three Collaboration Options for Next Loop

### Option A: Final Submission — Fill Discord + Freeze + Submit

50+ audit areas across 10 loops. 0 remaining issues. 13 consecutive precheck passes. 50 cocotb tests, 58 formal tasks, 76 GLS vectors, 23 spec cross-checks. Fill discord in info.yaml (if desired), tag release, freeze codebase, and submit to TTGF26a. Begin post-silicon preparation: document microcotb test porting plan for RP2350 demoboard.

### Option B: Release Tagging + Submission Checklist

Create a `v1.0.0-ttgf26a` git tag marking the submission snapshot. Run through a formal submission checklist: verify GDS artifact matches HEAD, check info.yaml against TT template validator, confirm docs/info.md renders correctly on TT datasheet page. This is the "measure twice, cut once" option before final submission.

### Option C: Post-Silicon Test Framework + ARITH 2026 Preparation

Begin building the microcotb-based post-silicon test framework for the RP2350 demoboard. Port the anchor probe, ROM readback, and key decoder tests to MicroPython. Simultaneously prepare a format coverage summary for the ARITH 2026 community (June 28, Fulda) — a table showing Corona's 80-format ROM vs published format specifications.
