gHashTag/tt-trinity-corona/docs/REPORT_2026-06-02_loop61.md

# Loop 61 Report -- 2026-06-02

## Summary

**Utilization claim corrected (14% → ~1%). Audit: 7 new areas — 0 HIGH, 3 MEDIUM (decoder format ambiguity, CI tool pinning, formal ROM sync fragility), 4 LOW. GDS: 10th consecutive precheck PASS confirmed (Loop 59), 11th pending (Loop 60). Research: EULER-ADAS multi-width posit engine, VMXDOTP RISC-V MX ISA extension, runtime-certified format switching, TTGF0p2 silicon received, Yosys 0.65 arith_tree. 49 cocotb tests, CI all green.**

## Weakness Audit: 7 New Areas

### MEDIUM (3)

| # | Finding | Status |
|---|---|---|
| M1 | Decoder output format ambiguity — BCD returns 7-bit `{25'b0, bin}`, LNS8 returns `{sign, 15'b0, mag}`, others return FP32/INT32. No type tag in result stream to distinguish. Consumer must know format. | **BY DESIGN** — documented in PLAN, no action for tapeout |
| M2 | CI tool version drift — `iverilog`, `verilator`, `yosys` installed from apt without version pinning. `cocotb==2.0.1` correctly pinned. Formal job uses container (safe). Practical risk low but could flake near deadline. | **ACCEPTED** — optional improvement post-tapeout |
| M3 | Formal ROM sync fragility — `fv_rom.sv` contains 80 golden assertions checked against actual `format_rom.v`. No automated tool regenerates fv_rom.sv from gen_rom.py CATALOG. CI catches mismatches, but process is manual. ROM is frozen for tapeout. | **ACCEPTED** — safe for current shuttle, maintenance risk for future |

### LOW (4, all clean)

| Area | Finding |
|---|---|
| Power-domain correctness | VPWR/VGND in user_config.json matches GF180MCU 7T5V0 cell library. I/O domains (VDDA1/VSSA1) handled by TT mux above project boundary. DEF template `tt_block_4x4_pgvdd.def` consistent. |
| Cocotb test determinism | All 49 tests fully deterministic. Only `random` usage is `Random(42)` fixed seed in `test_tf32_random_sample`. No wall-clock, no OS randomness. |
| ROM address out-of-range | `format_rom.v` default returns 0 for addr 80-127. Decoder mux returns NOT_IMPL sentinel. Tested by `test_out_of_range_decode` (fmt_id=80,100,126). Formal proof `fv_rom.sv` line 43 covers all addresses. |
| Synthesis cell count / budget | 2,308 cells on 1,061,520 um^2 die = ~1.7% site utilization (~1% gate equivalent). README claimed "~14%" — corrected to "~1%". No routing congestion risk. Massive margin. |

## Implementation

### 1. README Utilization Correction

Fixed inaccurate claim in README.md:
- Before: `Synthesizes to 2,308 cells (~14% of 4x4 budget)`
- After: `Synthesizes to 2,308 cells (~1% of 4x4 site budget)`

Calculation: Die area 1440.32 x 736.96 um, GF180MCU 7T5V0 site 0.56 x 3.92 um, ~483K total sites, 2,308 cells x 3.5 avg sites = ~8K used = 1.7%.

## Scientific Research

### Posit/LNS Hardware

| Paper | Source | Key Finding |
|---|---|---|
| EULER-ADAS | arXiv:2605.06875 (May 2026) | SIMD-unified logarithmic-posit engine for Posit-(8,0)/(16,1)/(32,2) with format switching. 41.4% LUT reduction, 76.1% delay reduction vs exact posit. Directly validates Corona's multi-format oracle concept. |
| Logarithmic-Posit (LP) | arXiv:2403.05465 | Hybrid posit/LNS adaptive data type with genetic-algorithm parameterization. Covers the posit-LNS boundary in Corona's catalog. |

### MX/OCP Format Hardware

| Paper | Source | Key Finding |
|---|---|---|
| VMXDOTP | arXiv:2603.04979 (DATE '26) | RISC-V Vector ISA extension for native MXFP8/MXFP4 dot products, 250 MXFP4-GFLOPS in 12nm. First vectorized ISA-level MX support. |
| MXDOTP | IEEE Xplore 11113623 | Scalar Snitch RISC-V core with MXFP8 E5M2/E4M3 dot-product-accumulate via FP9 intermediate. 356 GFLOPS/W at 12nm. |
| DMA (Diagonal-Tiled MX Attention) | arXiv:2604.03950 | Fused Triton kernel for MXFP attention on B200 GPUs. Shows need for format-conversion correctness between FP16 and MXFP4/8. |
| AMXFP4 | arXiv:2411.09909 (ACL 2025) | Asymmetric FP8 shared scales for MXFP4. Custom MX MAC in 4nm, only 10% area overhead. MX family actively extending. |

### BitNet/Ternary

| Paper | Source | Key Finding |
|---|---|---|
| LUT-Based Ternary HW Generator | arXiv:2604.25183 (Apr 2026) | Open-source generator + cost model for BitNet b1.58 accelerators, TSMC 16nm validated. 2.2x area reduction vs multipliers. |
| Platinum | arXiv:2511.21910 | ASIC accelerator for BitNet b1.58: 73.6x speedup in 0.96mm^2. Adaptive ternary/bit-serial switching. |

### Format-Aware Runtime

| Paper | Source | Key Finding |
|---|---|---|
| Runtime-Certified Quantized Attention | arXiv:2605.20868 (May 2026) | Tiered KV cache with adaptive {INT4, INT8, FP16} precision, online per-head error bounds. Motivation paper for format-conversion oracles. |
| FlexQuant | arXiv:2506.12024 (Jun 2026) | Dynamic precision switching mid-inference. Format-correct conversion between precisions is safety-critical. |

### Ecosystem

| Item | Source | Key Finding |
|---|---|---|
| TTGF0p2 silicon received | Crowd Supply | GF180MCU test shuttle wafers received Apr 19, 2026. Bring-up in progress. Will validate Corona's GF180MCU flow. |
| NVFP4 in llama.cpp | PR #22196 | GGML_TYPE_NVFP4 landed with Blackwell tensor core path. Production FP4 E2M1 consumption. |
| MXFP4 multi-vendor | AMD MI355X + Intel Gaudi + NVIDIA Blackwell | MX format support now live across all major GPU vendors. |
| Yosys 0.65 | GitHub release | `arith_tree` pass for carry-save adder tree optimization. New `synth_analogdevices`. |
| cocotb 2.1-dev | Docs | Verilator SAIF tracing for power estimation, pytest plugin, `@cocotb.xfail`/`@cocotb.skipif` decorators. |
| ISCA 2026 | June 27, Raleigh | Shannon bound LLM compression (ETH/NUS), DIAMoND heterogeneous MoE (edge inference). |
| Essenceia BF16 MAC | IHP 130nm | Open-source bfloat16 systolic MAC with DFT, 75 MHz measured. Post-silicon testing model for GF180MCU. |
| Latch-Up 2026 | May 1-3, Waterloo | GF180MCU porting talks, FuseSoC/SiliconCompiler interop, TT workshop. Recordings on YouTube. |
| 120-student mass tapeout | Electronics Weekly | Largest TT workshop: 120 students, 10 UK universities. Ecosystem maturity signal. |
| EU 40M EUR funding | zerotoasiccourse.com | Three consortia for open-source chip tooling approved, work started 2026. |

### Standards

| Standard | Status |
|---|---|
| IEEE P3109 | Still pre-ballot. No 2026 meeting minutes published. FLoPS formalization is latest contribution. |
| IEEE 754-2029 | Committee restarted. Key topic: mandating correctly-rounded transcendentals (CORE-MATH). Current 754-2019 expires 2029. |

## GDS Status

```
Precheck passes: 10 CONSECUTIVE confirmed (11th pending)
GDS #26786475682:  in progress (Loop 60 commit ca5b926)
  gds: PASS, gl_test: PASS, precheck: running
GDS #26785963978:  PASS (Loop 59 commit 60a8dc0)
  gds: PASS, gl_test: PASS, precheck: PASS (viewer cosmetic fail)
Previous: 9 consecutive passes confirmed
All with: BOTTOM_MARGIN_MULT=1, TOP_MARGIN_MULT=1
```

## Verification Status

```
Verilator lint:        PASS (0 warnings)
Yosys synthesis:       PASS (2,308 cells, ~1% of 4x4 site budget)
Formal (sby):          19 configs, 57 tasks (bmc+prove+cover)
Cocotb:                49 tests (5 anchor + 29 decoders + 15 stress)
GL tests:              PASS (49/49 on Loop 60 GDS)
GLS smoke:             PASS (76 golden vectors)
ROM spec cross-check:  PASS (23/23 formats, CI gate)
GitHub CI:             PASS (all green)
GDS + Precheck:        PASS (10 consecutive, 11th pending)
Submission status:     READY
```

## Audit Coverage (Loops 54-61)

| Loop | Areas | Key Findings |
|---|---|---|
| 54 | Precheck root cause | MARGIN_MULT fix (CRITICAL, fixed) |
| 55 | Shift register, mux, docs | byte_count test, LibreLane rebrand |
| 56 | Multi-byte alignment, ROM golden, timing, pins, reset, unused outputs | All 8 clean |
| 57 | FSM transitions, ROM completeness, CDC, synthesis, test gaps, CI, tiles | TF32+BCD tests added |
| 58 | Cocotb compat, formal depth, GLS parity, gen_rom, D2D, Makefile, fmt_id=0, SDC | total_bits overflow documented |
| 59 | ena=0 all states, ROM latency, MODULE order, golden independence, PDK variant, source_files order, tb_rom independence | Circular golden dependency broken |
| 60 | Comb loops/latches, Timer(1,ns), formal covers, anchor under STATUS, tt/ submodule, config overlap | tt/ unpinned (mitigated), Timer fragility noted |
| 61 | Power domains, test determinism, ROM out-of-range, decoder widths, cell budget, CI caching, formal ROM sync | Utilization claim corrected (14% → 1%), all areas clean |

**Total: 36+ audit areas across 8 loops. 0 CRITICAL, 0 HIGH remaining. 0 blocking issues. 1 open user decision (discord field).**

## Metrics

- New audit areas investigated: 7
- Issues found: 0 HIGH, 3 MEDIUM (all accepted/by-design), 4 LOW
- Documentation fix: utilization claim corrected
- New papers cataloged: 14 papers + 11 ecosystem/standards updates
- Days to deadline: 20
- Consecutive precheck passes: 10 (11th pending)

---

## Three Collaboration Options for Next Loop

### Option A: Final Submission — Fill Discord + Freeze + Submit

All critical and high-severity audit findings resolved across 8 loops. 36+ areas investigated, 0 blocking issues. TTGF26a closes June 22 (20 days). Fill discord in info.yaml (user decision), freeze the codebase, and submit. Begin post-silicon preparation: document microcotb test porting plan for RP2350 demoboard HIL testing when TTGF0p2 bring-up results arrive.

### Option B: 50th Test Milestone + CI Hardening

Two improvements: (1) Add 50th cocotb test — `test_full_rom_readback_sweep` that reads all 80 ROM records and validates fmt_id self-index (currently only in formal, adds simulation regression coverage). (2) Pin iverilog/verilator versions in CI to prevent tool drift near deadline. Both are low-risk changes that strengthen the submission without touching RTL.

### Option C: EULER-ADAS Posit Analysis + VMXDOTP MX Validation

Deep-dive the EULER-ADAS multi-width posit engine (arXiv:2605.06875) to compare its bounded-regime decoding against Corona's posit8_decode.v. Simultaneously analyze the VMXDOTP RISC-V MX ISA extension to verify Corona's MX format metadata aligns with the hardware's expected encoding. Both produce validation evidence for the ARITH 2026 community (June 28, Fulda).
