gHashTag/tt-trinity-corona/docs/REPORT_2026-06-02_loop59.md

# Loop 59 Report -- 2026-06-02

## Summary

**Critical audit finding resolved: ROM golden values were circular. Independent spec cross-check now validates 23 key formats against published specs (IEEE 754, OCP MX, etc.). Mid-transaction reset test added (CMD2, DATA, STATUS states). 48 cocotb tests. GDS #26785592328 pending (Loop 58: 8th precheck PASS confirmed).** Research found microcotb for post-silicon HIL testing, Quartet (native MXFP4 training), SOAR/RaZeR NVFP4 advances, and PT-BitNet (70B ternary quantization).

## Weakness Audit: 7 New Areas

### HIGH (2, both RESOLVED)

| # | Finding | Status |
|---|---|---|
| H1 | ROM golden values in fv_rom.sv/tb_rom_golden.v are NOT independent — all derive from gen_rom.py CATALOG | **RESOLVED** — `test_rom_spec_crosscheck.py` validates 23 key formats against published specs (IEEE 754 Table 3.5, OCP MX v1.0, etc.) |
| H2 | Same circular dependency in cocotb test_decoders.py (imports gen_rom.py) | **RESOLVED** — same cross-check script, plus decoder reference models are independently coded |

### Confirmed Correct (5/7 new areas)

| Area | Finding |
|---|---|
| ena=0 gate behavior | Formal P3 proves all 6 registers frozen in ALL states when ena=0. Cocotb tests only ST_CMD2 (low risk, formal covers all) |
| ROM read latency | No off-by-one: fmt_id_r latched cycle N, ROM registered cycle N+1, STATUS begins cycle N+2. One cycle margin |
| Cocotb MODULE ordering | Each test calls reset_dut() — no state leaks. Order irrelevant |
| gf180mcuD PDK variant | Correct variant for TTGF26a. DEF template matches. 8+ precheck passes confirm |
| info.yaml source_files order | Verilog two-pass compilation — order irrelevant. All 3 manifests (info.yaml, user_config.json, test/Makefile) consistent |

## Implementation

### Independent ROM Spec Cross-Check (H1/H2 fix)

Created `test/test_rom_spec_crosscheck.py`:
- 23 formats with independently derived expected values from published specs
- Checks total_bits, sign_bits, exp_bits, mant_bits against ROM packing
- Sources: IEEE 754-2019 Table 3.5, OCP MX Spec v1.0 §4, Google Brain BF16 spec, NVIDIA TF32, AMD CDNA3 FNUZ, Posit standard draft
- Result: ALL 23 PASS

Formats verified:
- IEEE 754: fp16, fp32, fp64, fp128
- ML: bf16, tf32, fp8_e5m2, fp8_e4m3, fp8_e4m3_fnuz
- OCP MX: mxfp8_e4m3, mxfp6_e3m2, mxfp4_e2m1, e8m0, mxint8
- ML sub-8-bit: fp6_e3m2, fp4_e2m1
- Other: posit8, int4, int8, bcd, lns8, nf4, bitnet

### Mid-Transaction Reset Test (GLS/cocotb parity)

Added `test_mid_transaction_reset` to `test/test_stress.py`:
- Case 1: Reset during ST_CMD2 → verify anchor works after recovery
- Case 2: Reset during ST_DATA (mid-byte collection) → verify anchor works
- Case 3: Reset during ST_STATUS (mid-readback) → verify anchor works
- Case 4: Full decode transaction after all resets → verify correctness

This closes the GLS/cocotb parity gap (GLS test 76 was the only unique test).

### Documentation Updates

- README.md: test count 47 → 48
- src/tb/README.md: cocotb 47 → 48, GL tests 47 → 48

## Scientific Research

### Post-Silicon Testing (Major Finding)

**microcotb** — Lightweight cocotb variant running on microcontrollers for hardware-in-the-loop (HIL) testing of TT designs. The TT demoboard RP2350 runs microcotb testbenches directly against the ASIC via MicroPython SDK. Corona's post-silicon ROM readback tests could be ported from cocotb simulation to microcotb on the demoboard.

**FabricFox FPGA Breakout** (Latch-Up 2026) — Lattice iCE40 UP5K board pin-compatible with TT demoboard for pre-silicon FPGA validation.

**Spacely Framework** (arXiv:2406.15181) — Open-source post-silicon validation for analog/digital/mixed-signal ASICs.

### New Format Research

| Paper | Source | Key Finding |
|---|---|---|
| Quartet | arXiv:2505.14669 (NeurIPS 2025) | Native MXFP4 training matches FP8 Pareto frontier, 2x speedup on Blackwell RTX 5090 |
| SOAR | arXiv:2605.12245 | Scale optimization for NVFP4 via Closed-form Joint Scale Optimization |
| ARCQuant | arXiv:2601.07475 | Augmented residual channels for NVFP4, worst-case error matching MXFP8 |
| RaZeR | arXiv:2501.04052 | Redundant zero remapping in NVFP4 — unexploited code points in E2M1 |
| PT-BitNet | Neural Networks 2026 | First post-training ternary quantization at 70B scale |
| Sherry | arXiv:2601.07892 | LUT-based ternary engines replacing FP multiplications with additions |
| NxFP | arXiv:2412.19821 | Per-element nanoscaling, 40% error reduction over MX |
| Fast NF4 | arXiv:2604.02556 | 2x kernel speedup for NF4 dequantization (ASPLOS EMC2 Workshop) |

### Industry Updates

- **NVFP4 in llama.cpp**: Merged April 2026, giving NVFP4 ecosystem parity with MXFP4
- **wafer.space Run 1**: GF180MCU, 1000 bare dies at $7K/slot, shipped March 2026
- **Yosys 0.65-dev**: arith_tree pass for carry-save adder tree optimization
- **cocotb 2.1-dev**: TaskManager, select(), gather() concurrency primitives
- **ISCA 2026** (June 28, Raleigh): SingularBit (SVD+low-bit quant), HATorch (hw-aware training)

### Standards

- IEEE P3109: still pre-ballot; FLoPS/Wintersteiger formal verification treating draft as stable
- IEEE 754-2029: in planning; may mandate correctly-rounded functions
- OCP MX: remains v1.0; MX+, NxFP, MX-SAFE propose extensions

## GDS Status

```
Precheck passes: 8+ CONSECUTIVE (9th pending)
GDS #26785592328:  in progress (Loop 58 commit)
GDS #26784554391:  PASS (Loop 57 commit — GDS ✅, GL tests ✅, precheck ✅)
Previous: 7 consecutive passes confirmed
All with: BOTTOM_MARGIN_MULT=1, TOP_MARGIN_MULT=1
```

## Verification Status

```
Verilator lint:        PASS (0 warnings)
Yosys synthesis:       PASS (2,308 cells)
Formal (sby):          19 configs, 57 tasks (bmc+prove+cover)
Cocotb:                48 tests (was 47, +1 mid-transaction reset)
GL tests:              PASS (47/47 on previous commit)
GLS smoke:             PASS (76 golden vectors)
ROM spec cross-check:  PASS (23/23 formats vs published specs)
GitHub CI:             PASS (all green)
GDS + Precheck:        PASS (8 consecutive, 9th pending)
Submission status:     READY
```

## Audit Coverage (Loops 54-59)

| Loop | Areas | Key Findings |
|---|---|---|
| 54 | Precheck root cause | MARGIN_MULT fix (CRITICAL, fixed) |
| 55 | Shift register, mux, docs | byte_count test, LibreLane rebrand |
| 56 | Multi-byte alignment, ROM golden, timing, pins, reset, unused outputs | All 8 clean |
| 57 | FSM transitions, ROM completeness, CDC, synthesis, test gaps, CI, tiles | TF32+BCD tests added |
| 58 | Cocotb compat, formal depth, GLS parity, gen_rom, D2D, Makefile, fmt_id=0, SDC | total_bits overflow documented |
| 59 | ena=0 all states, ROM latency, MODULE order, golden independence, PDK variant, source_files order, tb_rom independence | **Circular golden dependency broken** with spec cross-check |

**Total: 23+ audit areas across 6 loops. 0 CRITICAL, 0 HIGH remaining. 1 open user decision (discord field).**

## Metrics

- New audit areas investigated: 7
- Issues found: 2 HIGH (circular ROM golden — resolved), 5 LOW
- New test: mid-transaction reset (CMD2, DATA, STATUS states)
- Spec cross-check: 23 formats verified against published specs
- Cocotb tests: 48 (was 47)
- New papers cataloged: 8 format papers + 3 post-silicon tools
- Days to deadline: 20

---

## Three Collaboration Options for Next Loop

### Option A: Final Submission — Fill Discord + Freeze + Post-Silicon Plan

All critical audit findings resolved across 6 loops. 23+ areas investigated, 0 blocking issues. Fill discord in info.yaml, submit to TTGF26a, and freeze. Begin post-silicon preparation: port cocotb tests to microcotb for RP2350 demoboard HIL testing. Prepare format coverage table for ARITH 2026 (June 28, Fulda) community.

### Option B: Add CI Job for ROM Spec Cross-Check + ena=0 Multi-State Test

Two concrete improvements: (1) Add `test_rom_spec_crosscheck.py` as a CI job to catch any future ROM edits that diverge from published specs. (2) Add `test_ena_gate_multi_state` testing ena=0 in ST_DATA and ST_STATUS (currently only ST_CMD2 in cocotb, formal covers all but simulation adds GLS confidence). Reach 49 tests.

### Option C: microcotb Post-Silicon Framework + NxFP/Quartet Format Analysis

Begin building the microcotb-based post-silicon test framework for the TT demoboard RP2350. Port the anchor probe and ROM readback tests to MicroPython. Simultaneously analyze the NxFP nanoscaling and Quartet MXFP4 training results to determine if Corona's ROM entries need metadata updates (e.g., MXFP4 status from EXPERIMENTAL → SPEC given Quartet's NeurIPS validation).
