gHashTag/tt-trinity-corona/docs/REPORT_2026-06-02_loop56.md

# Loop 56 Report -- 2026-06-02

## Summary

**Clean audit: 0 CRITICAL, 0 HIGH, 0 MEDIUM issues. 6th consecutive precheck PASS.** Weakness audit confirmed all 8 investigated areas (shift register alignment, decoder mux, ROM golden test, timing constraints, pin assignments, reset behavior, unused outputs, multi-byte formats) are correct. Scientific research found DotProduct_FP4 open-source hardware (direct competitor/reference), MF-QAT multi-format training, and DAC 2026 date correction (July, not June). Design is solidly submission-ready.

## Weakness Audit: All Clear

### Confirmed Correct (8/8 areas)

| Area | Finding |
|---|---|
| TF32 3-byte alignment | data_in_buf[26:8] correctly extracts 19-bit TF32 from LSByte-first shift register |
| BF16 2-byte alignment | data_in_buf[31:16] correctly extracts 16-bit BF16. Exhaustive 65536-value test passes |
| Decoder output mux | 22 cases, no gaps/overlaps, proper default clause. 1:1 match with FLAG_ON_DIE set |
| ROM golden test | Circular cocotb test mitigated by independent tb_rom_golden.v (800 hardcoded assertions in CI) |
| Timing closure | constraint.sdc: 40ns period, 25% I/O delays. Matches info.yaml clock_hz |
| Pin assignments | All 24 pins in info.yaml match RTL port usage exactly |
| Reset behavior | All 6 state registers properly reset. Formal P2 proves completeness |
| Unused outputs | uio_oe/uio_out always driven. _unused wire lists all suppressed signals |

### LOW Findings (4, informational only)

| # | Finding | Impact |
|---|---|---|
| L1 | uio_oe not gated by FSM state (anchor cmd during ST_STATUS) | Protocol prevents; no real scenario |
| L2 | Circular ROM golden test in cocotb (imports gen_rom.py) | Mitigated by tb_rom_golden.v with hardcoded values |
| L3 | ui[0] pin label "mode_lsb_or_fmt_id_b0" slightly misleading | Cosmetic only |
| L4 | TF32 test missing byte2 values 5 and 6 | Formal verification covers exhaustively |

## Scientific Research

### DotProduct_FP4 (New Open-Source Hardware)

GitHub: Wonjun-Han/DotProduct_FP4 (Chisel + cocotb)
- 256-element parallel MXFP4×MXFP4 multiplication
- FP4-to-FP32 format converter (Convert module)
- Pipelined FP32 adder tree, optimized for >1 GHz
- Direct analogue to Corona's Tier-1 decoders; validates cocotb verification approach

### DAC 2026 Date Correction

DAC 2026 is **July 26-29, Long Beach** (not June 22-25 as previously assumed). One month after TTGF26a deadline. DAC 2025 paper: "Pareto Frontier of Low-Precision Data Formats" (IEEE 11132989) — LNS16, MXINT8, VSQINT4 achieve 1.8-2.2x TOPs/W over FP16/FP8/FP4, validating Corona's breadth-as-moat thesis.

### New Papers

| Paper | Date | Key Finding |
|---|---|---|
| MF-QAT (arXiv:2604.00529) | 2026-04 | Multi-format training: single MXINT8 checkpoint converts on-the-fly to lower MX precisions. Validates format-aware oracle concept |
| SPADE (arXiv:2601.17279) | 2026-01 | SIMD Posit MAC: Posit(8,0), (16,1), (32,2). 45% LUT reduction, 4x MACs/W |
| PHEE (arXiv:2501.18253) | 2026 | Open-source RISC-V posit coprocessor, 16nm TSMC. 38% area, 42.3% power reduction vs FP |
| HIF Format (arXiv:2605.14929) | 2026-05 | New E2M3sUE4M4 at 6.5 bpw beats FP8 E4M3 at 8.0 bpw |

### TTGF26a Shuttle Status

- 20 days to deadline (June 22)
- TinyTapeout/tinytapeout-gf-26a: 2 PRs visible
- Sheffield workshop: 120+ students taped out designs May 5 — may boost TTGF26a count
- wafer.space Run 2 GDS deadline: June 30 (8 days after TTGF26a)
- LibreLane 3.0: new Chip flow, NixOS 25.11, IHP support

## GDS Status

```
Precheck passes: 6 CONSECUTIVE
GDS #26783122983:  PASS (Loop 55 final report push)
GDS #26782301814:  PASS (test fix)
GDS #26781517933:  PASS (doc updates)
GDS #26781259723:  PASS (Loop 54 report)
GDS #26780418485:  PASS (MARGIN_MULT fix — first pass)
All with: BOTTOM_MARGIN_MULT=1, TOP_MARGIN_MULT=1
```

## Verification Status — ALL GREEN

```
Verilator lint:        PASS (0 warnings)
Yosys synthesis:       PASS (2,308 cells)
Formal (sby):          19 configs, 57 tasks (bmc+prove+cover)
Cocotb:                PASS (45 tests)
GL tests:              PASS (45/45)
GitHub CI:             PASS (all green)
GDS + Precheck:        PASS (6 consecutive)
Submission status:     READY
```

## Metrics

- Audit areas investigated: 8 (all clean)
- Issues found: 0 critical, 0 high, 0 medium, 4 low (informational)
- New open-source FP4 hardware found: DotProduct_FP4
- New papers: 5 (MF-QAT, SPADE, PHEE, HIF, DAC 2025 Pareto)
- Precheck consecutive passes: 6
- Days to deadline: 20

---

## Three Collaboration Options for Next Loop

### Option A: Submit to TTGF26a + Freeze Repo

Design is fully validated: 6 precheck passes, 0 blocking issues, all tests green. Fill the empty Discord field in info.yaml, make a final commit, and freeze. The 20-day buffer means we can submit early and still respond to any TT infrastructure changes. Focus shifts to post-silicon planning: test board design, RP2040 firmware, tt-commander Python framework.

### Option B: Add HIF Format ROM Entry + DotProduct_FP4 Cross-Validation

Two actionable items from research: (1) Add HIF E2M3sUE4M4 as ROM entry 80 — a genuinely new format from May 2026 that outperforms FP8 E4M3. (2) Cross-validate Corona's FP4 decoder against DotProduct_FP4's Convert module — independent verification of the same format conversion. Both are low-risk additions that enhance Corona's catalog without touching the GDS-critical path.

### Option C: MF-QAT Format Conversion Matrix + ARITH 2026 Positioning

The MF-QAT paper proves single-checkpoint multi-format deployment works via "Slice-and-Scale" transformations. Build a conversion relationship matrix showing which Corona ROM entries can derive from which others (e.g., MXINT8 → MXINT4 via slicing). This positions Corona as a format conversion reference for the ARITH 2026 conference (June 28, Fulda) and validates the breadth-as-moat thesis with concrete conversion paths.
