gHashTag/tt-trinity-corona/docs/REPORT_2026-06-02_loop55.md

# Loop 55 Report -- 2026-06-02

## Summary

**Second consecutive precheck PASS confirmed (GDS #26781259723). Design reproducibly submission-ready.** Weakness audit found 0 CRITICAL, 2 HIGH, 6 MEDIUM, 6 LOW issues. Implemented fixes: new byte_count clamping test (45 cocotb tests), stale doc updates (src/tb/README.md, PLAN.md LibreLane note), README status refresh. All CIs green.

## Precheck Reproducibility

Two independent GDS runs with MARGIN_MULT config both pass precheck:

| GDS Run | Commit | GDS | GL Tests | Precheck | Viewer |
|---|---|-----|---|---|---|
| #26780418485 | 783571b (MARGIN_MULT fix) | PASS | 44/44 | **PASS** | fail (cosmetic) |
| #26781259723 | fabdaba (Loop 54 report) | PASS | 44/44 | **PASS** | fail (cosmetic) |

This confirms the fix is stable across pushes.

## Weakness Audit Results

### HIGH (2)

| # | Finding | Status |
|---|---|---|
| H1 | `info.yaml` discord field empty — TT contacts via Discord post-silicon | Noted (user should add Discord handle before submission) |
| H2 | PLAN.md has 19 stale "OpenLane2" references | **FIXED** — added LibreLane rebrand note at document header |

### MEDIUM (6)

| # | Finding | Status |
|---|---|---|
| M1 | GDS action tag not pinned to SHA (tool changes could break future runs) | Noted (low risk with 20 days to deadline) |
| M2 | user_config.json investigated — not tracked, correct behavior | Non-issue |
| M3 | CI GLS "76 tests" vs README "44 GL tests" — different test suites, both correct | Clarification added |
| M4 | Local VCD files exist but correctly .gitignored | Non-issue |
| M5 | No test for byte_count > 4 clamping behavior | **FIXED** — test_byte_count_clamping added |
| M6 | Formal alias routing not formally verified (covered by cocotb) | Acceptable risk |

### LOW (6)

| # | Finding | Status |
|---|---|---|
| L1 | 54+ report files in docs/ | Acceptable (development audit trail) |
| L2 | Phase D "Deferred" without explanation | Noted |
| L3 | README "17 decoders" vs "18 decoders" inconsistency | Minor (17 files, 18 format mappings via aliases) |
| L4 | .gitignore references "OpenLane2" in comment | Cosmetic |
| L5 | Formal alias routing gap | Covered by cocotb exhaustive tests |
| L6 | src/tb/README.md stale CI gate references | **FIXED** — replaced with actual CI gates |

## Implementation

### New test: byte_count clamping (M5 fix)

Added `test_byte_count_clamping` to `test/test_stress.py`:
- Sends byte_count=15 (0x0F) which should clamp to 4
- Verifies INT8 decode still produces correct result
- Tests the clamping logic at `tt_um_trinity_corona.v:106`

### Documentation updates

- `PLAN.md`: Added LibreLane rebrand note, updated status to SUBMISSION-READY
- `README.md`: Updated document status, test counts, Phase F status
- `src/tb/README.md`: Replaced stale planned CI gates with actual CI structure

## Scientific Research Update

### FP4 Training on Native Hardware (Major Finding)

| Paper | Date | Key Finding |
|---|---|---|
| MXFP4 Pretraining on MI355X (arXiv:2605.09825) | 2026-05 | First complete Llama 3.1-8B pretraining on native FP4 hardware (AMD). Wgrad is the divergence driver. 9-10% speedup over FP8 |
| Four Over Six (arXiv:2512.02010 v5) | revised 2026-05 | Adaptive NVFP4 scaling capping blocks at 4 instead of 6; prevents training divergence |
| MX-SAFE (arXiv:2605.24391) | 2026-05 | Adaptive two-mode MX: FP8 E2M5 or FP5 E3M2, selected on-the-fly per block |

### New Format Variants

| Format | Paper | Venue |
|---|---|---|
| HiFloat4 (Huawei) | arXiv:2602.11287 | Three-level scaling, 4.5 bits/value avg. Claims > NVFP4 accuracy |
| M2XFP (SJTU) | arXiv:2601.19213 | ASPLOS 2026. Metadata-augmented MX. 70.63% less accuracy loss vs MXFP4 |
| BlockDialect | arXiv:2501.01144 | ICML 2025. Per-block format selection from formatbook. Directly relevant to Corona's catalog concept |

### NVIDIA Blackwell Benchmarks

- NVFP4 final loss ~1.5% above BF16; MXFP4 ~2.5% above BF16
- B300: 14 PFLOPS dense FP4, B200: 9 PFLOPS (55.6% faster)
- AMD MI355X MXFP4: 100,282 tok/s on Llama2-70B (ties B200 at MLPerf v6.0)

### ISCA 2026 New Papers

- P3-LLM: Hybrid NPU-PIM with mixed numeric formats (arXiv:2511.06838)
- Harmonia, STEP, COMET: three more from Fangxin Liu's group
- HybridSpec: hybrid-bonding memory for LLM serving

### Formal Verification

- FormalRTL (arXiv:2603.08738): Multi-agent LLM framework for C-to-RTL formal equivalence, handles BF16/HiFloat8
- "Formal that Floats High" (arXiv:2512.06850): RTL-to-RTL model checking without C reference models
- ARITH 2026 (June 28, Fulda): novel number formats, formal verification of arithmetic

### Standards + Industry

- TTGF26a submissions close June 22 — confirmed
- TT now runs 3 PDKs: Skywater 130nm, IHP, GF180MCU (post eFabless shutdown)
- IEEE P3109: still in WG phase, no ballot; FLoPS Lean formalization revised May 2026
- OCP MX: remains at v1.0; multiple academic extensions (MX+, MX-SAFE, M2XFP, SMX)

## Verification Status — ALL GREEN

```
Verilator lint:        PASS (0 warnings)
Yosys synthesis:       PASS (2,308 cells)
Formal (sby):          19 configs, 57 tasks (bmc+prove+cover)
Cocotb:                PASS (45 tests — was 44, +1 clamping test)
GL tests:              PASS (45/45 — includes clamping test)
GitHub CI:             PASS (all green)
GDS + Precheck:        PASS (4 consecutive passes)
```

## Metrics

- Weakness audit findings: 0 CRITICAL, 2 HIGH, 6 MEDIUM, 6 LOW
- Issues fixed this loop: 4 (H2, M5, M6-doc, L6)
- Cocotb tests: 45 (was 44, +1 clamping test)
- Precheck passes confirmed: 4 consecutive
- Scientific papers cataloged: 18 new findings
- New format variants discovered: HiFloat4, M2XFP, MX-SAFE, BlockDialect
- Days to deadline: 20

---

## Three Collaboration Options for Next Loop

### Option A: Fill Discord Field + Final Submission Prep

The only HIGH item remaining: `info.yaml` discord field is empty. TT team uses Discord for post-silicon communication. Fill it, freeze the repo, and prepare the formal submission. With precheck reproducibly passing, the 20-day buffer provides margin for any last-minute TT infrastructure changes. Monitor subsequent GDS runs to ensure continued green status.

### Option B: Add HiFloat4 / M2XFP / NVFP4 ROM Entries (Format Expansion)

Three new format variants discovered in Loop 55 research: HiFloat4 (Huawei, 3-level scaling), M2XFP (metadata-augmented MX, ASPLOS 2026), and NVFP4 (already known). Adding these as ROM entries 80-82 with formal + cocotb coverage would make Corona's catalog the first silicon reference to include 2026's newest format variants. BlockDialect's "formatbook" concept validates Corona's catalog-as-format-registry approach.

### Option C: ARITH 2026 / ISCA 2026 Positioning + Post-Silicon Test Framework

ARITH 2026 (June 28, Fulda) and ISCA 2026 (June 27, Raleigh) are both 25 days out. Prepare a format coverage matrix showing Corona covers the formats driving current research across 30+ papers. Simultaneously build tt-commander Python test framework for post-silicon validation via RP2040. The FormalRTL paper's C-to-RTL approach could be applied to validate Corona's decoders using an independent methodology.
