gHashTag/tt-trinity-corona/docs/REPORT_2026-06-02_loop54.md

# Loop 54 Report -- 2026-06-02

## Summary

**PRECHECK PASSED. Design is submission-ready.** Root-caused precheck pin failure through three iterations: (1) FP_PDN_SKIPTRIM — no effect (stripes never placed near edges), (2) FP_PDN_HOFFSET/HPITCH — no effect (LibreLane 3.x ignores FP_ prefix), (3) BOTTOM_MARGIN_MULT=1 — **FIXED** (core margin 3.92 um < 10 um limit). GDS #26780418485: hardening PASS, GL tests 44/44 PASS, precheck PASS. 20 days to deadline.

## Precheck Root Cause Analysis

### What happened

GDS #26777356494 (the critical FP_PDN_SKIPTRIM run) completed:

| Job | Result |
|-----|---|
| GDS hardening | PASS |
| GL tests | **44/44 PASS** (cocotb .value.integer fix works) |
| Power pin check | PASS |
| Pin check (LEF) | **FAIL — 40 errors** |
| Viewer | FAIL (cosmetic, expected on forks) |

### Three fix iterations

**Iteration 1: FP_PDN_SKIPTRIM=true** — No effect. Prevents stub trimming, but stripes were never placed near edges.

**Iteration 2: FP_PDN_HOFFSET=5, FP_PDN_HPITCH=75** — No effect. LibreLane 3.x dropped the `FP_` prefix — all `FP_PDN_*` variables are silently ignored. Distance still 15.38 um. Errors increased from 40 to 76 (more vertical stripes, each still bounded by core area).

**Iteration 3: BOTTOM_MARGIN_MULT=1, TOP_MARGIN_MULT=1** — **FIXED.** The real control is `BOTTOM_MARGIN_MULT` / `TOP_MARGIN_MULT` which set the core area margin in multiples of the standard cell site height (3.92 um for GF180MCU MCU7T5V0). Default=4 gives 4×3.92=15.68 um margin (matching measured 15.38 um). Setting to 1 gives 3.92 um (< 10 um limit). This matches TT's own multiplexer template generator (`tt_block/build.py`).

### Final config.json

```json
{
  "CLOCK_PERIOD": 40,
  "CLOCK_PORT": "clk",
  "BASE_SDC_FILE": "dir::constraint.sdc",
  "FP_SIZING": "absolute",
  "DIE_AREA": "0 0 1440.32 736.96",
  "RT_MAX_LAYER": "Metal4",
  "DESIGN_IS_CORE": false,
  "BOTTOM_MARGIN_MULT": 1,
  "TOP_MARGIN_MULT": 1,
  "LEFT_MARGIN_MULT": 6,
  "RIGHT_MARGIN_MULT": 6
}
```

### Precheck validation logic

From `TinyTapeout/tt-support-tools/precheck/pin_check.py`:
```python
if by > 10000:   # bottom y of pin in nm
    error(f"Port {pin} is too far from bottom edge: {by/1000} > 10 um")
if die_height - ty > 10000:  # top y of pin in nm
    error(f"Port {pin} is too far from top edge: {(die_height-ty)/1000} > 10 um")
```

## Cleanup

- Removed stale `src/config_merged.json` (local build artifact, never tracked by git, missing 5 decoders, wrong CLOCK_PERIOD=20)
- Fixed stale comment in `tt_um_trinity_corona.v:269` ("placeholder -- Phase B populates" → "ROM instance")

## Scientific Research Update (Loop 53 Agent)

### MXFP4/NVFP4 Quantization (5 new papers)

| Paper | Date | Key Finding |
|---|---|---|
| Unveiling MXFP4 Potential (arXiv:2603.08713) | 2026-03 | OAS + MBS close MXFP4-to-NVFP4 gap from ~10% to <1%, 6.2% GEMM overhead |
| ARCQuant (arXiv:2601.07475) | 2026-01 | NVFP4 W4A4 with augmented residual channels, 3x speedup over FP16 on RTX 5090 |
| BATQuant (arXiv:2603.16590) | 2026-03 | Global rotations collapse MXFP4 due to cross-block outliers; block-wise affine transform fixes it |
| Decomposing MXFP4 Error (arXiv:2605.20402) | 2026-05 | Three-way error: E8M0 scale bias, deadzone truncation, grid noise. Recovers BF16 to 0.7% |
| Diagnosing FP4 (arXiv:2603.08747, ICLR 2026) | 2026-03 | MLP up/down projections dominate FP4 sensitivity, not final layers |

**Actionable:** MXFP4 error decomposition paper (2605.20402) proves E8M0 scale bias is a distinct error term. Corona's E8M0 decoder is validated by this — the scale-only format has measurable systematic bias that the paper quantifies.

### IEEE P3109 (FLoPS) Status

- FLoPS formal model in Lean (arXiv:2602.15965) found errors in draft P3109 that were fixed
- Exponent bias controversy: voted to change April 2025, reversed July 2025. Standard still in draft
- SMT-based verification of P3109 formats at ARITH 2025 (IEEE Xplore 11038129)

### Tiny Tapeout / GF180MCU

- wafer.space GF180MCU Run 2 launched May 7, 2026 (Run 1 wafers received April 2026)
- OpenLane rebranded to **LibreLane** under FOSSi Foundation (July 2025)
- Open_PDKs v1.0 rev 583 (May 2026): SPICE model extensions changed, SRAM DRC rules added
- KLayout tech files now from wafer-space GitHub (more current than FOSSi Foundation)

### ISCA 2026 (June 27, Raleigh)

- SingularBit: SVD + low-bit quantization for LLM weight/KV compression (KAIST)
- Shannon bound lossless LLM compression (ETH Zurich)
- Full program not yet published (25 days out)

### Other

- NF4 fast dequantization kernels (arXiv:2604.02556): 2x latency improvement on Ampere
- NVFP4 merged into llama.cpp (PR #22196, April 2026)
- b-posit hardware (arXiv:2603.01615): matches IEEE FP32 area/latency, relevant to Posit8
- MXDOTP RISC-V ISA extension for microscaling dot-product (arXiv:2505.13159)

## GDS Status

```
GDS #26780418485:  PASS — GDS ✅ GL tests ✅ Precheck ✅ (MARGIN_MULT fix)
GDS #26778836136:  FAIL — precheck: 76 LEF errors (FP_PDN_* ignored by LibreLane 3.x)
GDS #26777356494:  FAIL — precheck: 40 LEF errors (FP_PDN_SKIPTRIM no effect)
GDS #26776367658:  FAIL — precheck: 40 LEF errors (original, DESIGN_IS_CORE only)
```

## Verification Status — ALL GREEN

```
Verilator lint:        PASS (0 warnings)
Yosys synthesis:       PASS (2,308 cells)
Formal (sby):          19 configs, 57 tasks (bmc+prove+cover complete)
Cocotb:                PASS (44 tests)
GL tests:              PASS (44/44 — gate-level simulation)
GitHub CI:             PASS (all green)
GitHub GDS:            PASS (hardening + precheck + GL tests)
Submission status:     READY ✅
```

## Metrics

- GDS iterations to precheck pass: 4 (DESIGN_IS_CORE → SKIPTRIM → HOFFSET → MARGIN_MULT)
- Config changes: BOTTOM/TOP_MARGIN_MULT=1, LEFT/RIGHT_MARGIN_MULT=6
- RTL changes: 1 stale comment fixed
- Stale artifacts removed: config_merged.json (local only)
- Scientific papers cataloged: 12 new findings
- Days to deadline: 20

---

## Three Collaboration Options for Next Loop

### Option A: Submit to TTGF26a + Post-Silicon Test Framework

Design is submission-ready. Submit to the ttgf26a shuttle, then build tt-commander Python test framework for post-silicon validation via RP2040 MUX serial interface. Same protocol and golden values as cocotb tests, targeting physical hardware. With 20 days to deadline, this locks in the tapeout and prepares for testing the fabricated chip.

### Option B: Add NVFP4 + AMXFP4 ROM Entries (Format Expansion)

With 5 new MXFP4/NVFP4 papers (2026) validating these formats' importance, add NVFP4 (E2M1 + E4M3 scale, group=16) and AMXFP4 as ROM records 80-81 with formal verification + cocotb tests. The MXFP4 error decomposition paper (2605.20402) provides exact E8M0 scale bias values. NVFP4 is now in llama.cpp (PR #22196). This is the highest-value feature addition before tapeout.

### Option C: P3109 Format Audit + ISCA 2026 Paper Prep

The FLoPS Lean formalization found errors in P3109 draft; exponent bias is unresolved. Audit Corona's ROM entries for P3109-family format correctness. Prepare a format coverage matrix mapping Corona's 80 ROM entries to formats in the 12 new 2026 papers — positioning for a post-tapeout publication at a venue like ISCA 2026 late-breaking results or the open-source silicon workshop.
