gHashTag/tt-trinity-corona/docs/REPORT_2026-06-02_loop53.md

# Loop 53 Report -- 2026-06-02

## Summary

**Added cover tasks to all 19 formal verification configs (57 total tasks, was 44).** Complete formal coverage: every decoder now has bmc (bounded model check), prove (unbounded proof), and cover (reachability). GDS run #26777356494 with FP_PDN_SKIPTRIM + cocotb fix still hardening. CI remains green.

## Implementation: Formal Cover Completeness

### Before

| Category | Configs | Tasks |
|---|---|---|
| bmc + prove + cover | 6 (fp4, nf4, int4, bitnet, fsm, rom) | 18 |
| bmc + prove only | 13 (bf16, tf32, fp8_e5m2, fp8_e4m3_fnuz, mxfp8_e4m3, fp6_e3m2, fp6_e2m3, int8, e8m0, mxint8, posit8, lns8, bcd) | 26 |
| **Total** | **19** | **44** |

### After

All 19 configs now have bmc + prove + cover = **57 tasks**.

### Cover Properties Added

Each decoder's SV file received 4 cover properties exercising boundary values:

| Decoder | Cover Values |
|---|---|
| bf16 | +0.0, +1.0, +Inf, NaN |
| tf32 | +0.0, +1.0, +Inf, NaN |
| fp8_e5m2 | +0.0, +Inf, NaN, smallest subnormal |
| fp8_e4m3_fnuz | zero, NaN (0x80), max positive, smallest subnormal |
| mxfp8_e4m3 | +0.0, +NaN, max finite, smallest subnormal |
| fp6_e3m2 | +0.0, max positive, -0.0, smallest subnormal |
| fp6_e2m3 | +0.0, max positive, -0.0, smallest subnormal |
| int8 | zero, +127, -128, -1 |
| e8m0 | 2^(-127) subnormal, 2^0, 2^127 max, NaN |
| mxint8 | zero, +1.0, max (+127/64), reserved NaN |
| posit8 | zero, +1.0, maxpos (+64), NaR |
| lns8 | zero, smallest positive, max positive, negative zero |
| bcd | 0, 42, 99 (max valid), 0xAA (invalid) |

## GDS Status

```
GDS #26777356494:  IN PROGRESS (FP_PDN_SKIPTRIM + DESIGN_IS_CORE + cocotb fix)
GDS #26777447929:  IN PROGRESS (Loop 52 report push, same config)
GDS #26777654110:  IN PROGRESS (formal cover push, same config)
```

### Precheck Fix Chain

| Fix | Variable | Addresses |
|-----|---|---|
| Metal5 suppression | RT_MAX_LAYER=Metal4 | Was already clean (0 polygons) |
| Macro mode PDN | DESIGN_IS_CORE=false | Correct PDN generation mode |
| Power pin trimming | FP_PDN_SKIPTRIM=true | **NEW** — prevents 15.38 um gap |
| GL test API | .value.integer | **NEW** — cocotb 1.8 compatibility |

## Weakness Audit Results

| Finding | Severity | Status |
|---|---|---|
| 13 .sby configs lacked cover tasks | MEDIUM | **FIXED** — 57 tasks total |
| GDS power pin trimming | CRITICAL | Fix deployed, awaiting result |
| GL test cocotb API | CRITICAL | Fixed in Loop 52 |
| Metal5 in GDS | NONE | Was always clean |

## Verification Status

```
Verilator lint:        PASS (0 warnings)
Yosys synthesis:       PASS (2,308 cells, unchanged)
Formal (sby):          19 configs, 57 tasks (bmc+prove+cover complete)
Cocotb:                PASS (44 tests)
GitHub CI:             PASS (all green)
GitHub GDS:            IN PROGRESS (#26777356494 -- critical FP_PDN_SKIPTRIM run)
```

## Metrics

- Formal cover properties added: 52 (4 per decoder × 13 decoders)
- Formal task count: 57 (was 44, +13 cover tasks)
- RTL changes: 0
- Synthesis: 2,308 cells (unchanged)
- CI status: all green
- Days to deadline: 20

---

## Three Collaboration Options for Next Loop

### Option A: Validate FP_PDN_SKIPTRIM GDS + Precheck Result

GDS run #26777356494 is the single most important pending result. If precheck passes (power pins within 10 um) AND GL tests pass (cocotb .value.integer fix), this clears the critical path to submission with 20 days to spare. If it fails: analyze the specific failure. If power pins still fail despite skip-trim, create a custom PDN TCL via PDN_CFG that explicitly places Metal4 stripes from y=0 to y=736.96. If GL tests fail with a new error, it's likely a timing issue in gate-level simulation (add `SDF_DELAY_TYPE=max` or increase test clock period).

### Option B: Add NVFP4 + AMXFP4 to ROM Catalog

NVFP4 (E2M1 + E4M3 scale, group=16) and AMXFP4 (asymmetric scales) are the two most important missing formats based on 2026 research. Add as ROM records 80-81, regenerate format_rom.v, add formal verification configs (bmc+prove+cover) and cocotb test vectors. This is the highest-value feature addition that doesn't touch the GDS-critical path (ROM is already synthesized, adding entries only affects ROM contents).

### Option C: Post-Silicon Test Framework + ISCA 2026 Prep

Two parallel tracks: (1) Create tt-commander Python test framework for post-silicon validation via RP2040 MUX serial interface. Same protocol, same golden values as cocotb tests, but targeting physical hardware. (2) Prepare a comparison table of Corona's 80-format catalog against formats mentioned in ISCA 2026 papers (June 27), identifying which conference papers validate which catalog entries. This positions the project for a post-tapeout publication.
