gHashTag/tt-trinity-corona/docs/REPORT_2026-06-02_loop51.md

# Loop 51 Report -- 2026-06-02

## Summary

**Fixed PDN config: replaced unrecognized FP_PDN_MULTILAYER with DESIGN_IS_CORE=false.** Research confirmed `FP_PDN_MULTILAYER` is an OpenLane 1 variable not recognized by LibreLane. The correct approach is `DESIGN_IS_CORE: false` which tells LibreLane this tile is a macro (not standalone core), suppressing Metal5 PDN generation. Updated stale PLAN.md metadata (repo status, submission date, silicon delivery). CI remains 6/6 green.

## Critical PDN Fix

### Problem Chain

1. LibreLane default: DESIGN_IS_CORE=true -> generates full PDN with Metal5 straps
2. TT precheck: Metal5 strictly forbidden for user tiles (reserved for TT integration)
3. Loop 50 fix: `FP_PDN_MULTILAYER: false` -> OpenLane 1 variable, **silently ignored** by LibreLane

### Solution

`DESIGN_IS_CORE: false` in config.json tells LibreLane this is a macro, not a standalone core. In macro mode, LibreLane generates only lower-metal PDN (Metal1 stdcell rails) and relies on the parent design (TT integration) for top-level power distribution via Metal5.

### Updated `src/config.json`

```json
{
  "CLOCK_PERIOD": 40,
  "CLOCK_PORT": "clk",
  "BASE_SDC_FILE": "dir::constraint.sdc",
  "FP_SIZING": "absolute",
  "DIE_AREA": "0 0 1440.32 736.96",
  "RT_MAX_LAYER": "Metal4",
  "DESIGN_IS_CORE": false
}
```

## PLAN.md Updates

| Field | Before | After |
|---|---|---|
| Project repo | "proposed" | active |
| Target submission | "2026 Q4 (approximate)" | 2026-06-22 |
| Silicon delivery | "early 2027" | 2026-10-01 |
| Document status | "paper-design, pre-repo-creation" | "post-Phase-C, GDS iteration" |
| Repo status | "NOT yet created" | "active with 18 RTL modules, 44 formal tasks" |

## Research Findings

### LibreLane Variable Migration

- `FP_PDN_MULTILAYER` -> **no direct replacement** in LibreLane. Behavior is now structural via DESIGN_IS_CORE and PDN configuration method
- `BASE_SDC_FILE` -> **should work** in LibreLane's Classic flow (backwards-compatible)
- `DESIGN_IS_CORE` -> sets macro vs core PDN generation mode

### TT GF180MCU Projects That Pass Precheck

- wafer-space/gf180mcu-project-template uses `PDN_SKIPTRIM: true` and LibreLane `leo/gf180mcu` branch
- Cloneless1 (tamper-resistant crypto ASIC) successfully submitted to wafer.space GF180MCU Run 1
- TT GF 0p2 shuttle closed Nov 2025 with 52 designs, wafers received April 2026

### Quantization-Aware Training for FP4/MXFP4 (2026)

| Paper | Finding |
|---|---|
| Quartet (ICLR 2026) | First native MXFP4 training -- all matmuls in MXFP4 |
| NVIDIA QAD (Mar 2026) | Quantization-aware distillation for NVFP4, block-size-16 |
| FP4 All the Way (2025) | Fully quantized FP4 training with E3M4/E4M3 scale |
| TetraJet (Feb 2025) | Oscillation-reduced MXFP4 training for ViTs |

Oracle implication: block-size-16 variants (NVFP4) and block-size-32 (MXFP4) are both production-critical. Both should be in the ROM catalog.

### Custom PDN via TCL

If DESIGN_IS_CORE=false doesn't work, the fallback is a custom PDN TCL script referenced via `PDN_CFG`:
```tcl
add_pdn_stripe -grid core -layer Metal4 -width 1.6 -pitch 56.0 -offset 28.0
add_pdn_connect -grid core -layers {Metal1 Metal4}
```

## Weakness Audit Results

| Finding | Severity | Status |
|---|---|---|
| FP_PDN_MULTILAYER unrecognized | CRITICAL | **FIXED** -- replaced with DESIGN_IS_CORE=false |
| PLAN.md stale metadata | MEDIUM | **FIXED** -- updated header and status |
| Cocotb Makefile | NONE | All 3 test files correctly listed |
| ROM golden test | NONE | All 80 records verified with 800 assertions |
| CLAIM_STATUS.md | NONE | Current and consistent |

## GDS Status

```
GDS #26775787496:  IN PROGRESS (SDC + FP_PDN_MULTILAYER=false, will be ignored)
GDS next push:     QUEUED (SDC + DESIGN_IS_CORE=false, the real fix)
```

## Verification Status

```
Verilator lint:        PASS (0 warnings)
Icarus compile:        PASS
Yosys synthesis:       PASS (2,308 cells, unchanged)
Formal (sby):          PASS (19 configs, 44 tasks)
Cocotb:                PASS (44 tests)
GitHub CI:             PASS (6/6 green)
GitHub GDS:            IN PROGRESS (two runs: old PDN fix + new DESIGN_IS_CORE fix)
```

## Metrics

- Config fix: DESIGN_IS_CORE=false (replaces unrecognized FP_PDN_MULTILAYER)
- PLAN.md lines updated: 3 (header, status, repo existence)
- RTL changes: 0
- Synthesis: 2,308 cells (unchanged)
- CI status: 6/6 GREEN
- Days to deadline: 20

---

## Three Collaboration Options for Next Loop

### Option A: Validate DESIGN_IS_CORE=false GDS Result

The GDS run with `DESIGN_IS_CORE=false` is the most promising precheck fix yet -- it correctly tells LibreLane to skip Metal5 PDN. Once results are in: if precheck passes, the critical blocker is resolved and we can focus on submission. If it fails with a different error, analyze the failure and try the custom PDN TCL fallback or contact TT team. This is the single highest-priority item with 20 days to deadline.

### Option B: Add NVFP4 + MXFP4 to ROM + Quartet Test Vectors

Research confirms NVFP4 (block-16, E2M1+FP8 scale) and MXFP4 (block-32, E2M1+E8M0 scale) as the two most important missing formats. Quartet (ICLR 2026) proved native MXFP4 training works. Add both as ROM records 80-81, regenerate format_rom.v, update all tests. Also create test vectors derived from Quartet's accuracy benchmarks for our cocotb suite.

### Option C: Post-Silicon Prep + tt-commander Test Script

Silicon expected ~2026-10-01. Create a tt-commander Python test framework that exercises all 80 ROM entries and 18 decoders through the RP2040 MUX serial interface. Include golden expected values for every test vector. This script runs identically in cocotb simulation and on physical hardware, enabling direct simulation-to-silicon correlation. Can proceed independently of the GDS precheck blocker.
