gHashTag/tt-trinity-corona/docs/REPORT_2026-06-02_loop49.md

# Loop 49 Report -- 2026-06-02

## Summary

**Formal prove coverage expanded from 1/19 to 19/19 configs.** Added `prove` task to all 18 decoder .sby files + ROM. Added 5 boundary/edge-case cocotb tests (NOT_IMPL sentinel, out-of-range fmt_ids, consecutive ROM readbacks). Research confirmed Metal5 PDN is inherent to GF180MCU 4x4 tiles -- no workaround, must be resolved with TT team. Synthesis unchanged at 2,308 cells.

## Formal Verification Expansion

### Before Loop 49

| Config | Tasks |
|---|---|
| fv_fsm | bmc, prove, cover |
| fv_fp4, fv_bitnet, fv_int4, fv_nf4, fv_rom | bmc, cover |
| 13 decoders | bmc only |
| **Total** | **26 tasks (1 prove)** |

### After Loop 49

| Config | Tasks |
|---|---|
| fv_fsm | bmc, prove, cover |
| fv_fp4, fv_bitnet, fv_int4, fv_nf4, fv_rom | bmc, prove, cover |
| 13 decoders | bmc, prove |
| **Total** | **44 tasks (19 prove)** |

All 18 decoder properties use `(* anyconst *)` with combinational `always @(*)` -- prove at depth 1 is mathematically equivalent to exhaustive verification over all inputs. ROM prove uses depth 5 (registered output needs clock cycles).

## New Cocotb Tests

Added 5 boundary tests to `test/test_stress.py`:

| Test | What it checks |
|---|---|
| `test_not_impl_response` | 7 fmt_ids without decoders (5,6,7,15,20,50,60) return NOT_IMPL sentinel |
| `test_out_of_range_decode` | fmt_id > 79 (80, 100, 126) returns NOT_IMPL gracefully |
| `test_rom_out_of_range` | ROM readback for fmt_id=100 returns all zeros (ROM default case) |
| `test_consecutive_rom_readbacks` | 3 ROM reads in a row without reset, data consistent |
| `test_last_valid_rom_entry` | ROM[79] (MXINT8) valid, decode still works after |

NOT_IMPL sentinel format: `{0x4E, 0x07, fmt_id, 0xFF}` (byte3='N', byte2=SPEC, byte1=fmt_id, byte0=0xFF).

## Research Findings

### GF180MCU Metal5 PDN (Critical Path)

- Known OpenLane issue #1549: PDN places via3 grids violating V3.2a spacing rules
- For TT GF tiles, the top-level integration owns Metal5 -- tiles must NOT use Metal5 for signals
- Our tile uses RT_MAX_LAYER=Metal4 for signal routing, but LibreLane PDN still places Metal5 power straps on 4x4 dies
- Previous attempts: FP_PDN_UPPER_LAYER=Metal4 (PDN-0003), Metal3/Metal4 PDN (PDN-0179)
- Research suggested `FP_PDN_MULTILAYER=0` but this would eliminate the power grid entirely
- wafer.space LibreLane template may have a working PDN config -- needs investigation
- **Conclusion**: This is a TT GF180MCU toolchain limitation, needs to be raised with TT team

### Post-Silicon Testing

- **tt-commander**: Web Serial API tool + Python SDK for scripted testing via RP2040 MUX controller
- For Corona ROM: script input vectors via ui_in, read uo_out, compare against golden values
- **Spacely** (Fermilab): mixed-signal framework, overkill for digital TT tiles

### D2D Between TT Tiles

- **Not feasible**: TT MUX only allows one tile active at a time, no direct tile-to-tile communication
- D2D between separate TT chips requires external wiring through demo board I/O pins
- Corona's D2D-to-Gamma plan needs external board, not on-chip routing

### Mixed-Signal on GF180MCU

- wafer.space GF180MCU Run 1: fabricated opamps, 14-bit SAR ADC, capacitive DAC (OpenFASoC)
- TT GF 0.2 has analog pin support with vertical met4 stripes for power

## Weakness Audit Results

| Finding | Severity | Status |
|---|---|---|
| GDS precheck Metal5 | Medium | External -- TT toolchain |
| Formal prove coverage < 10% | Medium | FIXED (now 100%) |
| Missing boundary tests | Medium | FIXED (5 tests added) |
| No FSM watchdog/timeout | Low | By design -- host controls pace |
| ROM phi-distance not formally checked | Low | Deferred (gen_rom.py validates) |

## GDS Status

```
GDS #26774201570:  HARDENED OK, precheck FAIL (Metal5 power pins)
GDS #26774297695:  STILL IN PROGRESS (queued >5h)
```

Both runs use the working config: FP_SIZING=absolute, DIE_AREA=0 0 1440.32 736.96, RT_MAX_LAYER=Metal4.

## Verification Status

```
Verilator lint:        PASS (0 warnings)
Icarus compile:        PASS
Yosys synthesis:       PASS (2,308 cells, unchanged)
GLS smoke test:        PASS (76/76 -- CI green)
ROM golden:            PASS (80/80 -- CI green)
Formal (sby):          PASS (19 configs, 44 tasks -- CI pending new push)
Cocotb:                PASS (44 tests -- CI pending new push)
GitHub CI:             PASS (6/6 green, latest: #26774297743)
GitHub GDS:            HARDENED OK, precheck FAIL (Metal5 -- known)
```

## Metrics

- Formal prove tasks added: 18 (0% to 100% prove coverage)
- Cocotb tests added: 5 (39 to 44 total)
- RTL changes: 0 (test and verification only)
- Synthesis: 2,308 cells (unchanged, 14% of 4x4 budget)
- CI status: 6/6 GREEN
- Days to deadline: 20

---

## Three Collaboration Options for Next Loop

### Option A: Resolve GDS Precheck with TT Team

The Metal5 PDN precheck failure is the only remaining blocker for tapeout submission. Two paths: (1) File a GitHub issue on the tt-gds-action repo explaining the contradiction -- GF180MCU 4x4 tiles require Metal5 for PDN but precheck rejects it. Reference OpenLane issue #1549. (2) Check wafer.space LibreLane template for a working GF180MCU PDN config that avoids Metal5. If neither works, ask on TT Discord whether other GF180MCU projects have the same issue and how they resolved it. This is the critical path -- without precheck passing, submission cannot proceed.

### Option B: Add NVFP4 + MXFP4 to ROM Catalog

Loop 48 research identified NVFP4 (NVIDIA Blackwell E2M1+FP8 scale, block=16) and MXFP4 (OCP MX E2M1+block scale, block=32) as high-priority new formats. Both are now production-deployed. Add them as records 80-81 via `tools/gen_rom.py`, update the SSOT t27 spec, regenerate format_rom.v, and update all tests (GLS golden for 82 records, formal ROM golden, cocotb ROM readback). This grows the catalog but does not change cell count (ROM is address-decoded). The formal prove tasks added this loop will automatically cover the expanded ROM.

### Option C: Post-Silicon Test Framework + SDC Timing

Prepare for silicon arrival (expected May 2026): (1) Create a tt-commander Python test script that exercises all 80 ROM entries and 18 decoders through the serial protocol, comparing against golden expected values. (2) Set up dual-SDC timing flow (pnr.sdc with 10% over-constraint, signoff.sdc at 25 MHz nominal) for proper timing closure. (3) Download the GDS artifact from the passing hardening run and inspect in KLayout for area/routing quality. This is the gold-standard pre-silicon preparation path and can proceed independently of the precheck blocker.
