gHashTag/tt-trinity-corona/docs/REPORT_2026-06-02_loop42.md

# Loop 42 Report — 2026-06-02

## Summary

Expanded GLS smoke test from 21 to 42 tests, adding comprehensive edge-case coverage: sign extension (INT4/INT8 negative values), NaN/Inf/subnormal paths (FP8 E5M2, E8M0, BF16, FNUZ, MXINT8), zero-value tests, and format alias verification. Fixed a BF16 NaN test vector bug caught during development. All 42 tests pass on synthesized netlist (2,308 cells, unchanged).

## Changes

### 1. Edge-Case / Boundary GLS Tests

**File:** `test/tb_gls_smoke.v` — 21 new tests added (tests 21-42):

**Sign Extension (tests 21-24):**
| Test | Input | Expected | What it verifies |
|---|---|---|---|
| INT4 -8 | 0x08 | 0xFFFFFFF8 | 28-bit MSB replication through synthesis |
| INT4 -1 | 0x0F | 0xFFFFFFFF | All-ones sign extension |
| INT8 -128 | 0x80 | 0xFFFFFF80 | 24-bit MSB replication |
| INT8 -1 | 0xFF | 0xFFFFFFFF | All-ones through 8-bit path |

**NaN / Inf / Special Values (tests 25-38):**
| Test | Input | Expected | What it verifies |
|---|---|---|---|
| BitNet -1 | 0x02 | 0xBF800000 | Ternary sign bit → FP32 sign |
| BitNet NaN | 0x03 | 0x7FC00000 | Reserved ternary → qNaN |
| NF4 -1.0 | 0x00 | 0xBF800000 | LUT index 0 boundary |
| NF4 zero | 0x07 | 0x00000000 | Mid-LUT zero |
| FP8 E5M2 +Inf | 0x7C | 0x7F800000 | Infinity classification |
| FP8 E5M2 NaN | 0xFF | 0xFFC00000 | Negative qNaN with sign preservation |
| FP8 E5M2 subnormal | 0x01 | 0x37800000 | Subnormal normalization shift |
| E8M0 NaN | 0xFF | 0x7FC00000 | All-ones → qNaN constant |
| E8M0 min | 0x00 | 0x00400000 | 2^(-127) FP32 subnormal encoding |
| MXINT8 NaN | 0x80 | 0x7FC00000 | Reserved -128 → qNaN |
| MXINT8 zero | 0x00 | 0x00000000 | Zero flag logic |
| BF16 NaN | 0x7FC0 | 0x7FC00000 | 2-byte NaN wiring |
| FNUZ NaN | 0x80 | 0x7FC00000 | **Sign override** — input sign=1 but output forced positive |
| MXINT8 -1 | 0xFF | 0xBC800000 | Two's complement + leading-one encoder |

**Alias Verification (tests 39-41):**
| Test | fmt_ids | Verifies |
|---|---|---|
| alias 11=39 | FP8 E4M3 / MXFP8 | Same decode_result wire |
| alias 13=41 | FP4 ML / FP4 MX | Same decode_result wire |
| alias 75=70 | NF4 BnB / NF4 QLoRA | Same decode_result wire |

### 2. Bug Fix: BF16 NaN Test Vector

The initial BF16 NaN test had incorrect expected status bytes — byte[1] was 0xC0 instead of 0x00 (LSB-first byte ordering error). Fixed before first successful run.

### 3. Research Findings

**YosysHQ EQY:** Formal RTL-vs-netlist equivalence checker, usable but not production-certified. A 2025 Cornell paper warns EQY bugs can manifest as missed design bugs — use as supplement to GLS, not replacement.

**TTGF26a submission:** No standalone checklist document. Effective validation is passing GDS Action + Docs Action in GitHub. Submit via app.tinytapeout.com with `--gf` flag. Common failures: wrong PDK variable, DRC/LVS errors.

**GF180MCU timing:** 180nm node, 25-40 MHz achievable for decoder-class designs. OpenLane2 handles hold repair automatically.

**Coverage assessment:** 100% decoder GLS + formal BMC + exhaustive cocotb is stronger than typical TT submissions, which usually only run cocotb. Bounded formal proofs are considered acceptable for sign-off when bounds exceed design state depth (DVCon 2025 paper).

**MXDOTP/Vmxdotp:** RISC-V ISA extensions for OCP MX dot products define FP9 (E5M3) as intermediate accumulation format — potential future catalog addition.

## Verification Status

```
Verilator lint:        PASS (0 warnings)
Icarus compile:        PASS
Yosys synthesis:       PASS (2,308 cells, unchanged)
GLS smoke test:        PASS (42/42 tests)
  - Positive values:   19/19 (all 18 decoders + NOT_IMPL)
  - Edge cases:        18/18 (NaN, Inf, subnormal, negative, zero)
  - Aliases:           3/3
  - Infrastructure:    2/2 (ROM readback, reset recovery)
Formal (sby):          Pending CI (19 configs)
Cocotb:                27/27 PASS
```

## Metrics

- GLS test count: 21 → 42 (2× increase)
- Edge-case categories covered: sign extension, NaN, Inf, subnormal, zero, reserved, alias, NOT_IMPL
- Synthesis-critical paths verified: INT sign replication, FP subnormal normalization, FNUZ sign override, MXINT8 leading-one encoder
- Total commits: 50 → 51
- Days to deadline: 20

---

## Three Collaboration Options for Next Loop

### Option A: Push to GitHub (Critical Path)
51 commits unpushed. CI and remote backup blocked. `git remote set-url origin https://<TOKEN>@github.com/gHashTag/tt-trinity-corona.git && git push -u origin main`. **20 days to deadline — every day without CI is risk.**

### Option B: EQY Formal Equivalence Setup
Install YosysHQ EQY and configure RTL-vs-netlist equivalence proofs for all 18 decoders. This provides mathematical proof that synthesis preserved functional correctness — stronger than any number of GLS test vectors. Approximately 1-2 hours to set up and run.

### Option C: CI Pipeline + GDS Hardening Dry Run
Create `.github/workflows/gds.yaml` with the TT GDS Action targeting GF180MCU. Run local hardening with OpenLane2/LibreLane to catch DRC/LVS issues before the June 22 deadline. This is the direct path to submission readiness.
