gHashTag/tt-trinity-corona/docs/REPORT_2026-06-01_loop40.md

# Loop 40 Report — 2026-06-01

## Summary

Expanded GLS smoke test from 5 to 12 tests, covering 9 unique decoder modules + ROM readback + anchor + reset-recovery. Introduced a reusable `decode_1byte` task to eliminate protocol boilerplate. GLS decoder coverage: 3/18 → 9/18 (3× increase). All 12 tests pass on synthesized netlist (2,308 cells, unchanged).

## Changes

### 1. GLS Smoke Test — Major Expansion

**File:** `test/tb_gls_smoke.v`

Added `decode_1byte` reusable task (CMD1→CMD2→DATA→STATUS→DONE→IDLE in one call) and 7 new tests:

| # | Test | fmt_id | Input | Expected FP32 | Status |
|---|---|---|---|---|---|
| 1 | Anchor probe | — | 0x7F | 0x47C0 | PASS |
| 2 | BF16 +1.0 | 8 | 0x3F80 | 0x3F800000 | PASS |
| 3 | Posit8 +1.0 | 31 | 0x40 | 0x3F800000 | PASS |
| 4 | FP4 E2M1 +1.0 | 41 | 0x02 | 0x3F800000 | PASS |
| 5 | NF4 +1.0 | 70 | 0x0F | 0x3F800000 | PASS (new) |
| 6 | BitNet +1 | 71 | 0x01 | 0x3F800000 | PASS (new) |
| 7 | INT4 +1 | 46 | 0x01 | 0x00000001 | PASS (new) |
| 8 | FP8 E5M2 +1.0 | 10 | 0x3C | 0x3F800000 | PASS (new) |
| 9 | E8M0 2^0 | 78 | 0x7F | 0x3F800000 | PASS (new) |
| 10 | MXINT8 +1.0 | 79 | 0x40 | 0x3F800000 | PASS (new) |
| 11 | ROM readback | 8 | — | non-zero | PASS (new) |
| 12 | Reset re-entry | — | mid-CMD | anchor | PASS |

Format families now covered by GLS:
- **Float**: BF16, FP8 E5M2, FP4 E2M1
- **Posit**: Posit8
- **Exponent-only**: E8M0
- **Quantization LUT**: NF4
- **Ternary**: BitNet 1.58b
- **Integer**: INT4, MXINT8
- **ROM**: Readback protocol

### 2. Research Findings

**IEEE P3109 status (Jun 2026):** Interim Report v3.0 (Aug 2025) introduced systematic `binaryKpP` naming. Exponent bias reversed back to 2^(w-1) in Jul 2025. Still unratified — our catalog aligns with interim naming but should flag as draft-compliant.

**FLoPS (Feb 2026):** Machine-checked Lean formalization of P3109 minifloat family. Directly usable as golden reference for test vector generation — could supplement our SymbiYosys formal proofs with independent specification checking.

**MX v1.0 still current:** No OCP MX v2 published. NVIDIA NVFP4 (dual-level FP8+FP32 scaling) and MX+ (near-FP8 quality at 4.25 bits/element) are vendor extensions. Our MX format catalog covers the canonical set.

**Posit silicon efficiency:** May 2025 paper shows 47.9% LUT reduction for posit codecs in RISC-V — validates that our posit8 decoder is silicon-efficient at this technology node.

**SymbiYosys RTL equivalence:** StarVLSI (May 2026) documents a complete open-source RTL equivalence checking flow with SymbiYosys — viable for pre-vs-post-synthesis equivalence if needed.

### 3. Weakness Analysis Results

| Category | Status |
|---|---|
| **Critical blockers** | None |
| **Formal proofs** | 19/19 .sby configs, all decoders covered |
| **GLS coverage** | 9/18 unique decoders (was 3/18) |
| **Cocotb tests** | 27 tests, all PASS |
| **Lint** | Verilator 0 warnings, Icarus clean |
| **Synthesis** | 2,308 cells (~14% of 4×4 budget) |
| **TT submission** | info.yaml valid, docs/info.md exists, CI workflows present |

Remaining GLS gaps: TF32, FP6 E3M2, FP6 E2M3, FP8 E4M3 FNUZ, MXFP8 E4M3, LNS8, INT8, BCD, FP4 ML alias (9 decoders, 6 unique modules).

## Verification Status

```
Verilator lint:        PASS (0 warnings)
Icarus compile:        PASS
Yosys synthesis:       PASS (2,308 cells, unchanged)
GLS smoke test:        PASS (12/12 tests)
Formal (sby):          Pending CI (19 configs)
Cocotb:                27/27 PASS (prior loop)
```

## Metrics

- GLS test count: 5 → 12
- Unique decoder GLS coverage: 3/18 → 9/18
- Format families with GLS: 2 → 9 (float, posit, exponent, quant-LUT, ternary, integer, ROM)
- Total commits: 48 → 49 (after this commit)
- Days to deadline: 21

---

## Three Collaboration Options for Next Loop

### Option A: Push to GitHub (User Action Required)
Generate a GitHub PAT and push. **49 commits unpushed. CI, formal proofs, and GDS hardening are all blocked.** This is the critical path — every loop of work is at risk until it's backed up remotely.

### Option B: Complete GLS Coverage (9 → 18 Decoders)
Add the remaining 9 decoder tests: TF32 (3-byte), FP6 E3M2, FP6 E2M3, FP8 E4M3 FNUZ, MXFP8 E4M3, LNS8, INT8, BCD, plus alias verification (FP4 ML, NF4 BNB). Achieves 100% Tier-1 GLS coverage. TF32 is the most interesting — it's the only 3-byte format and exercises the data buffer's multi-byte shift path through synthesis.

### Option C: Not-Implemented Sentinel Test + Boundary Stress
Test the `NOT_IMPL` sentinel for an unsupported fmt_id (e.g., fmt_id=1 should return `[0xFF, 0x01, 0x07, 0x4E]`). Add boundary tests: max fmt_id (127), zero-value inputs to each decoder, negative-value tests for signed formats (INT4 -8, BitNet -1, NF4 -1.0). This stress-tests the FSM's error path and catches sign-extension bugs in synthesized gates.
