gHashTag/tt-trinity-corona/docs/REPORT_2026-06-01_loop39.md

# Loop 39 Report — 2026-06-01

## Summary

Expanded GLS smoke test from 2 tests to 5 tests covering anchor probe, BF16 decode, posit8 decode, FP4 decode, and reset re-entry. Fixed an FSM inter-test timing bug (DONE→IDLE requires 2 clock cycles, not 1). Added missing Makefile targets (`verilator-lint`, `formal`, `gls`, updated `all`). All 5 GLS tests pass; synthesis at 2,308 cells (unchanged).

## Changes

### 1. GLS Smoke Test Expansion

**File:** `test/tb_gls_smoke.v`

Added 3 new gate-level simulation tests:

| Test | Format | Input | Expected FP32 | Status |
|---|---|---|---|---|
| 1 | Anchor probe | 0x7F | 0x47C0 | PASS |
| 2 | BF16 +1.0 | 0x3F80 | 0x3F800000 | PASS |
| 3 | Posit8 +1.0 | 0x40 | 0x3F800000 | PASS (new) |
| 4 | FP4 E2M1 +1.0 | 0x02 | 0x3F800000 | PASS (new) |
| 5 | Reset re-entry | mid-CMD reset | anchor probe | PASS (new) |

**Bug found and fixed:** The FSM state machine transitions STATUS→DONE→IDLE in 2 clock cycles. The testbench originally had only 1 "DONE cycle" between tests, causing the next CMD1 to arrive while the FSM was still in DONE state. Added an extra `@(posedge clk); #1;` between each test sequence.

### 2. Makefile Improvements

**File:** `Makefile`

| Target | Description |
|---|---|
| `verilator-lint` | Zero-warning Verilator lint with `-Wall` |
| `formal` | Delegates to `formal/` directory SymbiYosys configs |
| `gls` | Full GLS flow: Yosys synth → iverilog + simcells → vvp → grep ALL PASS |
| `all` | Now runs both `lint` and `verilator-lint` |

### 3. Research Findings

**FSM DONE-state timing**: The 2-cycle STATUS→DONE→IDLE transition is inherent to the FSM design — DONE is a separate state that clears output registers before returning to IDLE. This is standard practice to prevent output glitches between transactions.

**GLS as synthesis canary**: Gate-level simulation catches technology mapping bugs that RTL simulation and formal verification miss. The FP4 and posit8 tests exercise the full CMD/DATA/STATUS protocol path through synthesized gates, verifying that Yosys `synth -flatten` preserves functional correctness for these decoders.

**Posit8 GLS value**: The posit8 decoder is the most complex Tier-1 converter (256-entry LUT, regime/exponent/fraction extraction). Its GLS test validates that the synthesis tool correctly maps the case statement through ABC optimization.

## Verification Status

```
Verilator lint:        PASS (0 warnings)
Icarus compile:        PASS
Yosys synthesis:       PASS (2,308 cells, unchanged)
GLS smoke test:        PASS (5/5 tests)
Formal (sby):          Pending CI (19 configs)
```

## Metrics

- GLS test count: 2 → 5
- Decoder GLS coverage: 1 (BF16) → 3 (BF16, posit8, FP4)
- Makefile targets: 3 → 6
- Total commits: 47 → 48 (after this commit)
- Days to deadline: 21

---

## Three Collaboration Options for Next Loop

### Option A: Push to GitHub (User Action Required)
Generate a GitHub PAT and run: `git remote set-url origin https://<TOKEN>@github.com/gHashTag/tt-trinity-corona.git && git push -u origin main`. **48 commits are unpushed. This is the critical path — CI, formal proofs, and GDS hardening are all blocked on this.**

### Option B: Expand GLS Coverage to All Tier-1 Decoders
Add GLS tests for the remaining decoders: NF4, BitNet, INT4, MXInt8, FP8 E4M3/E5M2. This would give 100% Tier-1 decoder GLS coverage (currently 3/18). Each test follows the same CMD/DATA/STATUS pattern — straightforward to add.

### Option C: Formal FSM Protocol Verification
The current `fv_fsm.sby` proves basic state transitions, but doesn't verify the full CMD1→CMD2→DATA→STATUS→DONE→IDLE protocol with realistic payloads. Add protocol-level cover() properties and assertions to formally prove that every supported fmt_id produces correct output bytes in the STATUS state. This would catch bugs like the DONE-state timing issue at the proof level.
