gHashTag/tt-trinity-corona/docs/REPORT_2026-06-01_loop31.md

# Loop 31 Report — 2026-06-01

## Summary

Found and fixed the first actual RTL bug via systematic audit: **LNS8 antilog LUT rounding errors** in 4 of 16 entries. Added FSM cover points proving all 5 states reachable from reset. All verification passes: 19/19 formal proofs, 8/8 cover points, 39/39 cocotb tests, 0 Verilator warnings.

## Critical Fix: LNS8 Antilog LUT

### Bug Description

The LNS8 decoder's 16-entry lookup table (`2^(frac/16) × 256`, rounded) had incorrect values at indices 3, 5, 6, and 7:

| Index | Wrong | Correct | Error | Root Cause |
|---|---|---|---|---|
| 3 | 291 | 292 | −1 | floor instead of round |
| 5 | 317 | 318 | −1 | floor instead of round |
| 6 | 331 | 332 | −1 | floor instead of round |
| 7 | 345 | 347 | −2 | neither floor nor round |

### Why It Was Masked

The same wrong values appeared in all three reference sources:
- `src/rtl/lns8_decode.v` (RTL)
- `formal/fv_lns8.sv` (formal golden model)
- `test/test_decoders.py` (cocotb reference)

All three agreed, so every test passed despite the bug. The error was found by recomputing `round(256 × 2^(i/16))` from first principles.

### Impact

Maximum error of 2/256 ≈ 0.78% at index 7. For a conformance oracle this matters — downstream consumers trusting the decode output would accumulate the error.

### Fix

Three files corrected simultaneously:
- `src/rtl/lns8_decode.v` — entries 3→292, 5→318, 6→332, 7→347
- `formal/fv_lns8.sv` — golden LUT updated
- `test/test_decoders.py` — `ref_lns8()` LUT updated

## FSM Cover Points

Added 8 `cover()` statements to the formal verification block proving reachability from reset:

| Cover | Description | Steps |
|---|---|---|
| C1 | IDLE state | 2 |
| C2 | CMD2 state | 3 |
| C3 | DATA state | 4 |
| C4 | STATUS state | 6 |
| C5 | DONE state | 7 |
| C6 | Anchor mode active | 2 |
| C7 | data_cnt reaches max (15) | 19 |
| C8 | data_cnt == 0 in DATA (last byte) | 5 |

All 8 cover points reached by the solver, confirming no dead states in the FSM.

## Research Findings

### Zero-Delay Gate-Level Simulation
Yosys can synthesize to generic cells (`synth -top ... -flatten`), then Icarus simulates with `simcells.v` providing behavioral models. This gives a zero-cost GLS flow without needing PDK timing models — useful for catching synthesis mismatches.

### SymbiYosys Cover Mode
Cover mode uses the SAT/SMT solver in reverse: instead of proving no counterexample exists, it finds input sequences that reach each `cover()` point. This proves reachability — a property BMC and k-induction cannot establish.

### TT Submission Checklist (TTGF26a)
1. Push to GitHub (currently blocked — 38 commits unpushed)
2. GDS hardening via GitHub Actions
3. Purchase tile at app.tinytapeout.com
4. Deadline: 2026-06-22 (21 days remaining)

## Verification Status

```
Formal proofs:   19/19 PASS (17 decoders + FSM + ROM)
Cover points:     8/8  REACHED
Cocotb tests:    39/39 PASS
Verilator lint:   0 warnings
```

## Metrics

- Commits this session: 1 (pending)
- Properties proven: 12 (P1-P12) + 7 auxiliary invariants + 8 cover points + 4 ROM properties
- RTL bugs found and fixed: 1 (LNS8 LUT)
- Days to deadline: 21

---

## Three Collaboration Options for Next Loop

### Option A: Gate-Level Simulation Pipeline
Set up zero-delay GLS using Yosys generic cells + Icarus. Synthesize `tt_um_trinity_corona`, run cocotb tests against the gate-level netlist, and compare outputs with RTL simulation. This catches synthesis mismatches that formal verification cannot — different abstraction level entirely.

### Option B: Remaining Decoder Audit (BF16, TF32, Posit8)
Apply the same first-principles LUT recomputation that caught the LNS8 bug to the other LUT-based decoders: `posit8_decode` (16-entry regime LUT), `nf4_decode` (16-entry quantile LUT), and `bcd_decode` (BCD nibble conversion). If LNS8 had 4 wrong entries, others likely have similar issues.

### Option C: Push + GDS Hardening
Resolve the GitHub authentication blocker (`gh auth login`), push all 38+ commits, trigger the TT GDS hardening action, and validate the synthesis report (cell count vs. 4×4 tile budget of ~16,000 cells). This is the critical path to the June 22 deadline.
