gHashTag/tt-trinity-corona/docs/REPORT_2026-06-01_loop21.md

# Loop 21 Report — 2026-06-01

## Summary

Hardened CI pipeline: added Verilator lint job (zero-warning gate), pinned
cocotb==2.0.1, added source-file consistency check that validates info.yaml
matches actual RTL files. Updated docs/info.md decoder list (15→18, added
INT4/BitNet). Fixed local user_config.json (added bitnet/int4). Stress test
expanded to 13 formats. 38/38 tests pass.

## Implemented

### CI Pipeline Improvements (`.github/workflows/ci.yml`)

| Job | What it checks | New? |
|-----|---|---|
| lint | iverilog syntax, info.yaml structure, **source_files consistency** | Updated |
| claim-status-lint | Banned-word scan across all files | Existing |
| **verilator-lint** | `verilator --lint-only -Wall` on all RTL | **New** |
| test | cocotb 38 tests with Icarus Verilog | Updated (pinned cocotb==2.0.1) |

**Source-file consistency check**: new Python script in the lint job validates
that every `.v` file in `src/rtl/` is listed in `info.yaml:project.source_files`
and vice versa. Prevents the class of bug where a new decoder is added to RTL
but not to the file list, causing silent GDS synthesis failures.

### Documentation & Test Updates

- docs/info.md: decoder count 15→18, added INT4 and BitNet to format list
- Stress test: rapid format cycling expanded 12→13 formats (added INT4 0xF = -1)
- Local user_config.json: added bitnet_decode.v and int4_decode.v

## Research Summary (Loop 21)

### TTGF26a Submission Requirements
- Deadline: **June 22, 2026** (shuttle WS-2606)
- Chips expected October 1, delivery November 15
- Must pass DRC on all drawn/designer-generated GDS layers
- Use `PDK=gf180mcuD`, `LIBRELANE_TAG=3.0.3`
- Docker required for local hardening; CI hardens on push automatically

### GF180MCU Timing at 50 MHz
No published benchmark confirms 50 MHz on GF180MCU specifically. SKY130 (130nm)
designs reach 50-98 MHz. GF180MCU (180nm) will be slower. **50 MHz is plausible
but not guaranteed — plan for 25-40 MHz as safe target.** PDK constrains max
transition to 20% of clock period (4ns at 50 MHz). Our combinational decoders
have short critical paths; the ROM case statement is the longest path.

### Post-Silicon Debug for TT
Designers receive assembled dev boards. Testing is community-driven via Discord.
Expect slower-than-simulated clocks due to scan chain through 200+ designs.
Some designers build JTAG TAP debug infrastructure into their TT tiles.

## Metrics

- **On-die decoders**: 23 fmt_ids (18 unique modules + 5 aliases)
- **Tests**: 38 (4 anchor + 27 decoder + 7 stress)
- **Verified values**: 69,024 exhaustive + 72 stress
- **Verilator**: 0 warnings (-Wall, 20 modules)
- **CI jobs**: 4 (lint, claim-status-lint, verilator-lint, test)
- **Commits**: 28 on main (25 ahead of origin)
- **RTL files**: 19 Verilog source files (18 decoders + format_rom + top)
- **Deadline**: 2026-06-22 (21 days remaining)

## Three Collaboration Options for Next Loop

### Option A: Push to GitHub (CRITICAL — 25 Unpushed Commits)
Run `! gh auth login` to re-authenticate. **25 unpushed commits** is now an
emergency — the entire design exists only on this machine. After push, CI will
run all 4 jobs (lint, claim-status, verilator-lint, cocotb tests) and the GDS
workflow will start hardening. **No more implementation work should proceed
until the code is backed up on GitHub.**

### Option B: Local GDS Hardening Attempt
If Docker/colima is available, run local hardening to verify DRC/LVS before
the CI GDS workflow:
```
tt/tt_tool.py --gf harden
```
This would reveal area utilization, timing slack, and any DRC violations
immediately. Requires ~30 minutes and Docker daemon running.

### Option C: Clock Frequency Safety Net
Given research showing 50 MHz may be tight on GF180MCU, add a configurable
clock divider at the input. This would let the chip run at 25 MHz internally
while accepting 50 MHz at the TT interface. Low area cost (~20 cells), but
would require protocol timing adjustments. Alternative: just try 50 MHz and
accept that the chip may need to run slower post-silicon.
