gHashTag/tt-trinity-corona/docs/REPORT_2026-06-01_loop13.md

# Loop 13 Report — 2026-06-01

## Summary

Bootstrapped the GDS hardening pipeline and eliminated all cocotb deprecation warnings.
The project now has a complete CI/CD path from RTL to GDS via GitHub Actions.

## Implemented

### 1. GDS Hardening Flow
- Created `src/config.json` — minimal LibreLane config (20ns clock, `clk` port)
- Created `.github/workflows/gds.yml` — GF180MCU hardening via `tt-gds-action`
- Verified `tt_tool.py --gf --create-user-config` generates correct merged config:
  - Die area: 1440.32 x 736.96 um (4x4 tiles)
  - 14 Verilog sources, all resolved
  - 3.3V corner libs (tt/ss/ff), Metal4 top layer
  - 9 STA corners for timing closure
- Local hardening blocked on Docker (colima not running) — CI will handle it

### 2. cocotb 2.0 Migration
- `units="ns"` → `unit="ns"` (26 instances across 2 files)
- `.value.integer` → `.value.to_unsigned()` (9 instances across 2 files)
- All 21 tests still pass, zero deprecation warnings

### 3. CI Workflow Update
- Updated `.github/workflows/ci.yml` with proper cocotb test invocation
- Added `working-directory: test` and explicit `SIM=icarus TOPLEVEL_LANG=verilog`

## Research: GF180MCU Hardening

| Finding | Detail |
|---|---|
| Toolchain | LibreLane 3.0.3 (not OpenLane2) |
| PDK | gf180mcuD, auto-pulled by Docker |
| Config chain | `src/config.json` + `src/user_config.json` → `src/config_merged.json` |
| CI action | `TinyTapeout/tt-gds-action@main` with `pdk: gf180mcuD` |
| No manual SDC | Clock constraints derived from `info.yaml clock_hz` |
| Cell library | `gf180mcu_fd_sc_mcu7t5v0` (7-track, 5V-tolerant, running at 3.3V) |

## Research: Numeric Format Updates

| Format | Update |
|---|---|
| NVFP4 | NVIDIA diverged from OCP MX: E2M1 + E4M3 scale per 16 elements (vs MX's E8M0 per 32) |
| HiFloat4 | New 64-element hierarchical format, outperforms NVFP4 on accuracy |
| eXmY (Google) | Arbitrary bit-width format with perfect compression for 3/5/6/7/9-bit |
| E8M0 | MX block scale factor format — standalone decoder candidate |
| IEEE P3109 | Still not ratified (Interim Report v3.0, Aug 2025) |

## Weak Spot Analysis (updated)

| Area | Status | Risk | Change |
|---|---|---|---|
| RTL correctness | 21/21 pass | Low | — |
| Hardening flow | Config + CI created | **Medium** | Was HIGH |
| GDS generation | Blocked on Docker locally; CI ready | **Medium** | Was HIGH |
| cocotb deprecations | Fixed | Low | Was Low |
| GitHub push | Blocked on `gh auth login` | Medium | — |
| D2D adapter (Phase D) | Not started | Medium | — |

## Metrics

- **Commits**: 10 on main (9 ahead of origin)
- **Deadline**: 2026-06-22 (21 days remaining)
- **Test coverage**: 21 tests, 67,308 values, 0 deprecation warnings
- **CI jobs**: lint + claim-status-lint + test + GDS hardening

## Three Collaboration Options for Next Loop

### Option A: Push to GitHub + Trigger GDS CI
Authenticate with `gh auth login`, push all 9 commits, trigger the GDS
workflow. This is the single most impactful action: it validates the entire
pipeline end-to-end and produces the first GDS artifact. If DRC fails,
we learn immediately what needs fixing.

### Option B: Add E8M0 + MXINT8 Decoders
E8M0 (8-bit shared exponent for MX blocks) and MXINT8 (integer with
implicit 2^-6 scale) are missing from the catalog despite being core OCP MX
element types. Adding them completes the MX ecosystem coverage (E4M3,
E3M2, E2M1, E2M3, E8M0, MXINT8). Expand ROM to 80 records.

### Option C: Local Docker Hardening
Start colima, run `tt_tool.py --gf --harden` locally. Get immediate
feedback on synthesis, placement, routing, and DRC without waiting for
CI. Iterate on timing closure if needed (50 MHz at GF180MCU should be
easy but worth verifying).
