gHashTag/tt-trinity-corona/docs/REPORT_2026-06-01_loop12.md

# Loop 12 Report — 2026-06-01

## Summary

Fixed 5 compounding bugs discovered in Loop 11's first simulation run.
All 21 tests now pass: **67,308 decode values verified** across 12 decoders
plus ROM readback and anchor probe. Yosys synthesis clean, zero warnings.

## Bugs Fixed

### RTL Bugs (3)

1. **Output mux anchor conflict**: `is_anchor_cmd` (combinational, always-on)
   overrode STATUS readback whenever the last data byte was `0x7F`. Fix:
   swap priority so `ST_STATUS` is checked before `is_anchor_cmd`.

2. **Sub-byte decoder bit positions**: Right-shift register puts 1-byte data
   at `[31:24]`, so sub-byte formats must read low bits of that byte:
   - FP4/NF4 (4-bit): `[31:28]` → `[27:24]` (low nibble)
   - FP6 E3M2/E2M3 (6-bit): `[31:26]` → `[29:24]` (low 6 bits)

3. **Posit8 LZC casez ordering**: The `casez` matched `7'b0??????` first,
   returning `lzc=1` for ALL inputs starting with 0. Correct order:
   most-specific (most leading zeros) first. This broke all posit8 values
   with regime run length > 1.

### Test Infrastructure Bugs (2)

4. **Reset triggers CMD1**: `reset_dut` set `ui_in=0` (bit7=0), which the
   FSM interprets as CMD1 during post-reset idle clocks. Fix: `ui_in=0x80`.

5. **Read timing off by one clock**: `read_result_bytes` advanced the clock
   before sampling, so `status_cnt` was already incremented. Fix: sample
   combinational output (Timer 1ns) before advancing (RisingEdge).

## Research: Numeric Format Landscape (2024-2026)

| Topic | Status | Action |
|---|---|---|
| OCP MX | Still v1.0. NVIDIA diverged with NVFP4 (E2M1 + E4M3 scale/16) | Distinguish MXFP4 vs NVFP4 in catalog |
| IEEE P3109 | Not ratified. Interim Report v3.0 (Aug 2025) | No compliance target yet |
| Posit silicon | No competing tapeout found. FPGA only | Our posit8 decoder is novel |
| HiFloat4 | New 64-element hierarchical format, outperforms NVFP4 | Candidate for catalog expansion |
| eXmY (Google) | Arbitrary bit-width with perfect compression | Candidate for catalog expansion |
| NF4 hardware | No silicon decoder exists anywhere | Our NF4 LUT is first-of-kind |

## Weak Spot Analysis

| Area | Status | Risk |
|---|---|---|
| RTL correctness | 21/21 pass, 67K values | Low |
| ROM completeness | 78/78 records, all verified | Low |
| Hardening flow | Not configured (no OpenLane/LibreLane) | **HIGH** |
| GDS submission | Blocked on hardening flow | **HIGH** |
| D2D adapter (Phase D) | Not started | Medium |
| cocotb 2.0 deprecations | `units`→`unit`, `.integer`→`.to_unsigned()` | Low |
| GitHub push | Blocked on `gh auth login` | Low |

## Metrics

- **Test coverage**: 21 tests, 67,308 verified values, 12 decoder formats
- **Yosys synthesis**: Clean (0 warnings, 0 errors)
- **Commits**: 8 on main (7 ahead of origin)
- **Deadline**: 2026-06-22 (21 days remaining)

## Three Collaboration Options for Next Loop

### Option A: Hardening Flow Bootstrap
Set up OpenLane2/LibreLane configuration for GF180MCU GDS generation.
Create `config.json`, constraint files, pin placement. Run initial
synthesis → floorplan → placement → routing. This is the **critical path**
to shuttle submission — without GDS, nothing else matters.

### Option B: Decoder Expansion (NVFP4 + E8M0)
Add two new decoders based on research findings: NVFP4 element decoder
(same E2M1 as MXFP4 but needs catalog distinction) and E8M0 scale-only
format (8-bit exponent used as MX block scale factor). Expand ROM to 80
records. Both are relevant for OCP MX ecosystem completeness.

### Option C: Test Hardening + cocotb 2.0 Migration
Fix all deprecation warnings (`units`→`unit`, `.integer`→`.to_unsigned()`).
Add edge-case tests: back-to-back transactions without reset, rapid
format switching, boundary values for multi-byte formats. Add CI
workflow (GitHub Actions with icarus + cocotb).
