gHashTag/tt-trinity-corona/docs/REPORT_2026-06-01.md

# Corona Loop Report -- 2026-06-01

## 1. Weakness Analysis

### Critical (blocking submission)

| # | Weakness | Status After This Loop |
|---|---|---|
| W1 | Zero RTL files | **FIXED** -- stub `tt_um_trinity_corona.v` with anchor probe; placeholder `format_rom.v` |
| W2 | Zero testbenches | **FIXED** -- `test/test_anchor.py` (4 cocotb tests: probe, stability, non-anchor, reset) |
| W3 | No build system | **FIXED** -- `Makefile` + `test/Makefile` (cocotb/icarus) |
| W4 | No CI | **FIXED** -- `.github/workflows/ci.yml` (lint + test jobs) |

### High (blocking Phase B)

| # | Weakness | Status |
|---|---|---|
| W5 | ADR directory missing | **FIXED** -- `docs/adr/` with template + ADR-0001 (tile 4x4) + ADR-0002 (shuttle ttgf26a) |
| W6 | Verilog ROM emitter not in repo | OPEN -- PR to gHashTag/t27 needed (Phase B deliverable) |
| W7 | PR #1028 (SSOT catalog) status unknown | OPEN -- must confirm merge before ROM generation |
| W8 | Shuttle refs inconsistent | **FIXED** -- info.yaml, README.md updated to ttgf26a |

### Medium

| # | Weakness | Status |
|---|---|---|
| W9 | Gamma D2D module not vendored | OPEN -- Phase D; git submodule strategy TBD |
| W10 | GF180MCU density estimate (2.1x) unvalidated | OPEN -- Phase A synthesis trial needed |
| W11 | PLAN.md field widths vs rom_layout.t27 discrepancy | KNOWN -- rom_layout.t27 is authoritative |
| W12 | info.yaml missing `project:` section | **FIXED** -- restructured to match TT template |
| W13 | `docs/info.md` missing | **FIXED** -- created with How it works / How to test / External hardware |

### Low

| # | Weakness | Status |
|---|---|---|
| W14 | Takum16 VHDL license (R2) | OPEN -- contact Hunhold before Phase C |
| W15 | TTGF26a deadline compressed | ACKNOWLEDGED -- 21 days to submission (2026-06-22) |

---

## 2. Scientific Literature Review

### Key papers by topic (relevance to Corona)

**Posit hardware:**
- PPU (Rossi+ 2023): 7-15% area overhead for posit8/16 in RISC-V. Validates posit8 Tier-1 (300-800 cells).
- SPADE (2025): SIMD posit at TSMC 28nm, 1.38 GHz. Confirms posit32 feasibility but high cell count.

**Takum (standing counterexample to FL-002):**
- Hunhold 2024a (arXiv:2404.18603): Takum beats posit at dynamic range. Key format for the catalog.
- Hunhold 2024b (arXiv:2408.10594): VHDL codec, 38% latency reduction vs posit. **License unclear -- R2 risk.**
- Hunhold 2024c (arXiv:2412.20273): Integer representation analysis. Mathematical reference for ROM entries.
- Hunhold 2024d (arXiv:2412.20268): Exceptional stability in sparse solvers. Strengthens counterexample.

**BFloat16/TF32:**
- Trivial decode (50-200 cells). bf16 = truncated FP32; tf32 = 19-bit FP32 mode.
- Open-source RTL exists (Essenceia/BFloat16 on GitHub). Safe early-win for Phase C.

**MX (Microscaling):**
- OCP MX v1.0 spec (AMD/Arm/Intel/Meta/Microsoft/NVIDIA/Qualcomm consortium).
- MXFP8 element decode is simple (case statement). Block structure with shared scale is out of scope for Corona (per-element decode only).

**LNS (Logarithmic Number System):**
- LNS-Madam (NVIDIA 2022): 90% energy reduction vs FP32 for 8-bit LNS training. Validates lns8 Tier-1.
- Logarithmic-Posit (DAC 2024): LNS+posit hybrid. Not in catalog but candidate for future SSOT expansion.

**GF180MCU PDK:**
- 180nm, ~52 kGates/mm^2 (vs ~160 kGates/mm^2 for SKY130). No open SRAM macro.
- 2.1x density penalty confirmed by community estimates. ROM must be combinational (case-statement synthesis).

**GoldenFloat (GF4-GF256):**
- **No published academic work found.** GoldenFloat appears original to TRI-NET.
- Nearest precedent: Bergman (1957) golden ratio base; Stakhov (1980-2021) Fibonacci computer arithmetic.
- PLAN.md correctly classifies as [Verified] for algebra, [Open conjecture] for moat (FL-002).

**ROM synthesis:**
- Combinational ROM (case statement) exploits data redundancy via Boolean optimization.
- 77 records x 80 bits estimated at 2,000-6,000 cells depending on data structure.
- 4x4 tiles (~8,000 cells) is tight but feasible for ROM + 5-8 Tier-1 modules.

---

## 3. Decomposed Plan (TTGF26a deadline: 2026-06-22)

### Week 1 (Jun 1-7): Phase A -- PDK + Synthesis Trial

| Day | Deliverable |
|-----|---|
| 1 | ~~Stub RTL + anchor test + CI~~ **DONE** (this loop) |
| 2 | Install OpenLane2 + GF180MCU PDK locally |
| 3 | Synthesize stub design; measure cells/tile on GF180MCU |
| 4 | Write tile-budget memo (`docs/phase_a/tile_budget.md`) |
| 5 | Confirm ADR-0001 (4x4) with actual synthesis data |

### Week 2 (Jun 8-14): Phase B -- ROM Emitter + ROM RTL

| Day | Deliverable |
|-----|---|
| 6-7 | Implement Verilog ROM emitter in gen_formats_catalog.py; PR to t27 |
| 8 | Generate format_rom.v from SSOT (77 records x 80 bits) |
| 9 | ROM readback cocotb test (verify all 77 records bit-exact) |
| 10 | Synthesize ROM; measure area; update tile budget |

### Week 3 (Jun 15-21): Phase C (MVP-5) + Submission

| Day | Deliverable |
|-----|---|
| 11-13 | Implement MVP-5 Tier-1 modules: posit8, bf16, mxfp8_e4m3, lns8, bcd |
| 14-15 | Per-module round-trip cocotb tests (10 vectors each) |
| 16-17 | Integration: top module wires ROM + 5 decoders + anchor |
| 18-19 | OpenLane2 synthesis + DRC on GF180MCU |
| 20 | GDS generation + shuttle submission to TTGF26a |

### Deferred to post-submission

- Phase D: D2D wiring + Gamma routing (not needed for standalone Corona)
- Phase E: Full 10k-vector conformance suite
- Phase F: Remaining 7-10 Tier-1 modules (posit32, tf32, fp4, fp6, nf4, decimal32, takum16)

---

## 4. What Was Implemented This Loop

| Item | Files |
|---|---|
| info.yaml restructured | `info.yaml` (project section, 4x4 tiles, ttgf26a) |
| Datasheet template | `docs/info.md` (How it works / How to test / External hardware) |
| Stub RTL (anchor probe) | `src/rtl/tt_um_trinity_corona.v` (Phase A stub, 77 lines) |
| ROM placeholder | `src/rtl/format_rom.v` (empty case statement, Phase B target) |
| Cocotb anchor tests | `test/test_anchor.py` (4 tests: probe, stability, non-anchor, reset) |
| Build infrastructure | `Makefile`, `test/Makefile` |
| GitHub Actions CI | `.github/workflows/ci.yml` (lint + test jobs) |
| ADR directory + records | `docs/adr/0000-template.md`, `0001-tile-size-4x4.md`, `0002-shuttle-ttgf26a.md` |
| README.md updated | Shuttle ttgf26a, tiles 4x4, repo layout updated |
| Verilog lint | **PASSES** (iverilog -Wall -g2012) |
| YAML validation | **PASSES** (project section present, all required fields) |

---

## 5. Spec Consistency Verification

All .t27 spec files verified consistent:
- Cluster counts sum to 77 (13 clusters)
- ROM record layout: 80 bits, all fields accounted (no gaps)
- Protocol pin allocation matches info.yaml pinout
- Anchor 0x47C0 derivation consistent across 4 spec files
- D2D pin assignments (uio[3:0] TX, uio[7:4] RX) match everywhere
- Tier-1 (12 modules) and Tier-2 (13 modules) lists match PLAN.md
- One known discrepancy: PLAN.md Section 3.2 field widths predate rom_layout.t27 finalization (rom_layout.t27 is authoritative)

---

## 6. Three Collaboration Options for Next Loop

### Option A: "PDK Sprint" -- Install OpenLane2 + First Synthesis

Focus the next loop on getting OpenLane2 + GF180MCU PDK installed and running
the stub design through synthesis. This is the highest-risk item (R1: PDK
maturity) and the earliest falsification point. Deliverable: synthesis area
report + cells/tile measurement.

**Why this first:** If GF180MCU synthesis fails or density is worse than 2.1x,
everything downstream changes. Better to know now.

### Option B: "ROM Generator" -- Build the Verilog ROM Emitter

Focus on implementing the Verilog ROM emitter as the 17th output language of
gen_formats_catalog.py. This is the Phase B critical path item. Deliverable:
generated format_rom.v with all 77 records, cocotb readback test passing.

**Why this first:** The ROM is the core of the chip. Without it, Tier-1 module
work is speculative. The emitter also validates the SSOT -> silicon chain.

### Option C: "MVP-5 Blitz" -- Implement 5 Tier-1 Decoders

Skip ahead to implementing the 5 simplest Tier-1 decode modules (bf16, mxfp8,
lns8, bcd, posit8) directly in the stub, with round-trip tests. This builds
the most RTL in the shortest time and de-risks Phase C.

**Why this first:** bf16 and mxfp8 are ~50-200 cells each and can be written
in an hour. Having 5 working decoders makes the MVP tangible and testable,
even before the ROM emitter is done.

---

*Generated by Loop iteration 1, 2026-06-01.*
