gHashTag/tt-trinity-corona/docs/FORMAT_COUNT_PROVENANCE.md

# Происхождение числа форматов: 77 / 80 / 83 / 109 [Verified]

> Назначение: зафиксировать, почему в разных артефактах фигурируют РАЗНЫЕ числа
> форматов, и какое из них канон. Это не дефект и не опечатка — это три точки во
> времени одного растущего каталога. Документ honesty-критичен: запрещено «слепо»
> сводить всё к одному числу, потому что кремний Corona заморожен на своём снимке.

## Сводка [Verified]

| Артефакт | Число | Что это | Статус |
|---|---:|---|---|
| `gHashTag/t27` `specs/numeric/formats_catalog.t27` (master, живой) | **инвариант** — 109 на arXiv v3 (сентябрь 2026); 83 было на момент этой заметки (июнь 2026) | Живой SSOT-источник (записи `// CATALOG:` на master 2026-09-05; в июне 2026 — `name:`); число читается из `tools/gen_formats_catalog.py`, а не переписывается из документов | **КАНОН (живой инвариант)** |
| `gHashTag/t27` `gen/numeric/formats_catalog.json` (HEAD на июнь 2026) | 77 (июнь 2026) | Сгенерированный артефакт | **СНЯТ С ОТСЛЕЖИВАНИЯ** 2026-06-14 (коммит `aa01dd4f1` «untrack stale gen/numeric catalog artifacts (drift 77 vs SSOT 83)», закрыл #1120); на master t27 файла нет [Verified 2026-09-05: 0 путей `gen/numeric/*` в дереве master] |
| `tt-trinity-corona` (PLAN.md / README.md / `tools/gen_rom.py`) | 80 | Снимок, вшитый в ROM кристалла | **FROZEN SNAPSHOT** |
| GitHub-описание репозитория Corona | 77 (июнь 2026) | Текст витрины | число форматов из описания убрано [Verified 2026-09-05: текущее описание числа форматов не содержит] |
| Препринт arXiv:2606.09686 (abstract) | 84 (июнь 2026) → 83 (v2, live) → 109 (v3) | Внешняя публикация | erratum выполнена в v2 (22 июня 2026) [Verified 2026-09-05: abstract v2 содержит 83, 84 — нет]; v3 подана 4 сентября 2026, анонс 7 сентября 2026, новое название «Golden Ruler: A Numeric Format Catalog with Bit-Exact Conformance Vectors for FP8, BF16, MXFP4, and Microscaling Formats» |

## Хронология [Verified по git-истории t27]

1. **2026-06-01** — коммит `d9b76c5e9` «Universal Numeric Format Catalog (SSOT, 77
   formats)». Источник И сгенерированный JSON = **77**.
2. **(между)** — каталог дорос до **80**; именно на этом снимке (PR #1028,
   commit `18ae35a`, ветка `feat/formats-catalog-ssot-77-formats`) Corona вшила
   ROM на 80 записей и заморозила GDS (последний коммит Corona 2026-06-08).
3. **2026-06-07** — коммит `0f7424bb0` «GF ladder expansion v1.2» дорастил
   `formats_catalog.t27` до **83** записей `name:`. **Сгенерированный
   `formats_catalog.json` НЕ был перегенерён** → так и остался на 77. Это
   реальный технический долг в t27 (рассинхрон источник↔codegen), а не в Corona.
4. **2026-06-14** — коммит `aa01dd4f1` «untrack stale gen/numeric catalog artifacts
   (drift 77 vs SSOT 83)» (#1120) снял сгенерированный JSON с отслеживания; на master
   t27 его больше нет — число читается только из `tools/gen_formats_catalog.py`.
5. **2026-09** — источник дорос до **109** записей (`// CATALOG:` на master, измерено
   2026-09-05); это число в arXiv:2606.09686 v3 (подана 4 сентября 2026, анонс
   7 сентября 2026).

## Какое число «правильное» в каком контексте

- **Канон для статей, грантов, матрицы форматов, любой новой работы:** живой
  инвариант, а не фиксированное число. Его читают из `gHashTag/t27`
  `tools/gen_formats_catalog.py` (источник `specs/numeric/formats_catalog.t27`,
  master) в момент публикации. На arXiv:2606.09686 v3 (сентябрь 2026) — **109**;
  **83** — цифра v2 (июнь 2026), в живых документах как «текущее» число больше
  не пишется. [Verified 2026-09-05: `tools/gen_formats_catalog.py` и
  `specs/numeric/formats_catalog.t27` есть на master t27].
- **Число, физически вшитое в кремний Corona:** **80** [Spec — ROM на 80 записей,
  GDS заморожен]. Менять его в коде Corona задним числом ЗАПРЕЩЕНО: исходник
  обязан совпадать с тем, что отправлено на изготовление.
- **77 в `gen/numeric/formats_catalog.json` и в описании Corona** — устаревшие
  тени первого снимка; оба следа закрыты. JSON не перегенерирован, а снят с
  отслеживания в t27 (коммит `aa01dd4f1`, 2026-06-14, #1120) и на master не
  существует; в описании репозитория Corona числа форматов больше нет.
  [Verified 2026-09-05]

## Действия (июнь 2026; статус проверен 2026-09-05)

- **Corona (этот репо):** НЕ переписывать 80→83. Добавлена эта заметка-провенанс +
  ссылка из README/PLAN, чтобы число 80 читалось как осознанный замороженный снимок,
  а не ошибка. [Verified — правка только документации, GDS не тронут]
- **t27:** ~~перегенерировать `gen/numeric/formats_catalog.json` из источника (77→83),
  обновить описание репозитория Corona 77→«80 (frozen) от канона 83»~~ — [ЗАКРЫТО,
  УСТАРЕЛО 2026-09-05]: JSON снят с отслеживания (t27 `aa01dd4f1`, 2026-06-14, #1120),
  на master его нет; из описания Corona число форматов убрано. Формулировка
  «от канона 83» больше не действует: канон — живой инвариант (109 на v3), см. выше.
- **arXiv:2606.09686:** ~~erratum v2 — 84→83~~ — [ВЫПОЛНЕНО]: v2 (22 июня 2026, live)
  даёт 83; v3 (подана 4 сентября 2026, анонс 7 сентября 2026) — 109 форматов,
  название «Golden Ruler ...» (см. сводку).

## Якоря (не перефразировать)

- SSOT: `gHashTag/t27` `specs/numeric/formats_catalog.t27`, PR #1028.
- DOI: 10.5281/zenodo.19227877.
- TG-TRIAD-X cross-die anchor: `{uio_out, uo_out} == 16'h47C0`.
