gHashTag/tt-trinity-corona/formal/fv_fsm.sv

// SPDX-License-Identifier: Apache-2.0
// Formal verification wrapper for Protocol v2 FSM.
// Properties are defined inside tt_um_trinity_corona.v under `ifdef FORMAL.
// This file is a placeholder — the .sby config uses the DUT directly as top.
// Run: sby -f fv_fsm.sby
