gHashTag/tt-trinity-corona/test/tb_gls_smoke.v

// Gate-level simulation smoke test (no cocotb dependency).
// 76 tests: all 18 decoders (positive + negative + boundary + subnormal),
// NaN/Inf/-0, sign extension, aliases, NOT_IMPL, ROM golden validation,
// synthesis stress, posit8 regime boundary sweep, reset.
// Usage: yosys -> synth_netlist.v, then iverilog + simcells.v + this file.
`timescale 1ns/1ps

module tb_gls_smoke;
    reg        clk = 0;
    reg        rst_n = 0;
    reg        ena = 1;
    reg  [7:0] ui_in = 8'h80;
    reg  [7:0] uio_in = 8'h00;
    wire [7:0] uo_out, uio_out, uio_oe;

    tt_um_trinity_corona dut (
        .clk(clk), .rst_n(rst_n), .ena(ena),
        .ui_in(ui_in), .uo_out(uo_out),
        .uio_in(uio_in), .uio_out(uio_out), .uio_oe(uio_oe)
    );

    always #10 clk = ~clk;

    integer errors = 0;

    task check(input [7:0] expected_uo, input [7:0] expected_uio, input [159:0] label);
    begin
        if (uo_out !== expected_uo || uio_out !== expected_uio) begin
            $display("FAIL [%0s]: uo=%02X uio=%02X (expected %02X %02X)",
                     label, uo_out, uio_out, expected_uo, expected_uio);
            errors = errors + 1;
        end
    end
    endtask

    integer pre_err;
    task decode_1byte(
        input [6:0] fmt_id,
        input [7:0] data_byte,
        input [31:0] expected_fp32,
        input [159:0] name
    );
    begin
        pre_err = errors;
        ui_in = {1'b0, fmt_id};
        @(posedge clk); #1;
        ui_in = 8'h01;
        @(posedge clk); #1;
        ui_in = data_byte;
        @(posedge clk); #1;
        ui_in = 8'h80;
        check(expected_fp32[7:0],   8'h00, name);
        @(posedge clk); #1;
        check(expected_fp32[15:8],  8'h00, name);
        @(posedge clk); #1;
        check(expected_fp32[23:16], 8'h00, name);
        @(posedge clk); #1;
        check(expected_fp32[31:24], 8'h00, name);
        if (errors == pre_err) $display("PASS: %0s -> %08X", name, expected_fp32);
        @(posedge clk); #1;
        @(posedge clk); #1;
    end
    endtask

    initial begin
        // Reset
        #100;
        rst_n = 1;
        @(posedge clk); #1;

        // --- Test 1: Anchor probe (combinational) ---
        ui_in = 8'h7F;
        #2;
        if (uo_out !== 8'hC0 || uio_out !== 8'h47 || uio_oe !== 8'hFF) begin
            $display("FAIL: anchor uo=%02X uio=%02X oe=%02X", uo_out, uio_out, uio_oe);
            errors = errors + 1;
        end else begin
            $display("PASS: anchor = 0x47C0, oe=FF");
        end

        // --- Test 2: BF16 decode of +1.0 (0x3F80) ---
        // CMD1: fmt_id = 8 (BF16)
        ui_in = 8'h08;
        @(posedge clk); #1;
        // CMD2: byte_count = 2
        ui_in = 8'h02;
        @(posedge clk); #1;
        // DATA byte 0 (LSB): 0x80
        ui_in = 8'h80;
        @(posedge clk); #1;
        // DATA byte 1 (MSB): 0x3F — on this edge, FSM enters STATUS
        ui_in = 8'h3F;
        @(posedge clk); #1;
        // STATUS: FSM is now in STATUS, status_cnt=0 visible after this edge
        ui_in = 8'h80;
        // status_cnt advances each posedge; sample byte N after edge N+1
        // Byte 0 (cnt=0): visible NOW (state just entered STATUS)
        check(8'h00, 8'h00, "bf16 status[0]");
        @(posedge clk); #1;
        check(8'h00, 8'h00, "bf16 status[1]");
        @(posedge clk); #1;
        check(8'h80, 8'h00, "bf16 status[2]");
        @(posedge clk); #1;
        check(8'h3F, 8'h00, "bf16 status[3]");

        // DONE→IDLE: FSM needs 2 cycles (STATUS→DONE→IDLE)
        @(posedge clk); #1;
        @(posedge clk); #1;

        // --- Test 3: Posit8 decode of +1.0 (0x40 -> 0x3F800000) ---
        decode_1byte(7'd31, 8'h40, 32'h3F800000, "posit8 +1.0");

        // --- Test 4: FP4 E2M1 decode of +1.0 (0x02 -> 0x3F800000) ---
        decode_1byte(7'd41, 8'h02, 32'h3F800000, "fp4 +1.0");

        // --- Test 5: NF4 decode of +1.0 (0x0F -> 0x3F800000) ---
        decode_1byte(7'd70, 8'h0F, 32'h3F800000, "nf4 +1.0");

        // --- Test 6: BitNet decode of +1 (0x01 -> 0x3F800000) ---
        decode_1byte(7'd71, 8'h01, 32'h3F800000, "bitnet +1");

        // --- Test 7: INT4 decode of +1 (0x01 -> 0x00000001) ---
        decode_1byte(7'd46, 8'h01, 32'h00000001, "int4 +1");

        // --- Test 8: FP8 E5M2 decode of +1.0 (0x3C -> 0x3F800000) ---
        decode_1byte(7'd10, 8'h3C, 32'h3F800000, "fp8e5m2 +1.0");

        // --- Test 9: E8M0 decode of 2^0 (0x7F -> 0x3F800000) ---
        decode_1byte(7'd78, 8'h7F, 32'h3F800000, "e8m0 2^0");

        // --- Test 10: MXINT8 decode of +1.0 (0x40 -> 0x3F800000) ---
        decode_1byte(7'd79, 8'h40, 32'h3F800000, "mxint8 +1.0");

        // --- Test 11: TF32 decode of +1.0 (3 bytes -> 0x3F800000) ---
        pre_err = errors;
        ui_in = 8'h09;
        @(posedge clk); #1;
        ui_in = 8'h03;
        @(posedge clk); #1;
        ui_in = 8'h00;
        @(posedge clk); #1;
        ui_in = 8'hFC;
        @(posedge clk); #1;
        ui_in = 8'h01;
        @(posedge clk); #1;
        ui_in = 8'h80;
        check(8'h00, 8'h00, "tf32 status[0]");
        @(posedge clk); #1;
        check(8'h00, 8'h00, "tf32 status[1]");
        @(posedge clk); #1;
        check(8'h80, 8'h00, "tf32 status[2]");
        @(posedge clk); #1;
        check(8'h3F, 8'h00, "tf32 status[3]");
        if (errors == pre_err) $display("PASS: tf32 +1.0 -> 3F800000");
        @(posedge clk); #1;
        @(posedge clk); #1;

        // --- Test 12: FP6 E3M2 decode of +1.0 (0x0C -> 0x3F800000) ---
        decode_1byte(7'd40, 8'h0C, 32'h3F800000, "fp6e3m2 +1.0");

        // --- Test 13: FP6 E2M3 decode of +1.0 (0x08 -> 0x3F800000) ---
        decode_1byte(7'd77, 8'h08, 32'h3F800000, "fp6e2m3 +1.0");

        // --- Test 14: MXFP8 E4M3 decode of +1.0 (0x38 -> 0x3F800000) ---
        decode_1byte(7'd39, 8'h38, 32'h3F800000, "mxfp8 +1.0");

        // --- Test 15: FP8 E4M3 FNUZ decode of +1.0 (0x40 -> 0x3F800000) ---
        decode_1byte(7'd14, 8'h40, 32'h3F800000, "fnuz +1.0");

        // --- Test 16: INT8 decode of +1 (0x01 -> 0x00000001) ---
        decode_1byte(7'd47, 8'h01, 32'h00000001, "int8 +1");

        // --- Test 17: BCD decode of 42 (0x42 -> 0x0000002A) ---
        decode_1byte(7'd53, 8'h42, 32'h0000002A, "bcd 42");

        // --- Test 18: LNS8 decode of 0x01 (magnitude=267=0x010B) ---
        decode_1byte(7'd42, 8'h01, 32'h0000010B, "lns8 0x01");

        // --- Test 19: NOT_IMPL sentinel (fmt_id=1, unsupported) ---
        decode_1byte(7'd1, 8'hAA, 32'h4E0701FF, "not-impl");

        // --- Test 20: ROM readback for fmt_id=8 (BF16) ---
        ui_in = 8'h08;
        @(posedge clk); #1;
        ui_in = 8'h00;
        @(posedge clk); #1;
        ui_in = 8'h80;
        if (uo_out === 8'h00 && uio_out === 8'h00) begin
            $display("FAIL: ROM readback byte[0] all zeros");
            errors = errors + 1;
        end else begin
            $display("PASS: ROM readback byte[0] = %02X", uo_out);
        end
        repeat(11) begin @(posedge clk); #1; end

        // ===================== Edge-case / boundary tests =====================

        // --- Test 21: INT4 -8 (min negative, sign extension) ---
        decode_1byte(7'd46, 8'h08, 32'hFFFFFFF8, "int4 -8");

        // --- Test 22: INT4 -1 (all-ones sign extension) ---
        decode_1byte(7'd46, 8'h0F, 32'hFFFFFFFF, "int4 -1");

        // --- Test 23: INT8 -128 (min negative) ---
        decode_1byte(7'd47, 8'h80, 32'hFFFFFF80, "int8 -128");

        // --- Test 24: INT8 -1 ---
        decode_1byte(7'd47, 8'hFF, 32'hFFFFFFFF, "int8 -1");

        // --- Test 25: BitNet -1 (ternary 0b10) ---
        decode_1byte(7'd71, 8'h02, 32'hBF800000, "bitnet -1");

        // --- Test 26: BitNet NaN (ternary 0b11, reserved) ---
        decode_1byte(7'd71, 8'h03, 32'h7FC00000, "bitnet NaN");

        // --- Test 27: NF4 -1.0 (index 0) ---
        decode_1byte(7'd70, 8'h00, 32'hBF800000, "nf4 -1.0");

        // --- Test 28: NF4 zero (index 7) ---
        decode_1byte(7'd70, 8'h07, 32'h00000000, "nf4 zero");

        // --- Test 29: FP8 E5M2 +Inf (0x7C) ---
        decode_1byte(7'd10, 8'h7C, 32'h7F800000, "fp8e5m2 +Inf");

        // --- Test 30: FP8 E5M2 NaN (0xFF) ---
        decode_1byte(7'd10, 8'hFF, 32'hFFC00000, "fp8e5m2 NaN");

        // --- Test 31: FP8 E5M2 smallest subnormal (0x01) ---
        decode_1byte(7'd10, 8'h01, 32'h37800000, "fp8e5m2 subn");

        // --- Test 32: E8M0 NaN (0xFF) ---
        decode_1byte(7'd78, 8'hFF, 32'h7FC00000, "e8m0 NaN");

        // --- Test 33: E8M0 min (0x00 -> 2^-127) ---
        decode_1byte(7'd78, 8'h00, 32'h00400000, "e8m0 min");

        // --- Test 34: MXINT8 reserved NaN (0x80) ---
        decode_1byte(7'd79, 8'h80, 32'h7FC00000, "mxint8 NaN");

        // --- Test 35: MXINT8 zero (0x00) ---
        decode_1byte(7'd79, 8'h00, 32'h00000000, "mxint8 zero");

        // --- Test 36: BF16 NaN (0x7FC0) ---
        pre_err = errors;
        ui_in = 8'h08;
        @(posedge clk); #1;
        ui_in = 8'h02;
        @(posedge clk); #1;
        ui_in = 8'hC0;
        @(posedge clk); #1;
        ui_in = 8'h7F;
        @(posedge clk); #1;
        ui_in = 8'h80;
        check(8'h00, 8'h00, "bf16nan s[0]");
        @(posedge clk); #1;
        check(8'h00, 8'h00, "bf16nan s[1]");
        @(posedge clk); #1;
        check(8'hC0, 8'h00, "bf16nan s[2]");
        @(posedge clk); #1;
        check(8'h7F, 8'h00, "bf16nan s[3]");
        if (errors == pre_err) $display("PASS: bf16 NaN -> 7FC00000");
        @(posedge clk); #1;
        @(posedge clk); #1;

        // --- Test 37: FP8 E4M3 FNUZ NaN (0x80 -> positive qNaN, sign overridden) ---
        decode_1byte(7'd14, 8'h80, 32'h7FC00000, "fnuz NaN");

        // --- Test 38: MXINT8 -1 (0xFF -> -1/64 = 0xBC800000) ---
        decode_1byte(7'd79, 8'hFF, 32'hBC800000, "mxint8 -1");

        // --- Test 39: Alias fmt_id=11 (FP8 E4M3) == fmt_id=39 (MXFP8 E4M3) ---
        decode_1byte(7'd11, 8'h38, 32'h3F800000, "alias 11=39");

        // --- Test 40: Alias fmt_id=13 (FP4 ML) == fmt_id=41 (FP4 MX) ---
        decode_1byte(7'd13, 8'h02, 32'h3F800000, "alias 13=41");

        // --- Test 41: Alias fmt_id=75 (NF4 BnB) == fmt_id=70 (NF4 QLoRA) ---
        decode_1byte(7'd75, 8'h0F, 32'h3F800000, "alias 75=70");

        // ============= Synthesis stress: leading-one encoder (MXINT8) =============

        // --- Test 42: MXINT8 lop=0 (abs=1, smallest magnitude) ---
        decode_1byte(7'd79, 8'h01, 32'h3C800000, "mxint8 lop0");

        // --- Test 43: MXINT8 lop=1 (abs=2) ---
        decode_1byte(7'd79, 8'h02, 32'h3D000000, "mxint8 lop1");

        // --- Test 44: MXINT8 lop=2 (abs=4) ---
        decode_1byte(7'd79, 8'h04, 32'h3D800000, "mxint8 lop2");

        // --- Test 45: MXINT8 lop=5 (abs=32) ---
        decode_1byte(7'd79, 8'h20, 32'h3F000000, "mxint8 lop5");

        // --- Test 46: MXINT8 lop=6 max (abs=127 -> +127/64) ---
        decode_1byte(7'd79, 8'h7F, 32'h3FFE0000, "mxint8 max");

        // --- Test 47: MXINT8 negative max (0x81 -> -127/64) ---
        decode_1byte(7'd79, 8'h81, 32'hBFFE0000, "mxint8 -max");

        // ============= Synthesis stress: subnormal normalization =============

        // --- Test 48: FNUZ subnormal mant=001 (exp=117) ---
        decode_1byte(7'd14, 8'h01, 32'h3A800000, "fnuz sub001");

        // --- Test 49: FNUZ subnormal mant=100 (exp=119) ---
        decode_1byte(7'd14, 8'h04, 32'h3B800000, "fnuz sub100");

        // --- Test 50: FP8 E5M2 negative zero (0x80 -> -0.0) ---
        decode_1byte(7'd10, 8'h80, 32'h80000000, "fp8e5m2 -0");

        // --- Test 51: FP8 E5M2 -Inf (0xFC) ---
        decode_1byte(7'd10, 8'hFC, 32'hFF800000, "fp8e5m2 -Inf");

        // ============= Remaining decoder boundaries =============

        // --- Test 52: Posit8 zero (0x00) ---
        decode_1byte(7'd31, 8'h00, 32'h00000000, "posit8 zero");

        // --- Test 53: Posit8 NaR (0x80 -> qNaN) ---
        decode_1byte(7'd31, 8'h80, 32'h7FC00000, "posit8 NaR");

        // --- Test 54: Posit8 -1.0 (0xC0) ---
        decode_1byte(7'd31, 8'hC0, 32'hBF800000, "posit8 -1.0");

        // --- Test 55: BF16 +Inf (0x7F80) ---
        pre_err = errors;
        ui_in = 8'h08; @(posedge clk); #1;
        ui_in = 8'h02; @(posedge clk); #1;
        ui_in = 8'h80; @(posedge clk); #1;
        ui_in = 8'h7F; @(posedge clk); #1;
        ui_in = 8'h80;
        check(8'h00, 8'h00, "bf16inf s[0]");
        @(posedge clk); #1;
        check(8'h00, 8'h00, "bf16inf s[1]");
        @(posedge clk); #1;
        check(8'h80, 8'h00, "bf16inf s[2]");
        @(posedge clk); #1;
        check(8'h7F, 8'h00, "bf16inf s[3]");
        if (errors == pre_err) $display("PASS: bf16 +Inf -> 7F800000");
        @(posedge clk); #1;
        @(posedge clk); #1;

        // --- Test 56: FP6 E3M2 subnormal (0x01, exp=123) ---
        decode_1byte(7'd40, 8'h01, 32'h3D800000, "fp6e3m2 sub");

        // --- Test 57: LNS8 max positive (0x7F, mag=62720) ---
        decode_1byte(7'd42, 8'h7F, 32'h0000F500, "lns8 max");

        // --- Test 58: LNS8 signed (0x80, sign=1 mag=256) ---
        decode_1byte(7'd42, 8'h80, 32'h80000100, "lns8 neg");

        // --- Test 59: BCD zero (0x00) ---
        decode_1byte(7'd53, 8'h00, 32'h00000000, "bcd zero");

        // --- Test 60: BCD max valid (0x99 = 99 decimal = 0x63) ---
        decode_1byte(7'd53, 8'h99, 32'h00000063, "bcd 99");

        // --- Test 61: Alias fmt_id=12 (FP6 E3M2 ML) == fmt_id=40 ---
        decode_1byte(7'd12, 8'h0C, 32'h3F800000, "alias 12=40");

        // --- Test 62: Alias fmt_id=69 (FNUZ alt) == fmt_id=14 ---
        decode_1byte(7'd69, 8'h40, 32'h3F800000, "alias 69=14");

        // ===================== Posit8 regime boundary sweep =====================
        // Tests 63-72: exercise all regime encoding paths through synthesis

        // --- Test 63: Posit8 smallest positive (0x01 = 1/64, regime k=-6) ---
        decode_1byte(7'd31, 8'h01, 32'h3C800000, "posit8 1/64");

        // --- Test 64: Posit8 1.0 (0x40, regime k=0) ---
        decode_1byte(7'd31, 8'h40, 32'h3F800000, "posit8 1.0");

        // --- Test 65: Posit8 2.0 (0x60, regime k=1) ---
        decode_1byte(7'd31, 8'h60, 32'h40000000, "posit8 2.0");

        // --- Test 66: Posit8 4.0 (0x70, regime k=2) ---
        decode_1byte(7'd31, 8'h70, 32'h40800000, "posit8 4.0");

        // --- Test 67: Posit8 8.0 (0x78, regime k=3) ---
        decode_1byte(7'd31, 8'h78, 32'h41000000, "posit8 8.0");

        // --- Test 68: Posit8 16.0 (0x7C, regime k=4) ---
        decode_1byte(7'd31, 8'h7C, 32'h41800000, "posit8 16.0");

        // --- Test 69: Posit8 32.0 (0x7E, regime k=5) ---
        decode_1byte(7'd31, 8'h7E, 32'h42000000, "posit8 32.0");

        // --- Test 70: Posit8 max positive 64.0 (0x7F, regime k=6) ---
        decode_1byte(7'd31, 8'h7F, 32'h42800000, "posit8 64.0");

        // --- Test 71: Posit8 max negative -64.0 (0x81) ---
        decode_1byte(7'd31, 8'h81, 32'hC2800000, "posit8 -64.0");

        // --- Test 72: Posit8 smallest negative -1/64 (0xFF) ---
        decode_1byte(7'd31, 8'hFF, 32'hBC800000, "posit8 -1/64");

        // ===================== ROM golden validation =====================

        // --- Test 73: ROM BF16 (fmt_id=8) first 4 bytes golden check ---
        pre_err = errors;
        ui_in = {1'b0, 7'd8};
        @(posedge clk); #1;
        ui_in = 8'h00;
        @(posedge clk); #1;
        ui_in = 8'h80;
        check(8'h01, 8'h00, "rom8 byte0");
        @(posedge clk); #1;
        check(8'h08, 8'h00, "rom8 byte1");
        @(posedge clk); #1;
        check(8'h5A, 8'h00, "rom8 byte2");
        @(posedge clk); #1;
        check(8'h86, 8'h00, "rom8 byte3");
        if (errors == pre_err) $display("PASS: rom BF16 golden");
        repeat(8) begin @(posedge clk); #1; end

        // --- Test 74: ROM Posit8 (fmt_id=31) first 4 bytes golden check ---
        pre_err = errors;
        ui_in = {1'b0, 7'd31};
        @(posedge clk); #1;
        ui_in = 8'h00;
        @(posedge clk); #1;
        ui_in = 8'h80;
        check(8'h01, 8'h00, "rom31 byte0");
        @(posedge clk); #1;
        check(8'h10, 8'h00, "rom31 byte1");
        @(posedge clk); #1;
        check(8'hFF, 8'h00, "rom31 byte2");
        @(posedge clk); #1;
        check(8'hFF, 8'h00, "rom31 byte3");
        if (errors == pre_err) $display("PASS: rom Posit8 golden");
        repeat(8) begin @(posedge clk); #1; end

        // --- Test 75: ROM INT4 (fmt_id=46) first 4 bytes golden check ---
        pre_err = errors;
        ui_in = {1'b0, 7'd46};
        @(posedge clk); #1;
        ui_in = 8'h00;
        @(posedge clk); #1;
        ui_in = 8'h80;
        check(8'h07, 8'h00, "rom46 byte0");
        @(posedge clk); #1;
        check(8'h17, 8'h00, "rom46 byte1");
        @(posedge clk); #1;
        check(8'h37, 8'h00, "rom46 byte2");
        @(posedge clk); #1;
        check(8'h9E, 8'h00, "rom46 byte3");
        if (errors == pre_err) $display("PASS: rom INT4 golden");
        repeat(8) begin @(posedge clk); #1; end

        // ===================== Infrastructure tests =====================

        // --- Test 76: Reset re-entry (FSM recovery) ---
        ui_in = 8'h08;  // CMD1: BF16
        @(posedge clk); #1;
        rst_n = 0;       // Assert reset mid-CMD2
        @(posedge clk); @(posedge clk); #1;
        rst_n = 1;       // Release reset
        @(posedge clk); #1;
        // Verify FSM recovered: anchor probe should work
        ui_in = 8'h7F;
        #2;
        if (uo_out !== 8'hC0 || uio_out !== 8'h47) begin
            $display("FAIL: reset-recovery anchor uo=%02X uio=%02X", uo_out, uio_out);
            errors = errors + 1;
        end else begin
            $display("PASS: reset-recovery anchor = 0x47C0");
        end

        // --- Summary ---
        @(posedge clk);
        if (errors == 0)
            $display("GLS SMOKE: ALL PASS");
        else
            $display("GLS SMOKE: %0d FAILURES", errors);
        $finish;
    end

    initial begin
        $dumpfile("tb_gls_smoke.vcd");
        $dumpvars(0, tb_gls_smoke);
    end
endmodule
