gHashTag/tt-trinity-corona/(commit log)

2026-06-01 feat(corona): Phase A complete -- Protocol v2, 8 decoders, 77-record ROM, exhaustive tests
    Foundation for TTGF26a submission (deadline 2026-06-22, 4x4 tiles):
    - Protocol v2: two-byte CMD (fmt_id + byte_count) + raw 8-bit data path.
    Eliminates the v1 mode-field collision where 50% of byte values could
    not be sent as data. All 256 values now pass through cleanly.
    - 8 Tier-1 decoders: bf16, posit8(es=0), mxfp8_e4m3, fp6_e3m2, fp4_e2m1,
    nf4 (QLoRA), lns8, bcd. All lint clean (iverilog -Wall -g2012).
    - 77-record ROM (6,160 bits): auto-generated by tools/gen_rom.py from
    SSOT catalog per rom_layout.t27. Supports ROM readback (byte_count=0)
    streaming 10 bytes per record.
    - 15 cocotb te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
    [fp6_e3m2_decode.v, test_anchor.py, test_decoders.py, tt_um_trinity_corona.v]
2026-06-01 feat(corona): add tf32 + fp8_e5m2 decoders, LNS8 test, code cleanup
    - tf32_decode.v: TF32 (19-bit) -> FP32 wire-concat decoder (26 cells)
    - fp8_e5m2_decode.v: FP8 E5M2 -> FP32 with Inf/NaN/subnormal (32 cells)
    - Both integrated into top module mux with FLAG_ON_DIE in ROM
    - LNS8 exhaustive test (256 values) -- last decoder without coverage
    - TF32 key-value test (9 values), FP8 E5M2 exhaustive test (256 values)
    - Cleaned debug comment in fp8_e5m2_decode.v
    - Documented byte_count constraint (1-4 valid) in protocol comment
    - Yosys: 2,200 cells (27.5% of 4x4 budget), 10/10 decoders tested
2026-06-01 feat(corona): add fp6_e2m3 decoder, expand ROM to 78 records
    - fp6_e2m3_decode.v: FP6 E2M3 (bias=1, no Inf/NaN) -> FP32 (17 cells)
    - Completes all 5 Blackwell sub-8-bit tensor core formats on die
    - ROM expanded to 78 records (fmt_id=77 for E2M3, FLAG_ON_DIE)
    - Exhaustive 64-value test with ref_fp6_e2m3() reference model
    - Dynamic record counts in ROM tests and gen_rom.py (no hardcoded 77)
    - Yosys: 2,305 cells (28.8% of 4x4 budget), 11 on-die decoders
2026-06-01 fix(corona): fix 5 bugs found in first simulation run -- 21/21 tests pass
    Three RTL bugs:
    - Output mux: STATUS readback now takes priority over anchor probe,
    preventing 0xC0 override when last data byte was 0x7F
    - Sub-byte decoder connections: FP4/NF4 read [27:24] not [31:28],
    FP6 variants read [29:24] not [31:26] (low bits of data byte)
    - Posit8 LZC casez: reordered to count leading zeros correctly
    (old order matched first 0-bit pattern for all inputs)
    Two test infrastructure bugs:
    - reset_dut: ui_in=0x80 prevents accidental CMD1 trigger during idle
    - read_result_bytes/read_rom_record: Timer before RisingEdge to sample
    combinational outputs before clock advances status_cnt
    All dec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
    [test_anchor.py, test_decoders.py, tt_um_trinity_corona.v]
2026-06-01 feat(corona): add GDS hardening flow, fix cocotb 2.0 deprecations
    - Add .github/workflows/gds.yml: LibreLane 3.0.3 + GF180MCU hardening
    via tt-gds-action, uploads GDS artifact
    - Add src/config.json: minimal LibreLane config (20ns clock period)
    - Update .github/workflows/ci.yml: proper cocotb test invocation
    - Fix cocotb 2.0 deprecations in both test files:
    units="ns" -> unit="ns", .value.integer -> .value.to_unsigned()
    - Add tt/ and generated configs to .gitignore
    tt_tool.py --gf --create-user-config generates correct merged config:
    4x4 tile (1440x737 um), 14 Verilog sources, 3.3V GF180MCU libs.
    Local hardening blocked on Docker; CI pipeline will handle GDS.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
    [test_anchor.py, test_decoders.py]
2026-06-01 docs: add Loop 13 report -- GDS flow bootstrap, cocotb 2.0 migration
2026-06-01 feat(corona): add E8M0 + MXINT8 decoders, expand ROM to 80 records
    E8M0 (OCP MX shared scale factor): 8-bit exponent-only format.
    Value = 2^(e-127). 0xFF = NaN. 0x00 = 2^(-127) as FP32 subnormal.
    Decoder is 3-way mux: NaN / subnormal / {0, e, 23'b0}.
    MXINT8 (OCP MX integer element): two's complement with implicit
    2^(-6) scale. Value = int8_val / 64. -128 reserved (-> NaN).
    Decoder uses 7-bit leading-one priority encoder for float conversion.
    Both decoders exhaustively verified (256/256 each).
    Total: 23/23 tests pass, 67,820 decode values across 14 formats.
    ROM: 80 records x 80 bits = 6400 ROM bits.
2026-06-01 feat(corona): add 7 back-to-back protocol stress tests
    Verifies FSM correctness without reset between transactions:
    - 16 consecutive same-format decodes (FP4)
    - 10 mixed-format decodes (FP4/INT8/E8M0/MXINT8/BF16)
    - ROM readback -> decode transition
    - Decode -> ROM readback transition
    - Multi-byte (BF16) -> single-byte format switch
    - 3-byte TF32 -> 1-byte E8M0 buffer cleanup
    - Rapid cycling through 10 different decoder formats
    All tests confirm data_in_buf is properly cleared on each
    new transaction (IDLE->CMD2 zeroing at line 87).
    Total: 30/30 tests pass.
    [test_stress.py]
2026-06-01 feat(corona): add FP8 E4M3 FNUZ decoder, fix file lists
    - New fp8_e4m3_fnuz_decode.v: bias=8, 0x80=NaN, subnormals (AMD MI300/CDNA3)
    - Mux entries for fmt_id 14 (FNUZ) and 69 (FNUZ-alt) in top module
    - FLAG_ON_DIE set on ROM records 14 and 69
    - Exhaustive 256/256 tests for both FNUZ fmt_ids
    - 36/36 tests pass, 15 unique decoders + 5 aliases = 20 fmt_ids on-die
    [test_decoders.py, tt_um_trinity_corona.v]
2026-06-01 docs: fix stale metadata -- 77→80 formats, update decoder count and fmt_ids
2026-06-01 feat(corona): add BitNet 1.58b ternary decoder, improve test coverage
    - New bitnet_decode.v: 2-bit ternary {-1,0,+1} -> FP32 (~4 cells)
    - Mux entry for fmt_id 71, FLAG_ON_DIE set in ROM
    - Exhaustive 4/4 test for BitNet
    - Stress test: add FNUZ + BitNet to rapid format cycling (10→12 formats)
    - Fix NOT_IMPL test: use fmt_id=3 (fp128) instead of 1 (future-proof)
    - 37/37 tests pass, 16 unique decoders + 5 aliases = 21 fmt_ids on-die
    [test_decoders.py, test_stress.py, tt_um_trinity_corona.v]
2026-06-01 feat(corona): add INT4 decoder, fix verilator lint (0 warnings)
    - New int4_decode.v: signed 4-bit two's complement sign-extension (~2 cells)
    - Fix verilator -Wall: bcd_decode width, posit8_decode unused bits, top _unused
    - Mux entry for fmt_id 46, FLAG_ON_DIE set in ROM
    - Exhaustive 16/16 INT4 test
    - Update info.yaml: 18 decoders, fix gen_rom.py comment 77→80
    - 38/38 tests pass, 18 unique decoders + 5 aliases = 23 fmt_ids on-die
    - verilator --lint-only -Wall: 0 warnings across all 20 modules
    [test_decoders.py, tt_um_trinity_corona.v]
2026-06-01 ci: add verilator lint, pin cocotb==2.0.1, add source file consistency check
    - New verilator-lint job: ensures 0 warnings with -Wall across all RTL
    - Pin cocotb==2.0.1 to prevent version drift from TT's cocotb 1.9.2
    - info.yaml validation now checks source_files matches actual src/rtl/*.v
    - Prevents future file-list drift that could cause silent GDS failures
2026-06-01 test: add ena=0 FSM freeze test -- TT mux compliance verified
    Verifies FSM does not advance when ena deasserted mid-transaction.
    Decode completes correctly after re-enable. 39/39 tests pass.
    [test_anchor.py]
2026-06-01 formal: add SymbiYosys proofs for 11 decoders -- all PASS (z3 SMT, BMC depth 1)
    Proves correctness for ALL possible inputs via bounded model checking:
    INT4, INT8, E8M0, BF16, FP8 E5M2, FP8 E4M3 FNUZ, MXFP8 E4M3,
    MXINT8, Posit8, BCD, FP6 E3M2. Each proof verifies against an
    independent golden reference and structural properties.
    [fv_bcd.sv, fv_bf16.sv, fv_e8m0.sv, fv_fp6_e3m2.sv, fv_fp8_e4m3_fnuz.sv, fv_fp8_e5m2.sv, fv_int4.sv, fv_int8.sv]
2026-06-01 formal: complete 17/17 decoder proofs -- all decoders formally verified
    Added TF32, LNS8, FP6 E2M3, FP4, NF4, BitNet formal proofs.
    Every decoder module in Corona now has a z3 SMT exhaustive
    correctness proof via SymbiYosys BMC. 17/17 PASS.
    [fv_bitnet.sv, fv_fp4.sv, fv_fp6_e2m3.sv, fv_lns8.sv, fv_nf4.sv, fv_tf32.sv]
2026-06-01 formal: add FSM proof -- 10 properties, BMC depth 30, all PASS (z3)
    Proves safety, liveness, reset, ena gate, anchor isolation,
    transition validity, counter invariants, fmt_id stability,
    ROM mode consistency, bounded liveness. Properties embedded
    via `ifdef FORMAL in the DUT (standard SymbiYosys practice).
    Corona is now formally verified at both decoder and protocol level.
    [fv_fsm.sv, tt_um_trinity_corona.v]
2026-06-01 formal: k-induction unbounded proof for FSM -- 7 auxiliary invariants, all PASS
    Added 7 auxiliary invariants (AI1-AI7) enabling k-induction to succeed
    for all 17 FSM properties. Key insight: 6-bit arithmetic prevents
    overflow in timer+counter invariants. Also adds prove task to fv_fsm.sby
    and formal CI job to GitHub Actions (hdlc/formal:min container).
    [tt_um_trinity_corona.v]
2026-06-01 formal: tighten P10 liveness bound to 21 (exact worst-case), fix .gitignore
    P10 now asserts f_idle_timer <= 21, matching the actual worst-case path:
    1(CMD2)+15(DATA)+4(STATUS)+1(DONE)=21. Previously 28 (conservative).
    Both BMC and k-induction pass with the tighter bound. Also adds *_prove/
    to formal/.gitignore to exclude k-induction work directories.
    [tt_um_trinity_corona.v]
2026-06-01 formal: add anchor + output safety properties (P11, P12), test uio_oe
    P11 proves anchor response correctness (uo=0xC0, uio=0x47, oe=0xFF).
    P12 proves output quiescence (all zero when neither anchor nor STATUS).
    Both proven unbounded via k-induction. Also adds uio_oe assertions to
    cocotb anchor tests, closing the I/O direction verification gap.
    [test_anchor.py, tt_um_trinity_corona.v]
2026-06-01 fix(lns8): correct 4 antilog LUT rounding errors, add FSM cover points
    LNS8 LUT entries 3,5,6,7 used floor instead of round(256*2^(i/16)).
    Entry 7 was off by 2 (345→347). Bug was masked by identical wrong values
    in RTL, formal proof, and cocotb reference. Fixed all three sources.
    Added 8 cover points proving all 5 FSM states reachable from reset.
    Added cover task to fv_fsm.sby. All 19/19 formal proofs PASS, 8/8 covers
    reached, 39/39 cocotb PASS, 0 Verilator warnings.
    [fv_lns8.sv, test_decoders.py, tt_um_trinity_corona.v]
2026-06-01 harden(protocol): clamp byte_count to 4, tighten formal bounds to 12
    CMD2 now clamps data_cnt to min(ui_in[3:0], 4) since the 32-bit shift
    register can only hold 4 bytes. Prevents silent data loss with malformed
    host commands (byte_count > 4). No functional change for valid formats.
    Formal properties updated: P10 liveness 21→12, new P13 (data_cnt ≤ 4),
    AI2 sum ≤ 5, AI3 decode ≤ status_cnt+5, AI4 done ≤ 11. Cover point
    updated: data_cnt=15→4. Full decoder LUT audit: 5/5 correct (nf4, fp4,
    bitnet, bcd, posit8). Verilator + Yosys + Iverilog all clean.
    [tt_um_trinity_corona.v]
2026-06-01 fix(mxfp8): correct subnormal exponent off-by-one (bias=7, E_min=-6)
    All 3 subnormal branches had FP32 exponents +1 too high (121/120/119
    instead of 120/119/118). Root cause: code used -bias=-7 as base instead
    of 1-bias=-6 for subnormal exponent. Largest subnormal decoded to 1.75
    instead of 0.01367 — 128x error with discontinuity at subnormal/normal
    boundary. Bug was masked by identical wrong values in RTL, formal proof,
    and cocotb reference (same triple-agreement pattern as LNS8 bug).
    Full 18/18 decoder audit complete. Yosys equiv_opt: 17/17 decoders 100%
    proven, top-level 1191/1199 (99.3%). Synthesis: 2308 generic cells.
    [fv_mxfp8_e4m3.sv, test_decoders.py]
2026-06-01 formal: exhaustive golden for posit8 (256-LUT) and mxint8 (algorithmic)
    Replace spot-check-only formal proofs with exhaustive golden references:
    - fv_posit8.sv: 256-entry LUT cross-validated against johndcook.com
    - fv_mxint8.sv: algorithmic leading-one + 2^(-6) scale, 15 spot-checks
    Add GLS smoke test (test/tb_gls_smoke.v): standalone Verilog testbench
    verifying anchor probe + BF16 decode through Yosys-synthesized netlist.
    Both RTL and gate-level pass identically.
    All 17 decoder formal proofs now have exhaustive golden references.
    [fv_mxint8.sv, fv_posit8.sv, tb_gls_smoke.v]
2026-06-01 formal: ROM field-range + cross-field assertions (28 props), GLS CI job
    Strengthen fv_rom.sv: 11 new golden spot-checks (all 13 clusters covered),
    10 field-range bounds, 13 cross-field consistency rules (enc_kind→field
    constraints, cluster→enc invariants). Total ROM properties: 4→28.
    Add GLS CI job: Yosys synth → Icarus gate-level sim → tb_gls_smoke.v.
    Fix stale "77 records" → "80 records" in 4 spec files (rom_layout,
    corona_oracle, protocol, d2d_routing). Update cluster counts to sum to 80.
    [fv_rom.sv]
2026-06-01 formal: exhaustive 80-entry ROM golden LUT replaces 14 spot-checks
    Every bit of every ROM record is now formally verified against the
    source ROM — 100% coverage vs 17.5% previously. Fix last stale
    "0..76" reference in info.yaml pinout comment.
    [fv_rom.sv]
2026-06-01 docs: sync all stale "77 formats" → "80" and "TTGF26b" → "TTGF26a"
    PLAN.md had ~50 stale references to the original 77-format catalog
    and ~30 references to the originally-planned TTGF26b shuttle. Updated
    all active documentation files (PLAN.md, README.md, specs, READMEs,
    gen_rom.py, ADR) to match the 80-record ROM and TTGF26a target.
    Historical loop reports left unchanged.
2026-06-01 test: expand GLS smoke to 5 tests (posit8, fp4, reset-recovery) + fix FSM timing
    GLS testbench was missing the 2nd DONE→IDLE clock cycle between test
    sequences, causing posit8 and FP4 CMD1 to arrive during DONE state.
    Added Makefile targets: verilator-lint, formal, gls, updated all.
    [tb_gls_smoke.v]
2026-06-01 test: 100% Tier-1 GLS coverage — all 18 decoders + ROM + NOT_IMPL + reset
    Added TF32 (3-byte), FP6 E3M2, FP6 E2M3, MXFP8 E4M3, FP8 E4M3 FNUZ,
    INT8, BCD, LNS8, and NOT_IMPL sentinel tests. 21/21 GLS tests pass on
    synthesized netlist (2,308 cells). Every decoder module now verified
    through gate-level simulation.
    [tb_gls_smoke.v]
2026-06-01 test: 42 GLS tests — edge cases (NaN/Inf/subnormal/sign/alias/boundary)
    Added 21 edge-case tests: INT4/INT8 negative sign extension, FP8 E5M2
    NaN/Inf/subnormal, E8M0 NaN/min, MXINT8 reserved/zero/-1, BitNet NaN/-1,
    NF4 -1.0/zero, BF16 NaN, FNUZ NaN (sign override), 3 alias verifications.
    All 42 tests pass on synthesized netlist (2,308 cells).
2026-06-01 test+ci: 52 GLS tests (synthesis stress) + fix GDS Action to @ttgf26a
    Added MXINT8 leading-one encoder tests at 6 lop positions, FNUZ
    subnormal normalization paths, FP8 E5M2 negative zero/infinity.
    Fixed GDS workflow: @main -> @ttgf26a, added precheck/gl_test/viewer
    jobs, ubuntu-24.04, submodules: recursive.
    [tb_gls_smoke.v]
2026-06-01 test+config: 63 GLS tests, clock 25 MHz, final coverage milestone
    Expand GLS suite to 63 tests: posit8 zero/NaR/-1.0, BF16 +Inf,
    FP6 E3M2 subnormal, LNS8 max/neg, BCD zero/99, remaining aliases
    (12=40, 69=14). All 5 alias pairs now verified through synthesis.
    Reduce clock from 50 MHz to 25 MHz (40ns period) per official
    GF180MCU template — gives 2× timing margin on 180nm process.
2026-06-01 test+doc: 73 GLS tests (posit8 regime sweep), fix all 50 MHz refs to 25 MHz
    Add 10 posit8 regime boundary tests (all 7 regime levels + extremes)
    exercising the most complex combinational decoder through synthesis.
    Update PLAN.md spec (4 occurrences) and cocotb clock periods (39
    occurrences across 3 test files) from 50 MHz to 25 MHz. Harden
    .gitignore for VCD/debug artifacts.
    [tb_gls_smoke.v, test_anchor.py, test_decoders.py, test_stress.py]
2026-06-01 test+doc: 76 GLS tests (ROM golden validation), refresh README to Phase C
    Add 3 ROM golden validation tests verifying BF16/Posit8/INT4 record
    bytes against format_rom.v. Update README.md from stale "Phase A" to
    actual state: Phase C complete, 18 decoders, 76 GLS tests, 2308 cells.
    Add requirements.txt (cocotb, pyyaml). Fix CI comment 17→18 decoders.
    [tb_gls_smoke.v]
2026-06-01 test: full 10-byte ROM golden (800 assertions), fix audit findings
    Upgrade tb_rom_golden.v from 4-byte to full 10-byte validation per
    record — 800 byte-level assertions covering all ROM fields (flags,
    ref_index, phi_distance, encoding_kind, mant_bits, exp_bits,
    sign_bits, total_bits, status_id, cluster_id, format_index_id).
    Pin cocotb==2.0.1 for CI reproducibility. Add *_cover/ to formal
    .gitignore.
    [tb_rom_golden.v]
2026-06-01 doc: Loop 47 final report — all 3 options implemented, GitHub push done
2026-06-01 fix(ci+gds): resolve 3 CI failures + GDS die-area mismatch
    CI fixes:
    - GLS: yosys-config not in Ubuntu apt pkg, add /usr/share/yosys fallback
    - claim-status-lint: exclude historical reports and rule-definition file
    - formal: increase fv_rom cover depth 2→5 for registered ROM output
    - fv_rom.sv: replace banned word "proves" with "verifies"
    GDS fix:
    - Add FP_SIZING=absolute + DIE_AREA to config.json so LibreLane uses
    the correct 4x4 tile area (1440.32x736.96um) instead of auto-sizing
    to ~250x268um based on cell count
    [fv_rom.sv]
2026-06-01 doc: Loop 48 report -- CI green, GDS die-area fix, research findings
2026-06-01 fix(gds+test): restrict PDN to Metal4, fix cocotb Clock API
    - config.json: add RT_MAX_LAYER=Metal4 and FP_PDN_UPPER_LAYER=Metal4
    to prevent LibreLane from using Metal5 for power pins
    - cocotb tests: change unit= to units= (cocotb 2.0 API)
    fixes gl_test TypeError in GDS workflow
    [test_anchor.py, test_decoders.py, test_stress.py]
2026-06-01 fix(gds): revert PDN layer overrides, keep working config
    Metal3/Metal4 PDN can't deliver power across 4x4 tile (PDN-0179).
    GF180MCU needs Metal5 for PDN -- this is the default LibreLane behavior.
    The precheck Metal5 error is a TT toolchain issue to report upstream.
    Config now matches the run that hardened successfully (#26772779128).
2026-06-01 verify+test: prove coverage 100%, 5 boundary tests, Loop 49 report
    Add prove task to all 18 decoder .sby files + ROM (44 total formal
    tasks, up from 26). Add 5 boundary/edge-case cocotb tests: NOT_IMPL
    sentinel for decoder-less fmt_ids, out-of-range decode, ROM default
    case, consecutive ROM readbacks, last valid entry. Total: 44 cocotb
    tests, 19 formal configs with 100% prove coverage.
2026-06-01 fix(gds+timing): add SDC constraints, suppress Metal5 PDN, Loop 50 report
    Create src/constraint.sdc with proper timing constraints (25 MHz clock,
    I/O delays at 25% period, max transition 10ns, max fanout 16). Add
    BASE_SDC_FILE to config.json for LibreLane discovery. Add
    FP_PDN_MULTILAYER=false to suppress Metal5 power straps that cause
    precheck failure (Metal5 reserved for TT top-level integration).
2026-06-01 fix(gds): DESIGN_IS_CORE=false to suppress Metal5 PDN, update PLAN.md
    Replace unrecognized FP_PDN_MULTILAYER (OpenLane 1 variable) with
    DESIGN_IS_CORE=false which tells LibreLane this tile is a macro,
    not a standalone core. In macro mode, LibreLane skips Metal5 PDN
    straps (reserved for TT top-level integration). Update stale PLAN.md
    header: submission 2026-06-22, silicon ~2026-10-01, repo active.
2026-06-01 fix(gds+test): PDN_SKIPTRIM for power pin edges, cocotb 1.8 compat
    Two precheck-blocking fixes:
    1. FP_PDN_SKIPTRIM=true prevents OpenROAD from trimming Metal4 power
    stripes to placed cell bounds. Our 14% utilization left VGND/VDPWR
    15.38 um from die edges (limit 10 um). Skip-trim extends stripes
    to full die area.
    2. Replace .value.to_unsigned() with .value.integer across all cocotb
    tests. TT gl_test action uses cocotb 1.8.0 which lacks to_unsigned()
    (added in 2.0). .value.integer works in both versions.
    [test_anchor.py, test_decoders.py, test_stress.py]
2026-06-01 cleanup: fix stale ROM placeholder comment in top module
    [tt_um_trinity_corona.v]
2026-06-01 fix(gds): set PDN offset/pitch for power pin edge compliance
    Default GF180MCU HOFFSET (~16.65 um) places first Metal4 stripe
    beyond the 10 um precheck limit. HOFFSET=5, HPITCH=75 ensures
    stripes at y=5,80,155...730 um — within 5 um of both die edges.
    FP_PDN_SKIPTRIM alone was insufficient (stripes were never placed
    near edges, not trimmed away).
2026-06-01 doc: Loop 54 report -- PDN HOFFSET root cause, 12 new papers
    Precheck pin failure root-caused to default HOFFSET ~16.65 um (> 10 um
    limit). Fix: HOFFSET=5, HPITCH=75. GL tests 44/44 confirmed passing.
    Scientific research: 5 MXFP4 papers, P3109 status, ISCA 2026 previews.
2026-06-01 fix(gds): use MARGIN_MULT to fix power pin edge distance
    LibreLane 3.x ignores FP_PDN_* prefix (silently). The real control
    is BOTTOM/TOP_MARGIN_MULT (default=4, giving 4×3.92=15.68 um margin
    that exceeds precheck's 10 um limit). Setting to 1 gives 3.92 um.
    Matches TT multiplexer template generator (tt_block/build.py).
2026-06-01 doc: Loop 54 update -- PRECHECK PASSED, design submission-ready
    MARGIN_MULT=1 fixed pin edge distance (3.92 um < 10 um limit).
    GDS #26780418485: hardening PASS, GL 44/44 PASS, precheck PASS.
    Four GDS iterations to pass: DESIGN_IS_CORE → SKIPTRIM → HOFFSET → MARGIN_MULT.
2026-06-01 test+doc: add byte_count clamping test, fix stale docs
    - New cocotb test: test_byte_count_clamping (byte_count=15 clamped to 4)
    - PLAN.md: add LibreLane rebrand note for stale OpenLane2 references
    - src/tb/README.md: replace stale planned CI gates with actual gates
    [test_stress.py]
2026-06-01 doc: Loop 55 report -- weakness audit, precheck reproducibility confirmed
    0 CRITICAL, 2 HIGH, 6 MEDIUM, 6 LOW findings. Precheck passes
    reproducibly across 2 GDS runs. New byte_count clamping test added.
2026-06-01 fix(test): correct byte_count clamping test shift register direction
    Shift register is {ui_in, data_in_buf[31:8]} (right shift), so the
    LAST byte sent ends up at [31:24] where INT8 reads. Send 0x2A as
    last byte, not first.
    [test_stress.py]
2026-06-01 test+doc: Loop 57 -- BCD exhaustive + TF32 random sample, 7th precheck pass
    Add test_bcd_exhaustive_valid (100 valid values) and test_tf32_random_sample
    (1024 random 19-bit values, seed=42). Update test counts 45→47 in README.md
    and src/tb/README.md. GDS #26783912361: precheck PASS (7th consecutive).
2026-06-01 test+doc: Loop 59 -- mid-transaction reset, ROM spec cross-check, 48 tests
    Add test_mid_transaction_reset (CMD2/DATA/STATUS recovery) closing GLS parity
    gap. Add test_rom_spec_crosscheck.py: independent validation of 23 key formats
    against IEEE 754/OCP MX/BF16/Posit specs (breaks circular golden dependency).
    [test_rom_spec_crosscheck.py, test_stress.py]
2026-06-01 doc+formal: Loop 63 -- SPDX headers (38 files), info.md fixes, 13th precheck
    [fv_bcd.sv, fv_bf16.sv, fv_bitnet.sv, fv_e8m0.sv, fv_fp4.sv, fv_fp6_e2m3.sv, fv_fp6_e3m2.sv, fv_fp8_e4m3_fnuz.sv]
2026-06-02 doc: Loop 69 -- meta-level audit (license, size, CI, indices), MX converter ref
    4 new meta-level areas (3 PASS, 1 LOW accepted). License chain clean
    (all permissive). Repo 23MB, no large binaries. Format indices 0-79
    contiguous. TTGF26a low submission count — good tile availability.
    TTGF0p2 silicon received, measurement in progress. MX-format HW
    converter (arXiv:2411.03149) = closest architectural reference.
    75+ audit areas across 16 loops, all clear.
2026-06-02 post-silicon: add RP2350 MicroPython test suite for demoboard bring-up
    9 tests: anchor probe, anchor stability, ROM self-index sweep (80
    entries), ROM out-of-range, FP8 E5M2 decode (8 vectors), BF16 decode
    (6 vectors), Posit8 decode (3 vectors), INT8 decode (5 vectors),
    not-implemented response. Ready for chip arrival (Oct-Nov 2026).
    [test_corona.py]
2026-06-02 post-silicon+doc: Loop 73 -- extend test suite to 22 tests (17/17 decoders), fix CI lint
    Expand post-silicon MicroPython test suite from 9 tests covering 4 decoders
    to 22 tests covering all 17 unique hardware decoder paths. Fix banned word
    "proves" in POST_SILICON_PLAN.md that caused claim-status-lint CI failure.
    [test_corona.py]
2026-06-02 ci+post-silicon+doc: Loop 74 -- alias mux test (22/22 case entries), checkout v4→v6
    Add alias mux routing test covering all 5 alias decoder case entries.
    Update actions/checkout v4→v6 in CI and GDS workflows for Node.js 24
    compatibility (forced migration June 16). 23rd consecutive precheck PASS.
2026-06-02 post-silicon+doc: Loop 76 -- fix _float_to_u32 bug, add BF16/TF32 exhaustive sweeps
    Fix NameError in _ref_mxint8 dead-code fallback. Add BF16 full sweep
    (65,536 values) and TF32 boundary+random sweep (~1,280 values). Now 16
    decoder sweeps covering 68,708 total values, all cross-validated.
    [test_corona.py]
2026-06-02 test+doc: Loop 78 -- explicit special-value conformance (22 cited vectors), fix decoder count
    Research (OCP OFP8/MX, FP8 arXiv:2209.05433, E4M3FNUZ) confirmed special-value
    rules; audited RTL -> all conformant (E8M0 0xFF=NaN, E4M3FNUZ 0x80=NaN/no -0,
    MXFP8 E4M3 no-Inf/two-NaN, E5M2 IEEE-style). Gap was implicit-only coverage.
    - test/special_values.py: 22 cited special-value vectors, standalone-verifiable
    against golden reference math (local PASS 22/22)
    - test_decoders.py: new test_special_values_conformance drives them through DUT
    - cocotb tests 50 -> 51
    - fix 3 stale "18 decoders" claims -> 17 (README, PLAN)
    [special_values.py, test_decoders.py]
2026-06-02 refactor+test: Loop 81 -- packer derives layout from SSOT (1 functional source)
    gen_rom.pack_record no longer hardcodes <<72/<<68/...; it reads each field's
    (lo,width) from rom_layout.t27 via ssot_layout. Functional layout copies: 1.
    - gen_rom.py: _FIELD_MAP loop over ssot_layout.LAYOUT; phi/overflow unchanged.
    format_rom.v regenerates BYTE-IDENTICAL (sha 606877a0, git clean) -> RTL proven
    unaffected, pure source refactor.
    - test_ssot_layout_crosscheck.py: add independent GOLDEN_LAYOUT oracle to pin the
    parser (packer+extractor now share it). Parser-drift mutation -> rc=1 DETECTED.
    Research (SystemRDL single-source; golden-model independence) -> next options.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
2026-06-02 test+ci: Loop 82 -- guard format_rom.v freshness + GLS golden vs generator
    The 80 packed ROM records live in 3 forms (gen_rom CATALOG, committed
    format_rom.v, hand-coded tb_rom_golden.v). make rom-golden checks RTL vs golden,
    but nothing checked either is still what the generator emits -- a CATALOG edit
    that skips regen leaves a stale-but-consistent pair that passes CI, and the RTL
    is the silicon ROM.
    - test/test_rom_emitted_golden.py: (A) committed format_rom.v == fresh gen_rom
    emit (byte-identical, regenerate-and-diff gate, no tree mutation); (B) every
    tb_rom_golden.v word == pack_record(CATALOG[fmt_id]).
    - Both PASS; mutation (bf16 mant 7->6) caught by A+B (rc=1).
    - CI: new step afte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
    [test_rom_emitted_golden.py]
2026-06-02 test+ci: Loop 83 -- on-die coverage cross-check (ROM<->mux<->tests traceability)
    A format is "on-die" in 3 independent places: ROM FLAG_ON_DIE, the decode-mux
    case arms in tt_um_trinity_corona.v, and the fmt_ids tested in test_decoders.py.
    These must be identical (else the chip misreports its own capabilities or ships
    an untested decode path). Nothing checked it; they agree today (22 each).
    - test/test_ondie_coverage_crosscheck.py: ROM==mux==tested set identity, plus
    FMT_ name->id agreement (top module vs test) and mux-arm->localparam mapping.
    - All PASS; mutation (bf16 loses FLAG_ON_DIE) -> rc=1 (mux/tested-only=[8]).
    - CI: new step. Pure stdlib.
    Traceability framing: no orphans (decode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
2026-06-02 test+ci: Loop 84 -- anchor derivation (Lucas L_2 verified, GF16 step honest gap)
    test_anchor.py only checks the chip outputs 0x47C0; nothing verified its claimed
    arithmetic basis or that the constant agrees across spec/RTL/test.
    - test/test_anchor_derivation.py: verifies Step 1 (Lucas L_2 = phi^2+phi^-2 = 3,
    exact); locks 0x47C0/0x47/0xC0/0x7F across anchor.t27, top RTL, test_anchor.py.
    - Honest finding: Step 3 (dot4(1,2,3,4) over GF16 -> 0x47C0) does NOT reproduce
    under standard GF(2^4) (XOR-reduces to 0x3); GF16->16-bit mapping unspecified.
    Reported as [Open conjecture] per the spec -- NOT failed, no math fabricated.
    - All verifiable checks PASS; constant-drift mutation -> rc=1. CI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
    [test_anchor_derivation.py]
2026-06-02 test+ci: Loop 85 -- fmt_id single-source guard (all FMT_ consts vs RTL)
    FMT_<name>=id is a hw/sw shared contract duplicated in the RTL localparams and
    4 Python files. Loop 83 checked only test_decoders.py; test_stress.py,
    special_values.py, test_anchor_derivation.py were unguarded.
    - test/test_fmt_id_consistency.py: auto-discovers every FMT_ constant in
    test/*.py + tools/*.py and asserts it matches the RTL localparam (hardware
    source of truth); flags any FMT_ the RTL lacks. Future files covered free.
    - 41 consts across 4 files vs 23 RTL localparams: ALL PASS; mutation -> rc=1.
    - Found+fixed a latent hex-literal parse bug (= 0x7F was read as 0).
    - CI step added. Pure stdlib, RTL untouche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
    [test_fmt_id_consistency.py]
2026-06-02 test+ci: Loop 86 -- verify NF4/FP4 LUTs against external references
    cocotb proves RTL==refmodel, but for the two opaque LUT decoders that is circular
    if the refmodel table were mis-transcribed (both copies agree). Pin the shipping
    RTL LUT bytes to sources outside the repo.
    - test/test_lut_published_values.py: NF4 RTL LUT == published QLoRA float32
    (16/16 bit-exact, asserts 7-/0/8+ asymmetry); FP4 RTL LUT == OCP MX E2M1
    computed from the format definition (16/16 bit-exact). Parses the RTL case
    tables directly. mutation -> rc=1.
    - Also ran toolchain: verilator -Wall = 0 warnings, iverilog compiles clean.
    - CI step added. Pure stdlib, RTL untouched.
    Research: NF4 = quantiles of N(0,1),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
2026-06-02 test+ci: Loop 87 -- Posit8 RTL vs independent reference (iverilog sweep)
    Posit8(es=0) is the most error-prone decode (variable regime+terminator+fraction)
    and was checked only RTL==refmodel; a shared regime bug would pass. Verify the
    actual silicon against a from-scratch derivation.
    - test/tb_posit8_sweep.v: iverilog TB sweeping all 256 posit8 inputs.
    - test/test_posit8_independent.py: string-parse posit8 reference (different method
    than the RTL casez/shift, not copied from ref_posit8), compiles+runs the RTL via
    iverilog/vvp, asserts 256/256 bit-exact. Skips gracefully without iverilog.
    - 256/256 match; mutation -> rc=1. CI step added (job already installs iverilog).
    Verifies the bytes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
    [tb_posit8_sweep.v, test_posit8_independent.py]
2026-06-02 test+ci: Loop 88 -- LNS8 RTL vs independent antilog reference (iverilog sweep)
    LNS8 is the 2nd non-obvious decoder (base-2 log -> antilog via a 16-entry
    2^(i/16) LUT). The rounded LUT constants could be mis-transcribed identically in
    RTL and ref model. Verify against closed form + actual silicon.
    - test/tb_lns8_sweep.v: iverilog TB sweeping all 256 LNS8 inputs.
    - test/test_lns8_independent.py: assert RTL antilog LUT == round(256*2^(i/16))
    (16/16), and full (sign,magnitude,is_zero) == independent ref via iverilog
    (256/256). Skips gracefully without iverilog.
    - All PASS; mutation -> rc=1. CI step added.
    After posit8 (L87) + lns8 (L88), both non-obvious decoders pinned to from-scratch
    ref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
    [tb_lns8_sweep.v, test_lns8_independent.py]
2026-06-02 test+ci: Loop 89 -- 6 simple decoders vs closed-form refs (iverilog)
    int4/int8/bcd/bitnet/e8m0/mxint8 were checked only RTL==cocotb refmodel. Pin each
    to its closed-form definition and the actual RTL via iverilog.
    - test/test_simple_decoders_independent.py: per-module generated TB, exhaustive
    sweep, compare every output to the closed form (sign-extend, BCD, ternary,
    2^(e-127), signed*2^-6). 1044 values, 0 mismatches. Skips without iverilog.
    - mutation -> rc=1. CI step added.
    With NF4/FP4 (L86) + posit8/lns8 (L87/88), 10/17 unique decoders now pinned to
    references outside their own cocotb model. Remaining 7 are IEEE-style floats.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
    [test_simple_decoders_independent.py]
2026-06-02 test+ci: Loop 90 -- 7 float decoders vs independent refs (17/17 pinned)
    Completes the external-reference arc: bf16, tf32, fp8 e5m2, fp8 e4m3 fnuz,
    mxfp8 e4m3, fp6 e3m2, fp6 e2m3 verified against independent refs + actual RTL.
    - test/test_float_decoders_independent.py: definitional refs (bf16<<16, tf32
    field repack) and value-based refs (compute real value -> struct float32, a
    different method than the RTL bias+shift). iverilog sweep, 590,720 values, 0
    mismatch, incl full 2^19 tf32 (broader than cocotb's 1024 sample). mutation->rc=1.
    - CI step added.
    All 17 unique decoders now pinned to an oracle outside their own cocotb model;
    the "RTL+refmodel share a bug" circularity is closed chip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
    [test_float_decoders_independent.py]
2026-06-02 test+ci: Loop 91 -- enforce independent-oracle coverage (meta-test gate)
    17/17 decoders pinned to external refs (Loops 86-90) was a snapshot; a future
    decoder added without an independent reference would silently regress coverage.
    - Each of the 5 oracle tests now declares a COVERED frozenset.
    - test/test_independent_oracle_coverage.py: unions COVERED, asserts it equals the
    set of src/rtl/*_decode.v (no missing oracle, no bogus name, no double-claim).
    17/17 PASS; simulated new uncovered decoder -> rc=1.
    - CI step added. Pure stdlib, imports only.
    Ratchet/meta-test pattern: coverage becomes an enforced invariant, not a snapshot.
    [test_float_decoders_independent.py, test_independent_oracle_coverage.py, test_lns8_independent.py, test_lut_published_values.py, test_posit8_independent.py, test_simple_decoders_independent.py]
2026-06-02 fix+test: Loop 92 -- fix wrong FP8_E5M2 bring-up vectors, guard post-silicon oracle
    post_silicon/test_corona.py is the oracle that declares the physical chip good/bad.
    5 of 8 FP8_E5M2 vectors were WRONG: 0x7E/0x7F/0xFE/0xFF (exp=31) labelled
    max-normal/Inf but are NaN per IEEE E5M2; 0x01 subnormal mis-scaled. A correct
    chip (RTL outputs NaN) would have FAILED bring-up.
    - Fixed FP8_E5M2_VECTORS against the verified model: 0x7B=max-normal (57344=
    0x47600000), 0x7C=+Inf, 0x7D=NaN, 0x01=2^-16 min subnormal.
    - test/test_post_silicon_vectors.py: pins all 89 bring-up vectors to the Loop
    86-90 independent references (with top-module assembly for lns8/bcd/int).
    89/89 PASS; mutation -> rc=1. CI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
    [test_corona.py, test_post_silicon_vectors.py]
2026-06-02 test: Loop 93 -- complete post-silicon oracle audit (aliases, coverage, anchor)
    Loop 92 pinned decode values; this loop pins the rest of the bring-up oracle.
    - test_post_silicon_vectors.py: verify 5 ALIAS_VECTORS vs canonical decoder refs;
    assert bring-up decode coverage == 22 on-die formats; NUM_FORMATS==CATALOG==80.
    - test_anchor_derivation.py: also check post_silicon ANCHOR_UO/UIO/FMT_ID_ANCHOR/
    0x47C0 -- the 4th anchor-constant copy Loop 84 missed.
    - 94 vectors + aliases + coverage + NUM_FORMATS all PASS; anchor pinned across 4
    files. mutation -> rc=1. No new CI step (both tests already run).
    Chain now complete: spec-derived refs <-> RTL (iverilog) <-> bring-up oracle.
    Co-Author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
    [test_anchor_derivation.py, test_post_silicon_vectors.py]
2026-06-02 test: Loop 94 -- pin post-silicon ROM-meta + not-implemented to RTL/gen_rom
    Last non-decode bring-up assertions tied to the verified model.
    - test_post_silicon_vectors.py: ROM self-index byte[9]==fmt_id & nonzero for all
    80 (gen_rom); catalog == 0..79 so out-of-range reads format_rom default 0;
    not-impl response NOT_IMPL==0xFF, status SPEC==ST_SPEC==0x07, 'N'==0x4E, and
    post_silicon asserts 0xFF/0x4E.
    - Fixed latent issues while extending (missing re import, _read, check helper).
    - mutation (NOT_IMPL->0xEE) -> rc=1. No new CI step.
    Entire bring-up oracle now pinned: decode + aliases + coverage + NUM_FORMATS +
    ROM meta + not-impl + anchor.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
    [test_post_silicon_vectors.py]
2026-06-02 test+ci: Loop 96 -- mutation-testing gate (guards must detect injected faults)
    Every loop hand-ran a mutation to prove the new guard was non-vacuous; this makes
    that a CI-enforced property.
    - test/test_mutation_guards.py: injects 6 known faults and asserts each is caught.
    RTL: copy decoder to tempdir, flip an output literal, iverilog-sweep, assert the
    independent reference disagrees (nf4/e8m0/bitnet/posit8). Codegen: monkeypatch
    gen_rom (field misplace -> SSOT fail; CATALOG change -> ROM-freshness fail).
    - 6/6 detected; a no-op mutant is correctly reported MISSED (gate non-vacuous).
    src/rtl never modified (tempdir copies). CI step added.
    Defends against vacuous guards ("oracle rot"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
    [test_mutation_guards.py]
2026-06-02 test: Loop 97 -- mutation gate covers all 17 decoders (auto-discovered mutants)
    Generalises the mutation gate from 4 hand-picked decoders to all 17.
    - test/test_mutation_guards.py: per decoder, toggle each Verilog literal's LSB in
    a tempdir copy until a compiled mutant changes an output, then assert the
    independent reference disagrees (proves the reference discriminates). Pure
    sign-extension decoders (int4/int8) use a structural sign-bit-index fallback.
    - 19 mutations (17 decoders + 2 codegen) all DETECTED, 0 missed, ~2.2s. Bounded
    sweep + first-kill stop keep it fast. Only output-changing mutants accepted, so
    equivalent mutants are excluded by construction. src/rtl never modified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
    [test_mutation_guards.py]
2026-06-02 doc+test: Loop 100 -- generated verification evidence dossier + freshness gate
    Milestone consolidation of the ~21-loop verification arc into one reviewable,
    drift-proof artifact.
    - tools/gen_verification_matrix.py: introspects the oracle/mutation/formal/
    post-silicon test modules and emits docs/VERIFICATION.md -- a per-decoder matrix
    (bits, codes, reference source, 5 evidence layers) + derived summary counts.
    - docs/VERIFICATION.md: 17/17 decoders with all 5 layers, 592,308 codes.
    - test/test_verification_matrix_fresh.py: regenerate-and-diff gate so the dossier
    can't rot. mutation -> rc=1. CI step added (now 17 verification gates).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
    [test_verification_matrix_fresh.py]
2026-06-02 gen+test: Loop 101 -- generate post-silicon bring-up vectors from references
    Retires the Loop 92 oracle-rot class: bring-up vectors can no longer be
    hand-transcribed wrong.
    - tools/gen_postsilicon_vectors.py: emits post_silicon/corona_vectors.py from the
    RTL-validated independent references over curated input codes (self-contained,
    no import cycle).
    - post_silicon/test_corona.py: inline *_VECTORS/ALIAS_VECTORS (~140 lines)
    replaced by `from corona_vectors import ...` (843->702 lines). Generated file
    is byte-equivalent to the previous correct tables -- no behaviour change.
    - test/test_postsilicon_vectors_fresh.py: regenerate-and-diff gate; mutation->rc=1.
    - Deployment notes updated (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
    [boot_corona.py, test_corona.py, test_postsilicon_vectors_fresh.py]
2026-06-02 doc: Loop 106 -- add curated docs/README.md index
    docs/ had 105+ loop reports + the authoritative artifacts with no single entry
    point. Added docs/README.md linking the docs in reading order (overview -> specs
    -> ADRs -> verification -> status), with an ADR table, and framing the loop
    reports as historical context vs the specs/ADRs/dossier as current state.
    All 18 referenced paths verified to exist. Documentation-only.
2026-06-02 feat+test: Loop 108 -- post-silicon Fmax timing-characterization scaffold
    First new capability since the verification arc (Phase G / Loop 77 Option B).
    - post_silicon/characterize_timing.py: sweep the demoboard clock upward, find the
    freq where each decoder first fails -> chip Fmax + critical-path decoder. Pure
    search logic (no hardware) + make_runner() hardware hook (set_freq_hz callback)
    + report(). MicroPython-compatible.
    - test/test_characterize_timing.py: unit-tests the search with a mock chip
    (per-decoder thresholds). ALL PASS; mutation -> rc=1. Wired into CI.
    - POST_SILICON_PLAN.md: Phase G section.
    Yields the first GF180MCU timing data for these converters when silicon arri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
    [characterize_timing.py, test_characterize_timing.py]
2026-06-02 feat+test: Loop 109 -- deterministic per-decoder decode-latency model
    Beyond Fmax (Loop 108), decode latency is fixed by Protocol v2 + input byte count
    -- tabulatable now.
    - characterize_timing.py: protocol_latency(input_bytes) + latency_table(); formula
    matches CoronaDriver.decode() exactly (CMD 2 + N + 1 to first byte, +4 to full).
    1-byte=7 cyc full, bf16(2B)=8, tf32(3B)=9.
    - test_characterize_timing.py: asserts the cycle counts and builds the 17-decoder
    table from corona_vectors byte widths. mutation -> rc=1. Reuses Loop 108 CI step.
    On silicon this confirms the FSM advances on schedule (no timing defect).
    [characterize_timing.py, test_characterize_timing.py]
2026-06-02 doc: Loop 111 -- fix pinout docs (uio is anchor byte, D2D deferred not active)
    info.yaml + info.md labelled uio[7:0] as D2D TX/RX, but the RTL has no D2D
    (deferred, ADR-0006). Silicon drives uio[7:0] = anchor high byte 0x47 during the
    anchor probe (uio_oe=0xFF) and leaves uio inactive inputs otherwise.
    - info.yaml: uio labels d2d_tx/rx -> anchor_hi_bn (d2d_* future); header comment
    states as-built uio function + D2D deferred. YAML still parses (24 pins).
    - info.md: D2D prose marked deferred with real anchor-byte behaviour; added an
    as-built pin map table; external-hardware D2D section marked future.
    Documentation + metadata only; no RTL/test changes.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
2026-06-02 test+ci: Loop 112 -- pinout-consistency guard (info.yaml/info.md vs RTL)
    Prevents the Loop 111 pin-doc drift from recurring.
    - test/test_pinout_consistency.py: asserts 8/8/8 pin counts, RTL port directions,
    uio driven only on the anchor probe, no D2D logic in RTL, and (since D2D is
    deferred) every D2D doc mention carries a deferral marker (ADR-0006) + info.md
    documents the uio anchor byte. 14 checks; pure stdlib (no PyYAML).
    - Mutations caught: phantom-D2D doc claim (rc=1), injected D2D RTL signal (rc=1).
    - CI: +1 step (19 verification gates).
    [test_pinout_consistency.py]
2026-06-02 gen+doc: Loop 115 -- fix stale gate count (derive it), add verification badge
    - gen_verification_matrix.py: CI_GATES was a hand-list (18) missing
    test_characterize_timing (L108) + test_pinout_consistency (L112); now DERIVED
    from run_verification_gates.discover() = 20 (self-correcting, no future drift).
    - Regenerated VERIFICATION.md / verification.json (now 20 gates).
    - Added docs/verification-badge.json (shields endpoint: "17 decoders - 20 gates -
    592,308 codes"), freshness-gated with the other artifacts; README badge.
    - README "18 CI gates" -> "20".
    All 20 gates green; freshness gate covers 3 artifacts.
    [test_verification_matrix_fresh.py]
2026-06-02 test+fix: Loop 117 -- doc-count consistency guard; fix 2 self-reference bugs
    - test/test_doc_counts_consistency.py: asserts prose counts (decoders/formal/
    cocotb/post-silicon/GL/CI-gates) in README/PLAN/info.md/POST_SILICON_PLAN match
    computed actuals. 11 claims checked; mutation -> rc=1. Auto-discovered (no CI edit).
    - Fixed self-reference bugs found while building it:
    * guard counted its own @cocotb.test() literal -> count only files with a
    module-level cocotb import;
    * run_verification_gates.discover() skipped the new gate (its comment contains
    "import cocotb") -> match module-level import regex, not the substring.
    - Gate count 20 -> 21 (auto-derived): dossier/json/badge +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
    [test_doc_counts_consistency.py]
2026-06-02 test: Loop 118 -- guard the on-die counts (22 indices, 17 decoders) in prose
    Extends the Loop-117 doc-count guard to pin two more hand-typed numbers:
    "22 on-die format indices" (info.md) and "17 on-die decoders" (PLAN), both
    computed from the CATALOG (FLAG_ON_DIE / *_decode.v). 13 count-claims now checked,
    all pass; mutation (22->23) -> rc=1. Gate count unchanged (21).
2026-06-03 doc: Loop 120 report -- five gfN_mul rungs fixed (7/9 correct, gamma)
    Records the gf20/24/32/64/128 mul fix (shared width/normalize bug) done in the
    tt-trinity-gamma sibling: exponent probe OK + 7200-pair exact-rational value
    sweep at 0.5 ULP each. Corona RTL untouched.
2026-06-03 doc: Loop 121 report -- GoldenFloat ladder complete (gf4+gf12 fixed, CI gate)
    Records completing the arithmetic arc in tt-trinity-gamma: gf4 (256/256
    exhaustive) + gf12 (add 0.625 / mul 0.5 ULP) fixed, full ladder verified, suite
    wired into CI (goldenfloat-arith job). Side finding: gf16_add legacy imprecision.
    Corona RTL untouched.
2026-06-03 spec: license-origins cleanup in corona_oracle.t27 (ADR-0009)
    Tier-1 module table previously listed FloPoCo/OpenCores/Coleman/Hunhold
    as RTL origins. Direct audit of src/rtl/*.v shows all 14 decoders are
    Apache-2.0 hand-rolled behavioural models authored in this repo.
    - Rewrite TIER1_MODULES license comments to reflect reality
    - Drop takum16_decode slot (Tier-2 ROM-only per ADR-0003), 12->11
    - Fix posit64 + lns inline comments (no FloPoCo / no Coleman)
    - nf4_decode credit: 16 N(0,1) quantiles from bitsandbytes (MIT, de minimis)
    - Add ADR-0009 documenting the cleanup
    No RTL change. Documentation-only.
2026-06-03 doc: P3109 mapping page -- Corona slot <-> binary8 p1..p7 cross-walk
    Draft cross-walk between IEEE P3109 binary8 family (v3.2.1, draft, 2025)
    and the Corona 80-format index. Proposes an optional p3109_binding 4-bit
    field repurposing the reserved bits of FIELD_FLAGS [7:4] in rom_layout.t27,
    with a CI gate to keep catalog-claimed P3109 IDs honest.
    Document explicitly:
    - is NOT a compliance claim (no silicon yet)
    - is NOT a P3109 endorsement of GoldenFloat
    - lists 4 open questions for the P3109 WG
    Cross-cites Fitzgibbon/Wintersteiger/Sarnoff (2025), FLoPS Lean
    formalization (arXiv:2602.15965), Micikevicius (2022), Rouhani (2023),
    Hunhold (2024).
2026-06-03 doc: Loop 123 report -- GF256 fixed, whole gf4..gf256 ladder verified
    Records closing the last GoldenFloat gap in tt-trinity-gamma: GF256's exclusion
    rationale ('bias conjecture') was wrong; real bug was EXP_MAX off-by-one (dead
    Inf/NaN detection) + mul width. Regenerated, now probe 9/9 + sweeps + specials.
    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
2026-06-03 audit: cross-die GoldenFloat check -- Phi+Euler carry the same 9-rung bugs (off compute path)
    The .t27 code-gen produced the gfN arithmetic for all three SKY26b dies (Gamma,
    Phi, Euler). Gamma was fixed loops 119-124; this audits the siblings.
    tools/cross_die_gf_audit.py probes each die's gfN_add via iverilog (1+1 exponent +
    overflow->Inf round-trip), read-only. Result: Gamma 0 buggy rungs, Phi 9, Euler 9
    (gf4/8/12/20/24/32/64/128/256; only gf16 ok on all three) -- Phi/Euler match
    Gamma's pre-fix state exactly.
    Risk: the Phi/Euler silicon top-levels instantiate ONLY gf16 (gf16_dot4 /
    trinity_gf16_tile); the nine buggy units are NOT instantiated anywhere -- standalone
    spec RTL never wired i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
2026-06-03 doc: Loop 125 report -- cross-die GoldenFloat audit (Phi/Euler carry same bugs, off compute path)
    Records the fresh cross-die scan: Phi+Euler ship the same 9-rung gfN bugs as
    Gamma's pre-fix, but the buggy units aren't on their silicon compute path (gf16
    only), so shipped chips are unaffected. tools/cross_die_gf_audit.py + docs added.
2026-06-03 doc: Loop 127 -- ACTIVE silicon gf16_mul rounding-overflow defect found (0.072% of products halved)
    Full-design verilator lint from the silicon top found SELRANGE in gf16_mul
    (mant_rounded[9] on a [8:0] reg) on all 3 dies -- gf16_mul is on the MAC path via
    gf16_dot4. test/gf16_mul_silicon_bug.py: 0.072% of normal products halved. Hits the
    validated near-1.0 workload (unlike prior caveats) -> strengthens respin case. Fix
    exists+verified (gf16_v2_mul). CROSS_DIE_GF_AUDIT bottom line corrected.
2026-06-03 audit: triage full-design lint -- 10 benign WIDTHTRUNC, 1 real bug (bitnet neuron_base aliasing)
    Triages every WIDTHTRUNC from the full-design lint (loop 127). 10 are benign
    Verilog-2005 "shift then mask to a narrow wire" idioms (mask guarantees the
    truncated bits are zero -> lossless): gf16_popcount{,16}, vsa_matmul_{8x8,16x16},
    blake3_anchor, bitnet_encoder:57.
    1 is a real bug -- bitnet_encoder.v:92: ternary_dot's neuron_base is [9:0] (10-bit)
    but Layer 1 calls it with k*64 up to 1984 for k=0..31, so it truncates mod 1024 and
    all 16 upper neurons alias a lower one (h1[k]==h1[k-16]); the 64->32->8 demo realizes
    only 16 distinct hidden neurons. Instantiated on Gamma + Euler silicon tops (no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
2026-06-03 doc: Loop 130 -- gf16_mul end-to-end impact (~11x MAC RMS degradation)
    Impact study on gf16_dot4: shipped gf16 MAC runs at ~1.22% RMS vs ~0.11% with the
    gf16_mul fix alone (~115x NMSE). The mul defect dominates the MAC error despite a
    0.27% dot footprint (halving a term). Strengthens the respin case; verified fix =
    gf16_v2_mul. (gamma test/impact_gf16_mul.py)
2026-06-03 doc: respin decision brief -- consolidates the gf-arithmetic audit (loops 119-130)
    One-page go/no-go: two active on-silicon defects (gf16_mul rounding-overflow = ~11x
    MAC RMS, all 3 dies; bitnet neuron-base aliasing = 16/32 neurons, gamma+euler), both
    with verified v2 fixes now staged on every affected die. Per-die exposure matrix +
    checked-and-cleared list (gfN spec units off-path, converters dead code, Corona lint
    clean). Recommendation: gf16_mul is the numerical respin driver; fixes are free to
    fold into any next shuttle.
2026-06-03 doc: Loop 131 -- respin brief consolidated; gf16_v2 fixes staged on all 3 affected dies
    Built the one-page respin go/no-go (RESPIN_BRIEF_gf_arithmetic.md) and closed the
    staging gap: ported verified gf16_v2_mul/add to phi + euler (gf16_mul defect is on
    all 3 dies via gf16_dot4). Every affected die now has its drop-in fix staged.
2026-06-03 doc: Loop 132 -- gf16_v2 fix now CI-gated on all 3 affected dies (arc closed)
    Ported gf16_v2_verify.py + a gf16-fix-verify CI job to phi (887c7ec) + euler
    (22b8035), so the staged gf16_v2 fix is verified on every gf16_mul-affected die (was
    gamma-only). Arc 119-132 fully closed: found->characterized->impact->fixed->gated->brief.
2026-06-03 doc: Loop 133 -- gf16_mul task-level impact ~0.24% prediction flips (tempers respin case)
    Built a 10-class linear-classifier harness (dot16 from gf16_dot4); the gf16_mul
    defect changes the predicted class on ~0.24% of inputs (gf16 floor ~0.12%), so the
    ~11x MAC RMS largely washes out at argmax. Respin brief updated: real defect, free
    fix, not an emergency. (gamma 9b45fa6)
2026-06-03 doc: Loop 135 -- canonical gf16_add root-cause fixed in t27 master (+ golden_tests runnable)
    Completed the GF16 master fix: t27/rtl_gen/gf16_add.v replaced with the verified
    gf16_v2_add (0 diffs over 41286 pairs); fixed 2 pre-existing golden_tests.py crashes.
    With L134's gf16_mul fix, both canonical GF16 ops are now correct (t27 58496433).
    Frozen dies untouched. gh auth broken + a new traceability hook noted.
2026-06-03 doc: Loop 139 -- width-defect-gate wired into CI on all 3 dies
    The recurring 'field one bit too narrow' class is now CI-guarded: test/width_gate.py
    + a width-defect-gate job on gamma/phi/euler verilator-lint src/*.v and fail on any
    new value-overflow/SELRANGE (frozen gf16_mul allow-listed). detect->fix->gate
    complete. (gamma 3a1eb29, phi 16f3128, euler 404529b)
2026-06-05 doc: Loop 142 -- vsa-functional CI gate added (gamma+euler); both compute paths now CI-guarded
    'Do everything': wired the VSA ternary-matmul functional test into CI on gamma+euler
    (phi has no VSA, correctly excluded). Real-workload delta (C) still needs external
    model/dataset; harness ready. Both on-silicon compute paths now have standing CI
    gates. gamma 31e7e76, euler 6995d27.
2026-06-05 doc: Loop 146 -- THIRD active silicon defect: blake3_anchor G() missing all 4 XORs (crypto)
    Fresh subsystem audit found the on-die DePIN RECEIPT signer blake3_anchor implements
    BLAKE3 G() without the XOR diffusion steps -> near-linear, not preimage-resistant
    (security claim false). Active on gamma+euler (u_hash). Verified shipped==no-XOR model,
    v2==real BLAKE3-G; blake3_anchor_v2 staged (gamma 01443ee, euler 09fd314). Added as
    Defect 3 (a security driver) to the respin brief.
2026-06-05 doc: Loop 150 -- B mostly empty (modules not in t27); wired audits into CI
    bitnet/blake3/multi_tile/alu9 are die-local (not in t27 master) so no upstream
    regen lever; only gf16 had one (done). Redirected to wiring the loop 146-149
    conformance audits into CI as standing two-sided regression gates on both dies.
2026-06-05 doc: Loop 151 -- Phi die audited; phi_d2d_lite RX framing bug (latent, single-die)
    Extended the instantiated audit to the third taped-out die (Phi/nano). POST/
    sacred-ROM/mesh-bridge correct; phi_d2d_lite die-to-die RX needs a 2-cycle start
    but TX emits 1 cycle -> receive path non-functional (latent: no second die in this
    shuttle). All three compute dies' instantiated logic now audited + CI-gated.
    Option B (t27 backport) closed: the die-local modules aren't in the codegen master.
2026-06-06 doc+tool: Loop 153 -- audit capstone (AUDIT_COMPLETE.md + fix-coverage invariant)
    Verified the deliverable itself: tools/fix_coverage_matrix.py confirms every die
    that instantiates a buggy module also carries its staged v2 fix -> COMPLETE (no
    respin gap). Added docs/AUDIT_COMPLETE.md: single index of the full 4-die audit --
    defect/fix matrix (3 active + 3 latent), checked-and-clear list, every audit script
    + CI job, re-run instructions. Cross-linked from the respin brief.
2026-06-06 doc: Loop 154 -- staged v2 fixes verified respin-ready (R-SI-1/width/latch clean)
    Verified the staged fixes meet respin design rules, not just functional correctness:
    R-SI-1 clean (no datapath *), free of harmful width-defect class, no inferred
    latches. Fixed one EOFNEWLINE nit (gamma bitnet_encoder_v2). Recorded respin-
    readiness in AUDIT_COMPLETE.md.
2026-06-06 tool: Loop 155 -- one-command full-audit runner (tools/audit_all.py)
    Runs every instantiated-subsystem conformance audit across all four dies + the
    cross-die fix-coverage invariant, printing a single pass/fail summary (12/12 PASS).
    Reviewer/program entry point behind RESPIN_BRIEF + AUDIT_COMPLETE.
2026-06-06 doc+tool: gf16 rounding-mode conformance characterized (last open numerical item)
    tools/gf16_rounding_conformance.py: exhaustive (262144 unit-exp products) -- RTL is
    ties-to-zero (100%), spec intends ties-to-even, encode_f32 is half-up; gap to intent
    744/262144=0.28%, 1 ULP, ties only. docs/GF16_ROUNDING_CONFORMANCE.md documents the
    three-way discrepancy + resolution (gf16_v3_mul = ties-to-even staged; frozen
    silicon = ties-to-zero; t27 encode_f32 comment-vs-code inconsistency flagged).
    Task-immaterial per Defect-1 studies.
2026-06-07 fix(rom): align Cluster 3 GF rungs with closed-form rule (8 corrections, GF16=1+6+9 silicon match) (#3)
    * fix(rom): align Cluster 3 GF rungs with closed-form rule
    Eight GoldenFloat rungs in tools/gen_rom.py CATALOG violated the
    normative closed-form rule from t27 SSOT FORMAT-SPEC-001 v1.2:
    e = round((N - 1) / phi^2)
    m = N - 1 - e
    Corrected:
    Format | Before (E,M) | After (E,M) | Rule
    --------+--------------+-------------+----------------
    GF16 | 5, 10 | 6, 9 | round(15/phi^2)=6 (FROZEN SILICON match)
    GF24 | 8, 15 | 9, 14 | round(23/phi^2)=9
    GF32 | 11, 20 | 12, 19 | round(31/phi^2)=12
    GF48 | 16, 31 | 18, 29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
    [fv_rom.sv, tb_rom_golden.v]
2026-06-07 doc: ready-to-apply ties-even proposal + measured blast radius (1/36 vectors, 1 ULP)
    Packages the gf16 software ties-to-even change set (gf16.t27 encode_f32 + gf16_ref.py
    + optional gf16_round) with the measured blast radius: only 1 of 36 conformance
    vectors changes (planck_reduced, 1 ULP exact tie), 0/200k random values differ. Not
    applied to the live baseline -- a conformance-gated owner decision; the verified RTL
    variant gf16_v3_mul is already staged. Companion to GF16_ROUNDING_CONFORMANCE.md.
2026-06-07 fix(tools): cross_die_gf_audit gf128 field split 48/79 -> 49/78 (SSOT closed-form)
    Aligns the cross-die GF audit's gf128 decode layout with the corrected SSOT rule
    (round(127/phi^2)=49 -> E49 M78). Re-run: 0/0/0 buggy rungs across gamma/phi/euler.
2026-06-08 tool: GF ladder three-way consistency (closed-form == catalog == RTL) + wire into audit_all
    End-to-end spec<->ROM<->RTL check across the whole GoldenFloat ladder: every rung's
    (E,M) split agrees across the SSOT closed-form rule, the corona gen_rom.py catalog
    (post #3), and the gamma RTL units. RESULT: CONSISTENT for all 16 rungs (GF4..GF256,
    incl. the gf128 E49 M78 fix and the new gf6/10/14/48/96). Added to audit_all.py
    (now 13/13). Cross-repo tool (reads sibling gamma RTL) -- run from corona.
2026-06-08 doc: NEXT_WAVES.md -- roadmap + status (Wave-5 full BLAKE3 done; respin set; GF512/1024; power waves)
2026-06-08 doc: NEXT_WAVES -- power/sparsity waves audited (sparse_skip ok; stoch_round_v2 fix)
2026-06-08 doc: NEXT_WAVES -- power waves 39-42 fully audited (5 correct + opcode-width fix)
2026-06-27 chore(ci): pre-create verilator-lint log stub (tt-gds-action workaround) (#4)
    The Linter output step in TinyTapeout/tt-gds-action@ttgf26a does
    'cat runs/wokwi/*-verilator-lint/verilator-lint.log' but LibreLane
    on this ref does not always produce that file, which makes the
    whole job fail under set -e -o pipefail.
    Pre-create the file with stub content so the cat succeeds and the
    hardening flow continues. Upstream issue is being filed separately
    in TinyTapeout/tt-gds-action.
    Affects 4 consecutive main-push failures in this repo.
2026-07-09 sync: decode RTL fixes from trinity-fpga (fp6_e3m2 saturation, timescale, default_nettype)
    [fp6_e3m2_decode.v]
2026-07-31 docs: Corona was never submitted — remove the expected-silicon claim (#7)
2026-08-10 fp6_e3m2: exponent 7 is a number, not a reserved encoding (#9)
    The decoder clamped the entire top exponent group to 14.0, so 16, 20, 24 and
    28 all decoded as 14 and so did their negatives -- 8 of 64 code points,
    including the format maximum.
    FP6 E3M2 reserves no encodings at all. Exponent 7 is an ordinary exponent
    (E = 7-3 = 4), so the top group holds four ordinary values and the maximum is
    1.75 * 2^4 = 28.0. OCP MX does say conversion saturates rather than producing
    Inf, but that is a rule about the ENCODER: decoding a code point that carries
    the top exponent is just reading a number. The convention that was borrowed
    belongs to FP8 E4M3/E5M2, which do reserve their top exponent.
    This was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
2026-09-05 docs: no TRI-NET die exists, so the chain ends at GDS
    Publications refresh, 2026-09-05 (adds to PR #10).
    - Corona is a chip design that was never fabricated (the table above already says NOT SUBMITTED); the prose no longer calls it a silicon chip, and the mechanical chain reads SSOT -> codegen -> RTL -> GDS.
    - Phi, Euler and Gamma: the TTSKY26b submission was withdrawn before fabrication and no die exists. Phi's status drops from [Verified] (defined here as confirmed on physical silicon) to [Verified in sim], the tag this repo already uses for the anchor.
    - Gates re-run locally: test/test_doc_counts_consistency.py ALL PASS; the CI banned-word scan finds nothing in README.md.
    Co-Authored-By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
2026-09-05 docs: three leftovers still spoke of a Corona die that was never made
    Publications refresh follow-up, 2026-09-05 (adds to PR #10).
    - post_silicon/POST_SILICON_PLAN.md: the Timeline still read "Chip expected
    ~2026-10-01 / Delivery to participants ~2026-11-15" as if it were a forecast.
    A dated status now says no Corona die exists and TTGF26a was not submitted;
    the two dates stay, labelled as the original plan and not a forecast.
    - docs/info.md: decode latency was "confirmed on silicon". There is no silicon;
    this repo's evidence is cocotb and gate-level simulation, so it says that.
    (The Artix-7 FPGA prototype belongs to trinity-fpga; nothing in this repo
    shows Corona's protocol run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
2026-09-05 docs: the provenance note's open action items still fixed 83 as the canon, and five other traces of a die that was never made
    docs/FORMAT_COUNT_PROVENANCE.md (Russian kept): the three June action
    items were still open and named 83 as the canon. All three are now
    closed or obsolete, each with what was verified on 2026-09-05: t27
    untracked gen/numeric/formats_catalog.json on 2026-06-14 (aa01dd4f1,
    "drift 77 vs SSOT 83", #1120) and the file no longer exists on master;
    the Corona repo description no longer carries a format count; the
    arXiv:2606.09686 v2 abstract already says 83 (84 appears nowhere) and
    v3 (submitted 4 Sep 2026, announces 7 Sep 2026) carries 109 under the
    title "Golden Ruler: ...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
